HuaqiuOpenHardware/Comake-Pi-D2/enclosure/README.md

# 外壳/结构件说明

请在上传前检查解压内容中是否包含 `.stl`、`.step`、`.stp`、`.iges` 等外壳或结构件文件。

如果原项目没有提供结构件资料，本目录可仅保留此说明文件。
