HuaqiuOpenHardware/Comake-Pi-D2/REVIEW_CHECKLIST.md

# 上传前检查清单

- [ ] 仓库名已确认：`Comake-Pi-D2`
- [ ] GitHub About 已确认：星宸科技 AI 开发板 Comake Pi D2：用于便捷类相机、可穿戴设备、智能家居、无人机等应用市场低功耗轻量级端侧 AI 产品。
- [ ] 项目标题正确：Comake Pi D2
- [ ] 项目作者正确：星宸科技(SigmaStar)
- [ ] 开源协议正确：GPL 3.0
- [ ] README 封面图、原理图和 PCB 图显示正常
- [ ] `hardware/`、`docs/`、`assets/`、`enclosure/` 分类合理
- [ ] 解压目录无不应公开内容
- [ ] README 已经人工检查并确认
- [ ] 确认后再上传 GitHub
