HuaqiuOpenHardware/Comake-Pi-D2/hardware/pcb/Comake-Pi-D2-V1.0_BGA8_9.5_Demo_20251215/extracted/Comake-Pi-D2-V1.0_BGA8_9.5_Demo_20251215/资料阅读指南.pptx

启动方式选择/注意事项


以选SPI Nor SKIP SD启动为例：先选中对应行之后可以知道M3：0选为1111


M3:0的高低电平选择，决定了SOC是从哪种存储介质启动
1. 启动方式没有选择SKIP SD，则任意启动方式都可以从SD卡烧录，注意这里的SD要接在PAD_SD0,不能是任意SD
2. 没有选择SKIP SD启动比SKIP SD启动会多一些时间（200ms左右，实测为准）
3. 任意启动方式都可以从USB升级/空片烧录

## Slide 2

HW Checklist 阅读-IO MAPPING/MISC_Table

●HW Checklist里面的IO Mapping本身为我司DEMO Board IO功能分配所制作的表格，方便快速核查DEMO
接口用法，简单罗列了所用IO的内部上下拉状态、复用功能

●HW Checklist里面的MISC_Table为该IC所有IP的复用表，如下以I2C0复用为例：
1. 先选中功能行，在功能行中搜索I2C，可以自动定位到如下位置，可以看到有I2C0/I2C1/I2C2三个IP


2. I2C0的不同mode代表复用在不同的GPIO上面，这里以mode2
为例，表示I2C0 想复用在PAD_GPIO0/1上面需要软件选为mode2
，想复用在PAD_PM_GPIO0/1上面就选为mode3
3. I2C0只能复用在表中有的mode对应的GPIO上面，不能任意更改
4. 如已经选择mode2复用在PAD_GPIO0/1上面，则其他mode也不
能使用了


## Slide 3

HW Checklist 阅读-PM与NON-PM

1. 在Checklist中的MISC_Table_PM_List 与MISC_Table_PAD_list在没有单独使用CM4的情况下可以合并使用
带PM的GPIO功能受CA32内核控制，不用特别区分功能差异
2. 原理图或者规格书中GPIO名字带PM字样的均属于CM4核的IO，可以被CA32控制，也可以CM4单独控制

## Slide 4

HW Checklist 阅读-GPIO_Ctrl_Reg_Table

●GPIO_Ctrl_Reg_Table 包含GPIO默认内部上下拉，驱动电流大小调整方式等内容

●Reset Value即为SOC上电完成后，软件还没起来时刻IO的默认状态，下图表示该PAD_I2C1_SDA 默认是输入
内部有上拉电阻

●Internal pull up/down resister显示内部上下拉电阻值大小，精度一般在±30%，下图表示Pad_I2C1_SDA的内部
上拉电阻为97KΩ（典型值），PE/PS表示软件设置上下拉的寄存器位置，例如这里的PE PS默认都是1，PS改为0则变
为下拉状态，阻值为96KΩ

## Slide 5

HW Checklist 阅读-GPIO_Ctrl_Reg_Table

●DRV表示该PAD_I2C1_SDA的驱动电流挡位以及对应寄存器位置为bank103e 00 bit7/ 01 的bit8位置

●这里详细介绍一下GPIO的输入输出设定方法：所有输入默认电平都由内部和外部上下拉状态决定，输出为推挽方式
可以理解为与上下拉关系不大，为强输出

●bank103e 00 bit2位置为0表示该GPIO为输出状态，此时看OUT位置的bank103e 00 bit1，设为1则输出高，设为
0则输出低电平；如00 bit2为1则该GPIO为输入状态，读取IN下面的 bank103e 00 bit0状态可以确认外部电平状态，
此时如果引脚悬空，读取的状态为内部上下拉电阻状态决定

## Slide 6

HW Checklist 阅读-MIPI_RX_VIF

●MIPI RX_VIF 为SOC默认的MIPI线序，建议使用默认推荐线序，方便软件调试


## Slide 7

D2底板改为MIPI2+2 rework方式

●参考Pi D2 硬件说明3.1.15章节


●Rework完效果
