HuaqiuOpenHardware/Comake-Pi-D2/hardware/pcb/WQ7036平台硬件IO资源分配表.xlsx

电平 | P-Num. | NAME | Deepsleep模式下状态 | 设计应用注意点特别说明 | 方案实际设计应用 | 说明/备注 | 功能
外部供电3.3/1.8V | A17 | GPIO00（3.3/1.8V）/TCK | PD | JTAG | SPI/PDM/I2S/UART/PWM/TCK | EMMC_GPIO0 | EMMC1.8V控制
 | C17 | GPIO01（3.3/1.8V）/TXD0 | PU | 下载专用 | UART_TXD烧录专用 | SOC_UART_RX-1.8v | TWS串口
 | A16 | GPIO02（3.3/1.8V）/RXD0 | PU | 下载专用 | UART_RXD烧录专用 | SOC_UART_TX-1.8v
 | B15 | GPIO03（3.3/1.8V）/TMS | PU | JTAG | SPI/PDM/I2S/I2C/UART/PWM/TMS | SEL2 | USB SW选择
 | B16 | GPIO04（3.3/1.8V）/TDI | PU | JTAG | SPI/PDM/I2S/I2C/UART/PWM/TDI
 | D17 | GPIO05（3.3/1.8V）/TDO | PD | JTAG | SPI/PDM/I2S/UART/PWM/TDO | PWR_L_EN | 光敏电源控制
外部供电3.3/1.8V | N10 | AON_GPIO0/GPIO93 | PU/可配置 |  | SPI/PDM/I2S/I2C/UART/PWM | GPI | SENSOR_GPI
 | M10 | AON_GPIO1/GPIO94 | PU/可配置 |  | SPI/PDM/I2S/I2C/UART/PWM | I2S_WS | 传声音给309
 | N11 | AON_GPIO2/GPIO95 | PU/可配置 |  | SPI/PDM/I2S/I2C/UART/PWM | I2S_DATA
 | M11 | AON_GPIO3/GPIO96 | PU/可配置 |  | SPI/PDM/I2S/I2C/UART/PWM | I2S_BCK
 | M12 | AON_GPIO13/GPIO101 | PD/可配置 |  | SPI/PDM/I2S/I2C/UART/PWM | V_GPIO4 | DDR 电源控制
 | M13 | AON_GPIO14/GPIO102 | PD/可配置 |  | SPI/PDM/I2S/I2C/UART/PWM | GPO | SENSOR_GPO
 | M14 | AON_GPIO15/GPIO103 | PD/可配置 |  | SPI/PDM/I2S/I2C/UART/PWM | V_GPIO2 | wifi_1.8控制
内部供电1.8V | E4 | ADC0/GPIO105 | PD | 1、作ADC时量程0.1V ~ 1.15V | SPI/PDM/I2S/UART/PWM/ADC | V_GPIO3 | Sensor电源控制
 | E5 | ADC1/GPIO106 | PD |  | SPI/PDM/I2S/UART/PWM/ADC | SPI_CK | 收小图
 | B7 | ADC2/GPIO107 | PD |  | SPI/PDM/I2S/UART/PWM/ADC | SPI_DO(OUT)
 | B8 | ADC3/GPIO108 | PD |  | SPI/PDM/I2S/UART/PWM/ADC | SPI_CS
 | A9 | ADC4/GPIO109 | PD |  | SPI/PDM/I2S/UART/PWM/ADC | SPI_DI(INPUT)
 | A10 | ADC5/GPIO110 | PD |  | SPI/PDM/I2S/UART/PWM/ADC | TWS_GPIO1
 | J4 | NC | / |  | /
 | M5 | TK2/GPI99 | 可配置 | 做数字IO时只能做输入 | Touch/GPI
 | N6 | TK3/GPI100 | 可配置 | 做数字IO时只能做输入 | Touch/GPI | KEY | 按键拍照录像
 | M6 | TK4 | / | 只能做TOUCH | TOUCH
 | N7 | TK5 | / | 只能做TOUCH | TOUCH
 | E13 | GPO32 | PU |  | SPI/PDM/I2S/I2C/UART/PWM | I2C_SCL-Light | 光敏IIC
 | J13 | GPIO33 | PU |  | SPI/PDM/I2S/I2C/UART/PWM | I2C_SDA-Light
 | G13 | GPIO34 | PU |  | SPI/PDM/I2S/I2C/UART/PWM
 | G14 | GPIO35 | PU |  | SPI/PDM/I2S/I2C/UART/PWM
 | A14 | GPIO36 | PU |  | SPI/PDM/I2S/I2C/UART/PWM | INT_Light | 光敏中断
 | J12 | GPIO37 | PU |  | SPI/PDM/I2S/I2C/UART/PWM
 | J10 | GPIO38 | PU |  | SPI/PDM/I2S/I2C/UART/PWM | GPIO_NO
 | B14 | GPIO39 | PU |  | SPI/PDM/I2S/I2C/UART/PWM | LMICVDD_EN | MIC电源控制
 | E14 | GPIO40 | PU |  | SPI/PDM/I2S/I2C/UART/PWM | TWS_SOC_UART_TX | TWS_SOC交互串口
 | E12 | GPIO41 | PU |  | SPI/PDM/I2S/I2C/UART/PWM | TWS_SOC_UART_RX
 | A13 | GPIO44 | PU |  | SPI/PDM/I2S/I2C/UART/PWM | SEL1 | USB SW选择
 | B13 | GPIO45 | PU |  | SPI/PDM/I2S/I2C/UART/PWM | I2S_WCK
 | B12 | GPIO46/BootMode | PD | Boot strapping专用管脚 （需要上拉到VDD18才可下载） | BOOT | testpoint
 | A12 | GPIO47 | PD |  | SPI/PDM/I2S/UART/PWM | V_GPIO5 | 整机（除TWS）电源控制
 | A11 | GPIO48 | PD |  | SPI/PDM/I2S/UART/PWM | BT_WF0 | PTA
 | B11 | GPIO49 | PD |  | SPI/PDM/I2S/UART/PWM | WF_BT
 | B10 | GPIO50 | PD |  | SPI/PDM/I2S/UART/PWM | PWR_GY_EN | Gyso电源控制
 | E10 | GPIO51 | PD |  | SPI/PDM/I2S/UART/PWM | EMMC_GPIO1 | EMMC3.3V控制
 | E9 | GPIO52 | PD |  | SPI/PDM/I2S/UART/PWM | I2S_RX_DI(OUTPUT) | 传声音给309
 | E8 | GPIO53 | PD |  | SPI/PDM/I2S/UART/PWM | I2S_RX_WCK
 | E7 | GPIO54 | PD |  | SPI/PDM/I2S/UART/PWM | I2S_RX_BCK
 | M8 | GPIO55 | PD |  | SPI/PDM/I2S/UART/PWM | BT_WF1 | PTA
 | M9 | GPIO56 | PD |  | SPI/PDM/I2S/UART/PWM | BT_WF2
 | J5 | GPIO57 | PD |  | SPI/PDM/I2S/UART/PWM | V_GPIO1 | 309电源控制
 | G4 | GPIO58 | PD |  | SPI/PDM/I2S/UART/PWM | DMIC_L0_DATA2 | DMIC
 | J7 | GPIO59 | PD |  | SPI/PDM/I2S/UART/PWM | DMIC_L0_DATA1
 | J8 | GPIO60 | PD |  | SPI/PDM/I2S/UART/PWM | DMIC_L0_CLK
 | J9 | GPIO61 | PD |  | SPI/PDM/I2S/UART/PWM | OEB | USB SW使能
 | 设计应用注意项补充说明： 1、AON33/AON18电源在DS（关机状态）是不掉电的，设计应用时需要注意； 2、所有数字IO应用时需要注意DS状态下的上下拉状态是否会导致电路漏电或其他缺陷，这个很重要。注：PU/PD的上下拉Typ 80K 4、AON_GPIOXX和GPI97/GPI99/GPI100为Always active管脚，可作关机后中断输入唤醒源。注意GPI97/GPI99/GPI100作为数字IO时仅能做输入。 5、有两组IO（GPIO01~GPIO05和AON_GPIOXX）可通过外部供电输入决定其电平的（1.8V~3.3V可改）。其他数字IO都是固定1.8V
