HuaqiuOpenHardware/Comake-Pi-D2/hardware/bom/SSZ029D-S01D-D2_BOMLIST20260414.xlsx

Sheet: SSZ029D-S01C-D2_BOMLIST
Item | Name | Part | PCB Footprint | Reference | Quantity | 供应商 | 联系方式
______________________________________________
1 | 贴片电容 | 0.5pF/0201 | C0201 | WC12 | 1
2 | 贴片电容 | 1pF | C01005 | TWC52,TWC54,TWC55 | 3
3 | 贴片电容 | 1.2pF/0201 | C0201 | WC11 | 1
4 | 贴片电容 | 8pF | C01005 | C532,C533 | 2
5 | 贴片电容 | 10pF | C01005 | PC37,PC94,PC102,PC104,PC105,PC108 | 6
6 | 贴片电容 | 33pF | C01005 | TWC23 | 1
7 | 贴片电容 | 10nF | C01005 | PC127 | 1 |  |  | 新增
8 | 贴片电容 | 0.1uF/10V/X7R | C01005 | C116,C118,C123,C157,C159,C174,C178,C211,C227,C239,C413,C444,C965,C995,C1021,C1032,C1036,C1038,C1043,C1045,MC7,TWC12,MC12,PC16,TWC17,PC17,WC21,PC25,PC33,PC36,TWC58,PC66,PC68,TWC71,PC71,PC78,PC88,PC93,PC98,PC101,PC111,PC113,PC117,PC119,PC121,PC123,PC125,WC13,WC24,WC26,C103,MC2 | 52
9 | 贴片电容 | 1uF/10V/X5R | C0201 | PC67,C179,C180,C1025,C177,C237,C297,C1034,C1037,C1041,PC112,PC122,PC126,C973,MC11,WC1,TWC1,TWC2,TWC3,TWC4,WC5,SC5,WC6,TWC6,WC7,SC7,WC8,TWC8,WC9,TWC9,SC9,WC10,TWC10,TWC11,SC12,TWC13,SC14,WC15,WC16,TWC16,WC17,TWC18,PC18,TWC19,TWC20,PC20,TWC21,PC21,PC22,PC30,PC31,PC32,PC76,PC83,PC97,C496,C1024 | 57 |  |  | 新增2
10 | 贴片电容 | 2.2uF/10V/X5R | C0201 | C2,C127,C236,C1022,PC14,C102,C230,C994,C1044,MC1,MC4 | 11
11 | 贴片电容 | 2.2uF | C0402 | PC103,PC38 | 2
12 | 贴片电容 | 4.7uF/10V/X5R | C0201 | PC27,PC70,C1019,C1035,C136,C497,C964,C176,C1042,MC10,PC13,TWC24,TWC25,TWC26,PC7,SC6,SC8,SC10,SC11,SC13,TWC56 | 21
13 | 贴片电容 | 10uF/10V/X5R | C0201 | C124,C160,C161,C3,PC26,PC34,PC69,PC79,PC99,C1033,C228,PC8,PC5,PC6,TWC22,WC14,WC20,WC23,WC25,PC35,PC92,PC100 | 22
14 | 贴片电阻 | 0R | R0201 | PR105,PR107,PR113,PR123,PR129,PR134,PR136,PR142,R166 | 9
15 | 贴片电阻 | 0R_1% | R01005 | PR140 | 1
16 | 贴片电阻 | 0R | R01005 | SR26,SR27,SR28,SR55,SR59,SR60,SR61,R904,R937,SR17,SR18,PR150,R1576,R1577,R1579,R1581 | 16 |  |  | 新增5
17 | 贴片电阻 | 22R | R01005 | WR10,WR11,WR12,WR13,WR14,WR15,TWR18 | 7
18 | 贴片电阻 | 80.6/1% | R0201 | RM19 | 1
19 | 贴片电阻 | 100R | R01005 | WR17,WR18,R878,R879,R935 | 5
20 | 贴片电阻 | 240/1% | R01005 | RM18 | 1
21 | 贴片电阻 | 3K%1 | R01005 | PR148 | 1 |  |  | 新增
22 | 贴片电阻 | 3.3K | R01005 | R91,R96 | 2
23 | 贴片电阻 | 4.7K | R01005 | TR27,SR62,SR63,R650,R651,R938 | 6
24 | 贴片电阻 | 10K | R01005 | TWR1,WR2,TWR2,MR2,TWR3,SR3,TWR4,SR4,TR28,TWR33,TWR34,TWR43,TWR53,TWR55,TWR56,TWR57,PR143,PR144,R892,R893,R936 | 21
25 | 贴片电阻 | 12.4K%1 | R01005 | PR147 | 1 |  |  | 新增
26 | 贴片电阻 | 20K_1% | R01005 | PR108,PR135 | 2
27 | 贴片电阻 | 40K_1% | R0201 | PR109,PR137 | 2
28 | 贴片电阻 | 100K | R01005 | R933,R934,R1574,PR145,PR146 | 5 |  |  | 增加两个
29 | 贴片电阻 | 150K/1% | R01005 | WR9 | 1
30 | 贴片电阻 | 200K/1% | R01005 | WR8 | 1
31 | 贴片电阻 | 445K_1% | R0201 | PR10 | 1
32 | 贴片电阻 | 1M | R01005 | WR1 | 1
33 | 贴片电阻 | 1M_1% | R01005 | PR126,PR130,PR141 | 3
34 | 贴片电阻 | 1.2M_1% | R01005 | PR132 | 1
35 | 贴片电阻 | 2M_1% | R01005 | PR138,PR139 | 2
36 | 贴片电感 | SDHK100608HA4RTMTY01 4.7uH 0.5A | PIM100608 | TWL2,TWL4,TWL6 | 3
37 | 贴片电感 | MWTC160808S2R2 2.2uH 1.2A | PIM160808 | PL6,PL8,PL9,PL10,PL7,PL11 | 6
38 | 贴片电感 | SDHK1608HB100MT 2.2uH 2.3A | PIM201208 | WL4 | 1
39 | 贴片磁珠 | 1nH | L0201 | WL2 | 1
40 | 贴片磁珠 | 2.7nH | L0201 | WL1 | 1
41 | 贴片磁珠 | 18nH It 200mA | L0201 | TWL1,TWL3,TWL5 | 3
42 | 贴片磁珠 | 60R | L0201 | FB1 | 1 |  |  | 新增
43 | 贴片磁珠 | 1K@100M | L0201 | TWR19,TWR20 | 2
44 | PMOS | PMOS_VGSth<1.8V/AW402030 | DFN1006 | TWQ3 | 1 | 艾为
45 | NMOS | AW402010/PNM3FD20V2 | DFN1006 | TWQ1,TWQ2,TWQ4,TWQ11,TWQ12,TWQ13,TWQ14,TWQ15,TWQ19,Q30 | 10 | 艾为
46 | 24pin贴片母座 | BK13C06-24DS/2-0.35V | SMD-28-DS | SJ3,SJ4,SJ0 | 3
47 | USB3.0座子 | USB_TypeC_Part No: USB-24P-9_95-C | USB-24P-9_95-C | J1 | 1
48 | miniwifi天线座子 | IPEX4 | Minii-RF | JT1 | 1
49 | 贴片晶体 | Crystal/[24MHz,8pF,∮10ppm]; /XT114-10 | 24M8PI-1.6X1.2 | Y1,X2 | 2 |  | 裕中科技
50 | 贴片晶体 | Crystal/[32MHz,8pF,∮10ppm]/XT114-10 | 32M8PI-1.6X1.2 | Y2 | 1
51 | 贴片蓝牙天线 | BT ANT | YF1608 | U4 | 1
52 | 光敏IC | OPT3004 | DNP-6 | U5 | 1
53 | EMMC | BWCTL0211X32G/FEM6NN064G-A3N14 | IC-0.5MM153P-FBGA-S | MU1 | 1 | 金士顿/佰维/SCY/江波龙
54 | DCDC | TMI3181D | DFN1.6 | PU3,PU8,PU9,PU10,PU11,PU12,PU13 | 7 | 拓尔
55 | TWS IC | WTS | WQ7036A/AX | TWU1 | 1 | 物琪
56 | ISP | SSC309QL | IC-242P-P05-8X9.5 | U1 | 1 | SIGMA
57 | USB Switch | AW35753 | WLCSP-12 | U2 | 1 | 艾为
58 | 数字功放 | AW88082 | FC9 | U3 | 1 | 艾为
59 | LS IC | AW39114 | FOWLP | U7 | 1 | 艾为
60 | Loadswitch | ETA7027CSE | WLCSP0.87X0.87 | U9,U13,U15,U16,U19,U20,U21,U22,U23 | 9 | ETA
61 | DCDC | TMI6038D-28 | DFN1X1 | U12 | 1 | 拓尔
62 | LDO | ETA5055V105DD1E | DFN1X1 | U14 | 1 | ETA
63 | LDO | TMI6011 | DFN3X3 | PU14 | 1 | 拓尔
64 | WIFI | SSW118GE | QFN60-5X5-04MM-S | WU1 | 1 | SIGMA
 | 差异化BOM：音频走SSC309QL
 | 删除如下位号物料
 | 贴片电阻 | 0R | R01005 | R1576,R1577,R1579,R1581 | 4
 | 增加如下位号物料
 | 贴片电阻 | 0R | R01005 | R1575,R1578,R1580 | 3

Sheet: NC
28 | NC/10K | R01005 | MR1,R876,R877 | 3
36 | NC/100nF | C0402 | PC29,PC38,PC73,PC95,PC109 | 5
39 | NC/100nF | C0201 | PC84,PC85 | 2
55 | NC | R01005 | TWR54,R89 | 2
57 | NC | R0201 | R165 | 1
93 | NC/22R | R01005 | WR16 | 1
65 | NC | C0201 | TWC5,TWC7,TWC57,TWC59,TWC60,TWC61,TWC68,TWC69,TWC70 | 9
62 | NC/30pF | C0201 | SC3,SC4 | 2
23 | NC/2.2uF_6.3V | C0201 | MC3 | 1
13 | NC | C01005 | C521 | 1
70 | SE_OUT | TP-0_8MM | TWP4 | 1
PR150增加
