HuaqiuOpenHardware/Comake-Pi-D2/hardware/bom/SSZ029D-S01D-D2_MAINBOARD_BOMLIST20260414.xlsx

Sheet: SSC309-S01C-D2-MAINBOARD_BOM_20
Item | Name | Part | PCB Footprint | Reference | Quantity | 供应商 | 联系方式
______________________________________________
1 | 贴片电容 | 22pF/6.3V/X5R | C0402 | PC19 | 1
2 | 贴片电容 | 0.1nF/6.3V/X5R | C0402 | C25,C26 | 2 |  |  | 新增
3 | 贴片电容 | 10nF/6.3V/X5R | C0402 | C4,PC127 | 2 |  |  | 新增1
4 | 贴片电容 | 47nF/10V/X5R | C0603 | C22,C23
5 | 贴片电容 | 0.1uF/6.3V/X5R | C0402 | PC2,PC14,PC22,PC27,C9,C11,SC12,C12,C14,C15,SC19.SC20,C17,C6 | 13
6 | 贴片电容 | 0.22nF/10V/X5R | C0402 | C24
7 | 贴片电容 | 1uF/10V/X5R | C0402 | PC12,SC2,SC5,SC8,SC10,PC11,SC13,SC15 | 8
8 | 贴片电容 | 2.2uF/10v/X5R | C0402 | C5 | 1
9 | 贴片电容 | 2.2uF/10v/X5R | C0603 | C19,C20
10 | 贴片电容 | 4.7uF/10V/X5R | C0402 | PC7,SC1,PC3,SC6,SC7,SC9,PC9,PC13,C1,SC14,SC16 | 11
11 | 贴片电容 | 4.7uF/10V/X5R | C0603 | C18,C21 | 2
12 | 贴片电容 | 10uF/10V/X5R | C0603 | PC15,PC8,PC5,PC23,PC4,PC6,PC10,C10,SC11,C16,C13,SC17,SC18 | 13
13 | 贴片电容 | 22uF/10V/X5R | C0805 | PC16,PC17,PC20,PC21,PC24,PC26,PC1 | 7
14 | 贴片电阻 | 0R | R0402 | SR1,R1,SR2,R2,SR5,SR6,SR7,SR8,SR9,SR10,SR11,SR12,SR13,SR14,SR15,SR16,SR17,SR18,SR19,SR20,SR21,SR22,SR23,SR24,SR25,SR26,SR27,SR28,SR29,SR30,SR32,SR35,SR36,R47,R56,R60,R62,R63,R64,R65,R66,R67,R68,R69,R70,R71,R72,R73,R76,R77,R78,R79,R80,R82,R83,R84,R85,R86,R87,R88,R91,R92,R93 | 63
15 | 贴片电阻 | 0R | R0805 | R49 | 1
16 | 贴片电阻 | 0R | L0603 | B1,B2 | 2
17 | 贴片电阻 | 22R | R0402 | R6,R17,R18,R19,R20,R21,R24,R25,R26,R27,R28,R29,R30,R31,R32,R33,R34,R35,R36,R37,R38,R51 | 22
18 | 贴片电阻 | 100R | R0402 | R4,R5,R13,R14,R15,R16 | 6
19 | 贴片电阻 | 1K | R0402 | R11,R9,R46,R52,R54 | 5
20 | 贴片电阻 | 2K | R0402 | R57,R95 | 2
21 | 贴片电阻 | 3K%1 | R0402 | PR148 | 1 |  |  | 新增1
22 | 贴片电阻 | 4.7K | R0402 | TWR1,TWR3,TR2,R12,R40,R41,R44,R45,R55,R58,R59,R74,R75 | 13
23 | 贴片电阻 | 10K | R0402 | R3,R10,R53,R89,R90,TWR33,TWR34 | 7 |  |  | 新增2
24 | 贴片电阻 | 12.4K%1 | R0402 | PR147 | 1 |  |  | 新增1
25 | 贴片电阻 | 47K | R0402 | PR4,PR7 | 2
26 | 贴片电阻 | 100K | R0402 | R7,R8,R50,R61,PR145,PR146 | 6 |  |  | 新增2pcs
27 | 贴片电阻 | 150K/1% | R0402 | PR1 | 1
28 | 贴片电阻 | 680K_1% | R0402 | PR6 | 1
29 | 卧式贴片座子 | CON2-H | CON2_125 | J2 | 1
30 | 插件座子 | Wafer/2.0mm/1*4p/Male | B2.0V-L4P | CON1,CON2,CON3 | 3
31 | 插件座子 | CON2-DIP-2.0mm | DIP1X02PM-80-V | CON4,CON5,CON6 | 3
32 | 插针 | Header/2.54mm/1*3p/180D/Male | JP-1X3 | JP2,JP52,JP53,JP54,JP55 | 5 |  |  | 增加2
33 | 插针 | 2pin 插针 | JP-1X2 | JP1,JP3 | 2
34 | 插针 | 4pin 2.54MM 插针 | JP-1X4 | JP56,JP57,JP58 | 3 |  |  | 新增
35 | 插针 | 双排16pin 插针 | JP-1X16 | J4 | 1
36 | 插针 | 双排18pin 插针 | JP-1X18 | J6 | 1
37 | 贴片座子 | FPC-CON10_Down_Type 1.0mm间距 | IL-FHR-10S | JP26 | 1
38 | 贴片座子 | FPC-CON6_Down_Type | IL-FHR-6S | JP27 | 1
39 | 贴片座子 | FPC-36-0.5MM-FL | FPC-36-0.5MM-FL | SJ1,SJ6 | 2
40 | 贴片座子 | CON10-0D5 | FPC10-0.5-2 | J5 | 1
41 | 贴片座子-公头 | BK13C06-24DP/2-0.35V | SMD-24-Male | SJ3,SJ4,SJ0 | 3
42 | 贴片座子-母头 | BK13C06-24DS/2-0.35V | SMD-24-DS | SJ5 | 1
43 | 按键 | TACT_SWITCH_90 | SW-4P-1102V | SW1,SW2 | 2
44 | USB座子 | USB_TypeC_Part No:USB24P-C317JD | USB24P-C317JD | J1 | 1
45 | LED灯 | LED/Blue_1.8V | LED-0603 | LED1 | 1
46 | 贴片电感 | 2.2uH/VMPI0420ED2R2MT/3A | VMPI0420ED2R2MT | L1 | 1
47 | 贴片Nmos | 2N7002 | SOT-23DGS | PQ1,PQ2,PQ3,PQ4,PQ5,Q1 | 6
48 | 陀螺仪 | Q6_ICM-42607 | LGA14_2.5X3.0 | U2 | 1
49 | 光敏 | OPT3004 | DNP-6 | U5 | 1 |  |  | 新增
50 | AMP IC | AW8737AQNR | WLQFN | U4 | 1 | 艾为
51 | IRCUT | TMII8113/MS3111S | SOT23-6 | U3 | 1 | 拓尔
52 | DCDC | TMI3411 | SOT23-5P | PU2 | 1 | 拓尔
53 | LDO | TMI6036-18 | SOT23-5P | PU1 | 1 | 拓尔
54 | 模拟开关 | ETA7027CSE | WLCSP0.87X0.87 | U1 | 1 | ETA
 | LDO | TMI6011 | DFN3X3 | PU14 | 1 | 拓尔

Sheet: NC
63 | NC/47K | R0402 | TR3 | 1
60 | NC/0R | R0402 | SR31 | 1
56 | NC/30pF | C0402 | SC3,SC4 | 2
54 | NC | R0402 | R39,R48 | 2
38 | NC/2.2uF/10V | C0402 | PC28 | 1
35 | NC/100nF | C0603 | PC18 | 1
7 | NC/0.1uF | C0402 | C8 | 1
4 | NC | C0402 | C2,C3,C6,C7 | 4
12 | RESET_LPC | DRILL126X100_L | H1,H2,H3,H4 | 4
13 | RES | TP-0_8MM | I2C2_SDA_GY,I2C2_SCL_GY | 2
62 | RESET_LPC | TP | TP1 | 1
