HuaqiuOpenHardware/Comake-Pi-D2/hardware/pcb/SSC309QL_BGA8_9.5_LPDDR4x For AI Glass_HW Checklist V1.2 .xlsx

Sheet: History
History
Version | Date | Change list
V1.0 | 2025418 | Initial Version.
V1.1 | 20260107 | 更新GPIO_Ctrl_Reg_Table 中对PAD_RX_CH PE/PS的reg位置描述
V1.2 | 20260113 | 更新MISC_Table_PAD_List的reg位置描述
V1.3 | 20260206 | 新版本兼容支持DMIC+AO
说明
MISC_Table_PAD_list是CA32对整个IC（包括CM4） IO复用关系说明
MISC_Table_PM_List 只是CM4 IO复用关系说明文档，CM4 IO在CA32断电情况下可以继续使用

Sheet: Schematic Checklist
 |  |  |  | 修改日期
 | Hardware Spec | V1.2
 | Main Chip
 | Date | 2026-01-13
 | Review
Item List | Test Item | No. | Description
1 | GPIOx | 1 | PAD_PM_GPIO4及PAD_PM_GPIO5 固定用做IDAC核心电压调整,分别用作VDD和CPU的调整，请勿用作其他用途
 |  | 2 | 带中断功能的GPIO口请查看《GPIO_Ctrl_Reg_Table》，注意需要中断输入时GPIO口的选定
 |  | 3 | GPIO的分配请尽量按照Demo板的分配来设计，软件统一性好，便于维护及更新
 |  | 4 | 在选定GPIO口时，要注意其功能使用，且详细核对我司芯片内部的默认上下拉状态，以防开机误动作
 |  | 5 | 芯片中各GPIO口的输出驱动电流大小在Datasheet中有标明，但若是作为灌电流时，部分GPIO最大为16mA，超过时请用三极管或MOS去控制
 |  | 6 | IC同一个信号会复用到不同的Pin脚上（如PWMx），若在其中一个Pin脚上使用了该信号，在另一个Pin上就用不了该信号功能了
 |  | 7 | PWMx有同步功能，保证4个PWM时序正确去控制电机，但必须为同一个Group去控制一个Motor，如：PWM0~3，PWM4~7
 |  | 2 | SAR_GPIOx和GPIOx信号若是跨板连接时，为提高其ESD能力，请在信号线上串10～33R电阻，推荐为22R，若是在板内，则可以不接该电阻
 | Uart | 1 | PM_UART_RX，PM_UART_TX固定用做debug使用（请在TX上增加4.7K上拉电阻,在TX/RX上串100R电阻以提高抗ESD能力），请勿用做其他用途
 | I2S | 1 | I2S接口中I2S_SDI为I2S Data Input，I2S_SDO为I2S Data Output，切勿弄错
 | I2C | 1 | I2C在使用时需要外部接上拉电阻，否则无法工作，其工作最大频率可以到400KHz
 | USB | 1 | USB默认为Host mode，用做WIFI功能，可通过软件配置改为Device mode，用做UVC功能
 | Audio | 1 | 若是有音频功放芯片时，需要一个GPIO口去控制功放芯片开启时间，避免音频开启时的POP声
 |  | 2 | Audio_IN是即可作为单端也可以作为差分使用，建议按照我司Demo board电路来设计，隔直电容靠近IC端放置
 | DMIC | 1 | 我司DMIC最多只能接两个Data Channel，即最多只能接4个DMIC，可以与AMIC同时接入
 | SPI | 1 | SPI-SDI接MOSI，SPI-SDO接MISO，其他做Master的SPIx口也是如此。DI为Master Out Slave In，DO为MISO，SPI_Slave mode下DI则为INPUT，DO为OUTPUT
 |  | 2 | PSPI只支持半双工模式，MSPI支持全双工
 |  | 3 | 我司SPI_CZ为Low Active，若是Device为High Active，则需要加一个NPN管做反向
 | SD Card | 1 | 需要使用SD卡功能时，SDx_CDZ和SDx_POWER_EN一定要接，缺一不可
 |  | 2 | PM_GPIO11芯片内部配为SD_POWER_EN，不能更改，该脚直接连P_MOS的栅极控制SD卡电源导通情况，Low Active
 | Reset | 1 | Reset 为 High active，确认设定是否正确
 | HW strapping | 1 | HW strapping如下图设置，请严格按照表格来配置，否则会无法启动
2 | Power Check | 1 | 检查电源IC及路径上串的磁珠、DC-DC功率电感规格和Caps是否符合电流的要求，走线尽量粗和短
 |  | 2 | 检查DC-DC反馈电阻阻值是否设置正确
 |  | 3 | 检查电源端对地电容耐压是否符合设计规格
 |  | 4 | 确认Core电压IDAC动态调压电路是否有预留，并确认开机时启动电压是否设定正确（default 0.9V启动）
 |  | 5 | SD Card的供电电路，请在靠近SD card connecter端对地加2Kohm/0402 (必要时会调整阻值)
 |  | 6 | AVDD18_AUD是IC内部Audio部分供电, 请和其他AVDD用磁珠隔离开，Audio部分电路请完全按照我司demo板电路来设计
 |  | 7 | AVDD18_ETH是IC内部PHY部分供电，建议和其他AVDD用磁珠隔开
 |  | 8 | Sensor的模拟电源要注意避免干扰源，防止被干扰，带来电源噪声，影响图像品质
 |  | 9 | SOC所有电源IO都要求必须给电
 |  | 10
3 | Crystal Check | 1 | 确认24MHz Crystal的规格，[24MHz，18pF，∮20ppm]，匹配电容容值是否正确
 |  | 2 | 确认RTC 32.768KHz Crystal的规格，[32.768KHz，12pF，∮20ppm]，匹配电容容值是否正确
 |  | 3 | 如果RTC不使用，XTAL_In和Xtal_OUT不可悬空，避免由于floating引入干扰，请短接后对地接一个100Kohm电阻
4 | Sensor Check | 1 | Sensor IO电平的电压固定只支持1.8V
 |  | 2 | 检查Sensor MCLK，注意是否有串10～33ohm匹配电阻，该电阻靠近芯片放置
 |  | 3 | DVP模式时检查Sensor PCLK，注意是否有串10～33ohm匹配电阻，该电阻靠近Sensor放置
 |  | 4 | 确认Sensor模拟电源AVDD是单独LDO供电，同时滤波电容需要大于22uF，做好防干扰处理
 |  | 5 | 检查Sensor和主控IC接口的正确性，请参考IO Mapping页面
 |  | 6 | I2C信号必须要有上拉电阻，并且要核对上拉电源是否正确
 |  | 7 | Sensor信号注意按照等长、差分、阻抗匹配等要求走线，保证信号完整性及抗干扰能力
 |  | 8

Sheet: PCB Checklist
 | Hardware Spec | V1.2
 | Main Chip
 | Date | 2026-01-13
 | Review
Item List | Test Item | No. | Description
1 | Power Check | 1 | 检查DC-DC功率电感旁边和相邻层是否有敏感的信号线走过
 |  | 2 | Core电压电流超过1A，确认core电压源头走线宽度大于80mil，源头出来换层至少要3个过孔，同时Core电压DC-DC反馈电阻取电需要从Core电压Pin端单独拉出来，这样做保证到IC pin端的电压稳定，De-couple Cap必须置于IC背面
 |  | 3 | 检查主控IC各电源pin滤波电容是否足够且至少有一个0.1uF电容靠近IC pin摆放（越近越好，请参照Demo Board设计）
 |  | 4 | Power IC和功率电感尽量远离主IC, 避免热量过于集中
 |  | 5 | 若电源需要拉很长的线时，则需要在远端增加大电容避免该电压波动过大
 |  | 6 | 禁止修改芯片封装中E-PAD大小，禁止在芯片下面走信号线，由于E-PAD较大，为防止锡过多将IC顶高，建议E-PAD处钢网打许多小孔加锡
 |  | 7 | Pin上的地线不要接到E-PAD上去，需另外连接到其他地上
2 | Clock Check | 1 | 检查24MHz/32.768KHz晶振周边和相邻层是否有敏感信号经过，同时晶振走线全程包地
 |  | 2 | 检查Sensor MCLK，PCLK走线是否包地，相邻层是否有敏感信号经过
 |  | 3
3 | Sensor Check | 1 | Sensor Data走线，如果是Parallel接口，Data和Pixel clock走等长等距，如果是MIPI走线，按差分线规则走线，整体包地、远离敏感信号
 |  | 2 | 检查Sensor模拟电源AVDD pin滤波电容是否靠近IC摆放，包地、相邻层是否有敏感信号经过
 |  | 3
4 | USB Check | 1 | 检查USB中DP&DM的走线是否有包地， 线宽线距有无符合Layout guide
 |  | 2 | 若是引线到座子上时，注意增加ESD防护器件，且就近座子放置
5 | Audio Check | 1 | 检查MIC_IN/Line_IN和Line_OUT走线是否全程包地，同时注意相邻两层是否有敏感信号与其平行走线
 |  | 2 | 音频输入输出口增加ESD防护器件，且就近座子放置
 |  | 3 | 保证MIC_IN的偏置电压干净，减少底噪干扰
 |  | 4 | DMIC走线是否全程包地，同时注意相邻两层是否有敏感信号与其平行走线
 |  | 5 | I2S走线是否全程包地，同时注意相邻两层是否有敏感信号与其平行走线
6 | Ethernet | 1 | 按差分线规则走线， 检查走线是否全程包地，同时注意相邻两层是否有敏感信号与其平行走线
 |  | 2 | Transformer layout 规范
 |  | 3 | Surge&ESD防护器件选型及layout规范
 |  | 4
7 | SD&SDIO Check | 1 | CLK走线做好包地、远离敏感信号等处理
 |  | 2 | 除CDZ信号外的其他信号做好等长、远离敏感信号，若是WIFI机型，建议信号尽量走内层，避免干扰WIFI信号
 |  | 3

Sheet: IO Mapping
Pin Num | Pin Name | Multi-Function1 | Multi-Function2 | Multi-Function3 | Interrupt | Reset Value | Used | Function | 备注 | 修改日期
AVDD18_NODIE( 1.8V)
C13 | PAD_PM_GPIO0 |  |  |  | Yes | PU | I2S0_RX_WCK | I2S_RX
B13 | PAD_PM_GPIO1 |  |  |  | Yes | PU | I2S0_RX_BCK
D11 | PAD_PM_GPIO2 |  |  |  | Yes | PU | I2S0_RX_SDI
A13 | PAD_PM_GPIO3 |  |  |  | Yes | PU
A14 | PAD_PM_GPIO4 |  |  |  | Yes | Hi-Z | IDAC
B15 | PAD_PM_GPIO5 |  |  |  | Yes | Hi-Z | PONV | GPI_681
E14 | PAD_PM_GPIO6 |  |  |  | Yes | PU | TESTOUT1 | GPO1_681
C14 | PAD_PM_UART2_TX |  |  |  | Yes | PU | SR_PDN_0
C15 | PAD_PM_UART2_RX |  |  |  | Yes | PU | TWS_GPIO1
D7 | PAD_PM_SDIO_D0 |  |  |  | Yes | PU | SDIO_DO | For Wifi
C8 | PAD_PM_SDIO_CMD |  |  |  | Yes | PU | SDIO_CMD
C7 | PAD_PM_SDIO_D1 |  |  |  | Yes | PU | SDIO_D1
D8 | PAD_PM_SDIO_CLK |  |  |  | Yes | PD | SDIO_CLK
E10 | PAD_PM_SDIO_D2 |  |  |  | Yes | PU | SDIO_D2
E9 | PAD_PM_SDIO_D3 |  |  |  | Yes | PU | SDIO_D3
D12 | PAD_PM_SDIO_INT |  |  |  | Yes | PU | SDIO_RST
C12 | PAD_PM_I2C_CLK |  |  |  | Yes | PU | GYSO_I2C_SCL | GYSO_I2C
B14 | PAD_PM_I2C_SDA |  |  |  | Yes | PU | GYSO_I2C_SDA
B11 | PAD_PM_FUART_TX |  |  |  | Yes | PU | TWS_UART_TX | UART_TWS
B12 | PAD_PM_FUART_RX |  |  |  | Yes | PU | TWS_UART_RX
D10 | PAD_PM_SAR_GPIO1 |  |  |  | Yes | Hi-Z | X
C10 | PAD_PM_SAR_GPIO0 |  |  |  | Yes | Hi-Z | X
VDD3318_PM(3.3V or 1.8v)
F14 | PAD_PM_UART_TX |  |  |  | Yes | PU | PM_UART_TX | Debug Uart
G14 | PAD_PM_UART_RX |  |  |  | Yes | PU | PM_UART_RX
J13 | PAD_PM_PSPI0_INT |  |  |  | Yes | PU | I2S0_MCLK | I2S_RX
G12 | PAD_PM_PSPI0_DI |  |  |  | Yes | PU | PSPI0_DI | SPI_Slave-TWS
H12 | PAD_PM_PSPI0_DO |  |  |  | Yes | PU | PSPI0_DO
F12 | PAD_PM_PSPI0_CK |  |  |  | Yes | PD | PSPI0_CK
G13 | PAD_PM_PSPI0_CZ |  |  |  | Yes | PU | PSPI0_CZ0
J12 | PAD_PM_GPIO11 |  |  |  | Yes | PU | led | 状态指示灯
F13 | PAD_PM_GPIO10 | IRCUT_BIN | IRCUT_BIN |  | Yes | PU | X
E15 | PAD_PM_GPIO9 | DPIR_DL1 | IRCUT_AIN |  | Yes | PU | X
F15 | PAD_PM_GPIO8 |  |  |  | Yes | PD | BOOT_WTS
E12 | PAD_PM_GPIO7 |  |  |  | Yes | PD | X
D14 | PAD_PM_PWM1 |  |  |  | Yes | PD | X
D13 | PAD_PM_PWM0 |  |  |  | Yes | PD | Fsyn
VDDP3318_P0(3.3V or 1.8v)
U12 | PAD_FUART_RX |  |  |  | Yes | PU
U11 | PAD_FUART_TX |  |  |  | Yes | PU
V11 | PAD_FUART_RTS |  |  |  | Yes | PU | X
U13 | PAD_FUART_CTS |  |  |  | Yes | PU | X
V13 | PAD_MSPI_CZ |  |  |  | Yes | PU | X
U14 | PAD_MSPI_DO |  |  |  | Yes | PU | X
V14 | PAD_MSPI_DI |  |  |  | NA | PU | X
U15 | PAD_MSPI_CK |  |  |  | Yes | PD | X
T15 | PAD_SPI0_DO |  |  |  | Yes | PU | SPI0_DO | BOOT Flash &BOOT Strap
T14 | PAD_SPI0_DI |  |  |  | Yes | PU | SPI0_DI
M13 | PAD_SPI0_HLD |  |  |  | Yes | PU | SPI0_HLD
N14 | PAD_SPIO_WPZ |  |  |  | Yes | PU | X
R14 | PAD_SPI0_CZ |  |  |  | Yes | PU | X
P15 | PAD_SPI0_CK |  |  |  | Yes | PD | SPI0_CK
R13 | PAD_I2C0_SDA | I2C0_SDA |  |  | Yes | PU | X
T13 | PAD_I2C0_SCL | I2C0_SCL |  |  | Yes | PU | X
VDDP3318_P2 (3.3V or 1.8v)
N14 | PAD_GPIO0 |  |  |  | Yes | PU | X
N2 | PAD_GPIO1 |  |  |  | Yes | PU | EMMC_D1 | EMMC BOOT
M2 | PAD_GPIO2 |  |  |  | Yes | PU | EMMC_D0
P2 | PAD_GPIO3 |  |  |  | Yes | PD | EMMC_CLK
R2 | PAD_GPIO4 |  |  |  | Yes | PU | EMMC_CMD
P15 | PAD_GPIO5 |  |  |  | Yes | PU | EMMC_D3
T1 | PAD_GPIO6 |  |  |  | Yes | PU | EMMC_D2
M3 | PAD_GPIO7 |  |  |  | Yes | PU | EMMC_RSTN
R3 | PAD_GPIO8 |  |  |  | Yes | PU | X
P3 | PAD_GPIO9 |  |  |  | Yes | PU | X
T2 | PAD_GPIO10 |  |  |  | Yes | PU | X
N3 | PAD_GPIO11 |  |  |  | Yes | PU | X
U1 | PAD_SD0_CDZ |  |  |  | Yes | PU | X | NO SD
U2 | PAD_SD0_D1 |  |  |  | Yes | PU | X
V2 | PAD_SD0_D0 |  |  |  | Yes | PU | X
V3 | PAD_SD0_CLK |  |  |  | Yes | PD | DMIC_CLK
U3 | PAD_SD0_CMD |  |  |  | Yes | PU | DMIC_DATA
V5 | PAD_SD0_D2 |  |  |  | Yes | PU | X
U4 | PAD_SD0_D3 |  |  |  | Yes | PU | X
AVDD33_USB(3.3V)
G1 | PAD_DP_USB |  |  |  | NA | NA | USB_DP | Host & Device
G2 | PAD_DM_USB |  |  |  | NA | NA | USB_DM
AVDD18_AUD(1.8V)
L1 | PAD_AUD_MICIN0 |  |  |  | NA | NA | X | NO AUD
L2 | PAD_AUD_MICIN1 |  |  |  | NA | NA | X
H3 | PAD_AUD_LINEOUT_R0 |  |  |  | NA | NA | 支持
AVDD33_RTC(3.3V)
A10 | PAD_RTC_IO5 |  |  |  | NA | NA | X
B10 | PAD_RTC_IO4 |  |  |  | NA | NA | X
B9 | PAD_RTC_IO1 |  |  |  | NA | NA | X
B8 | PAD_RTC_IO0 |  |  |  | NA | NA | X
A8 | PAD_PM_RESET |  |  |  | NA | NA | PAD_RESET | IC硬件复位脚
B7 | PAD_XTAL_IN_32K |  |  |  | NA | NA | X | NO 32.768
B6 | PAD_XTAL_OUT_32K |  |  |  | NA | NA | X
AVDD33_ETH(3.3V)
J14 | ETH_RN |  |  |  | NA | NA | X | NO ETH
J15 | ETH_RP |  |  |  | NA | NA | X
H15 | ETH_TN |  |  |  | NA | NA | X
H14 | ETH_TP |  |  |  | NA | NA | X
VDDP18_P1 (1.8V )
C4 | PAD_SR_MCLK0 | MIPI00_MCLK |  |  | Yes | PD | MIPI_MCLK | VI接口
C5 | PAD_SR_RST0 | MIPI00_RST |  |  | Yes | PU | MIPI_RST
D5 | PAD_I2C1_SCL |  |  |  | Yes | PU | I2C1_SCL
D6 | PAD_I2C1_SDA |  |  |  | Yes | PU | I2C1_SDA
D4 | PAD_SR_MCLK1 | MIPI01_MCLK |  |  | Yes | PD
D3 | PAD_SR_RST1 | MIPI01_RST |  |  | Yes | PU
F3 | PAD_I2C2_SCL |  |  |  | Yes | PU | I2C2_SCL
E3 | PAD_I2C2_SDA |  |  |  | Yes | PU | I2C2_SDA
B4 | PAD_OUTP_RX0_CH0 | MIPI00_D1P |  |  | Yes | PD | MIPI_D2P
A5 | PAD_OUTN_RX0_CH0 | MIPI00_D1N |  |  | Yes | PD | MIPI_D2N
A3 | PAD_OUTP_RX0_CH1 | MIPI00_D0P |  |  | Yes | PD | MIPI_D0P
B3 | PAD_OUTN_RX0_CH1 | MIPI00_D0N |  |  | Yes | PD | MIPI_D0N
B2 | PAD_OUTP_RX0_CH2 | MIPI00_CKP |  |  | Yes | PD | MIPI_CKP
A2 | PAD_OUTN_RX0_CH2 | MIPI00_CKN |  |  | Yes | PD | MIPI_CKN
C1 | PAD_OUTP_RX0_CH3 | MIPI01_D1P |  |  | Yes | PD | MIPI_D1P
B1 | PAD_OUTN_RX0_CH3 | MIPI01_D1N |  |  | Yes | PD | MIPI_D1N
D2 | PAD_OUTP_RX0_CH4 | MIPI01_D0P |  |  | Yes | PD | MIPI_D3P
C2 | PAD_OUTN_RX0_CH4 | MIPI01_D0N |  |  | Yes | PD | MIPI_D3N
E1 | PAD_OUTP_RX0_CH5 | MIPI01_CKP |  |  | Yes | PD
E2 | PAD_OUTN_RX0_CH5 | MIPI01_CKN |  |  | Yes | PD
说明：请尽量按照我司IO分配来设计，可以统一软件，便于维护！
红色字体及黄色填充的部分不能更改
1
2
3
4
5
6
7

Sheet: MISC_Table_PAD_List
1 | 2 |  | change location
i6d
0
0
FID-00.001.0
v.000_00.00
i6d
enable
?um x?um,beforeshrunk,withsealring
0.9
BGA
 |  | reg[11FE20]#5 ~ #4 | reg[103CC1]#0 ~ #0 | reg[103CC1]#0 ~ #0 | reg[103CC1]#0 ~ #0 | reg[103CDE]#2 ~ #0 | reg[103CDE]#2 ~ #0 | reg[103CDE]#2 ~ #0 | reg[103CDE]#2 ~ #0 | reg[103CA6]#1 ~ #0 | reg[103CA6]#1 ~ #0 | reg[103C7C]#0 | reg[103CD8]#6 ~ #4 | reg[103CD8]#6 ~ #4 | reg[103CD8]#6 ~ #4 | reg[103CD8]#6 ~ #4 | reg[103CD8]#1 ~ #0 | reg[103CD8]#1 ~ #0 | reg[103CDD]#2 ~ #0 | reg[103CDD]#2 ~ #0 | reg[103CDD]#2 ~ #0 | reg[103CDD]#2 ~ #0 | reg[103CDD]#6 ~ #4 | reg[103CDD]#6 ~ #4 | reg[103CDD]#6 ~ #4 | reg[103CDD]#6 ~ #4 | reg[103CDD]#6 ~ #4 | reg[103CDA]#1 ~ #0 | reg[103CDA]#1 ~ #0 | reg[103CDA]#1 ~ #0 | reg[103CDA]#5 ~ #4 | reg[103CDA]#5 ~ #4 | reg[103CDA]#5 ~ #4 | reg[103CF4]#0 | reg[103CC3]#4 | reg[103CC3]#3 ~ #2 | reg[103CC3]#3 ~ #2 | reg[103CC3]#1 ~ #0 | reg[103CC3]#1 ~ #0 | reg[103CC2]#1 ~ #0 | reg[103CC2]#1 ~ #0 | reg[103CC2]#5 ~ #4 | reg[103CC2]#5 ~ #4 | reg[103CCF]#4 ~ #3 | reg[103CCF]#4 ~ #3 | reg[103CDC]#1 ~ #0 | reg[103CDC]#1 ~ #0 | reg[103CDF]#1 ~ #0 | reg[103CDF]#1 ~ #0 | reg[103CC4]#1 ~ #0 | reg[103CC4]#1 ~ #0 | reg[103CC4]#1 ~ #0 | reg[103C8C]#1 ~ #0 | reg[103C8C]#1 ~ #0 | reg[103C8C]#1 ~ #0 | reg[103C8C]#5 ~ #4
PAD_Name | PDU | reg_i2c2_mode | reg_ej_mode | reg_ej_mode | reg_ej_mode | reg_i2c0_mode | reg_i2c0_mode | reg_i2c0_mode | reg_i2c0_mode | reg_i2c1_mode | reg_i2c1_mode | reg_i2c1_1to2_mode | reg_mspi0_mode | reg_mspi0_mode | reg_mspi0_mode | reg_mspi0_mode | reg_mspi0_cz1_mode | reg_mspi0_cz1_mode | reg_fuart_mode | reg_fuart_mode | reg_fuart_mode | reg_fuart_mode | reg_fuart_2w_mode | reg_fuart_2w_mode | reg_fuart_2w_mode | reg_fuart_2w_mode | reg_fuart_2w_mode | reg_uart0_mode | reg_uart0_mode | reg_uart0_mode | reg_uart1_mode | reg_uart1_mode | reg_uart1_mode | reg_sd0_boot_mode | reg_emmc4b_boot_mode | reg_emmc4b_mode | reg_emmc4b_mode | reg_emmc_rst_mode | reg_emmc_rst_mode | reg_sd0_mode | reg_sd0_mode | reg_sd0_cdz_mode | reg_sd0_cdz_mode | reg_sd0_rstn_mode | reg_sd0_rstn_mode | reg_eth_mode | reg_eth_mode | reg_eth_led_mode | reg_eth_led_mode | reg_i2s_mck_mode | reg_i2s_mck_mode | reg_i2s_mck_mode | reg_i2s_rx_mode | reg_i2s_rx_mode | reg_i2s_rx_mode | reg_i2s_tx_mode
 |  | 1 | 1 | 2 | 3 | 1 | 2 | 3 | 4 | 1 | 2 | 1 | 1 | 2 | 3 | 4 | 1 | 2 | 1 | 2 | 3 | 4 | 1 | 2 | 3 | 4 | 5 | 1 | 2 | 3 | 1 | 2 | 3 | 1 | 1 | 1 | 2 | 1 | 2 | 1 | 2 | 1 | 2 | 1 | 2 | 1 | 2 | 1 | 2 | 1 | 2 | 3 | 1 | 2 | 3 | 1
 |  | 2pin | 4pin | 4pin | 4pin | 2pin | 2pin | 2pin | 2pin | 2pin | 2pin | 4pin | 4pin | 4pin | 4pin | 4pin | 1pin | 1pin | 4pin | 4pin | 4pin | 4pin | 2pin | 2pin | 2pin | 2pin | 2pin | 2pin | 2pin | 2pin | 2pin | 2pin | 2pin | 8pin | 7pin | 6pin | 6pin | 1pin | 1pin | 6pin | 6pin | 1pin | 1pin | 1pin | 1pin | 9pin | 9pin | 2pin | 2pin | 1pin | 1pin | 1pin | 3pin | 3pin | 3pin | 3pin
PAD_SR_RST0 | PU
PAD_SR_MCLK0 | PD
PAD_I2C1_SCL | PU |  |  |  |  |  |  |  |  | I2C1_SCL0 |  | I2C1_SCL0
PAD_I2C1_SDA | PU |  |  |  |  |  |  |  |  | I2C1_SDA0 |  | I2C1_SDA0
PAD_SR_RST1 | PU
PAD_SR_MCLK1 | PD
PAD_I2C2_SCL | PU | I2C2_SCL |  |  |  |  |  |  |  |  |  | I2C1_SCL1
PAD_I2C2_SDA | PU | I2C2_SDA |  |  |  |  |  |  |  |  |  | I2C1_SDA1
PAD_GPIO0 | PU |  |  |  |  |  | I2C0_SCL |  |  |  |  |  |  |  |  |  |  |  |  |  |  |  |  |  | FUART0_TX |  |  |  | UART0_RX |  |  |  |  |  |  |  |  |  |  |  |  |  | SD_CDZ | SD_RSTN |  | ETH_COL
PAD_GPIO1 | PU |  |  |  |  |  | I2C0_SDA |  |  |  |  |  |  |  |  |  |  |  |  |  |  |  |  |  | FUART0_RX |  |  |  | UART0_TX |  |  |  |  |  | SD_D[1] | SD_D[1] |  |  |  |  | SD_D[1] |  |  |  |  | ETH_RXD0
PAD_GPIO2 | PU |  |  |  |  |  |  |  |  |  |  |  |  |  | MSPI0_DO |  |  |  |  |  |  |  |  |  |  |  |  |  |  |  |  |  |  |  | SD_D[0] | SD_D[0] |  |  |  |  | SD_D[0] |  |  |  |  | ETH_RXD1
PAD_GPIO3 | PD |  |  |  |  |  |  |  |  |  |  |  |  |  | MSPI0_CK |  |  |  |  |  |  |  |  |  |  |  |  |  |  |  |  |  |  |  | SD_CLK | SD_CLK |  |  |  |  | SD_CLK |  |  |  |  | ETH_TX_CLK
PAD_GPIO4 | PU |  |  |  |  |  |  |  |  |  |  |  |  |  | MSPI0_DI |  |  |  |  |  |  |  |  |  |  |  |  |  |  |  |  |  |  |  | SD_CMD | SD_CMD |  |  |  |  | SD_CMD |  |  |  |  | ETH_TXD0
PAD_GPIO5 | PU |  |  |  |  |  |  |  |  |  |  |  |  |  | MSPI0_CZ0 |  |  |  |  |  |  |  |  |  |  |  |  |  |  |  |  |  |  |  | SD_D[3] | SD_D[3] |  |  |  |  | SD_D[3] |  |  |  |  | ETH_TXD1
PAD_GPIO6 | PU |  |  |  |  |  |  |  |  |  |  |  |  |  |  |  |  | MSPI0_CZ1 |  |  |  |  |  |  |  |  |  |  |  |  |  |  |  |  | SD_D[2] | SD_D[2] |  |  |  |  | SD_D[2] |  |  |  |  | ETH_TX_EN
PAD_GPIO7 | PU |  |  |  |  |  |  |  |  |  |  |  |  |  |  |  |  |  |  |  |  |  |  |  |  |  |  |  |  |  |  |  |  |  | SD_RSTN |  |  | SD_RSTN |  |  |  |  |  |  |  |  |  |  |  | I2S0_MCLK
PAD_GPIO8 | PU |  |  |  |  |  |  |  |  |  | I2C1_SDA0 |  |  |  |  |  |  |  |  |  |  |  |  |  |  |  |  |  |  |  |  |  |  |  |  |  |  |  |  |  |  |  |  |  |  | ETH_MDIO |  | ETH_LED[0]
PAD_GPIO9 | PU |  |  |  |  |  |  |  |  |  | I2C1_SCL0 |  |  |  |  |  |  |  |  |  |  |  |  |  |  |  |  |  |  |  |  |  |  |  |  |  |  |  |  |  |  |  |  |  |  | ETH_MDC |  | ETH_LED[1]
PAD_GPIO10 | PU
PAD_GPIO11 | PU
PAD_SD0_CDZ | PU |  |  |  |  |  |  |  |  |  |  |  |  |  |  |  |  |  |  |  |  |  |  |  |  |  |  |  |  |  |  |  |  | SD_CDZ |  |  |  |  |  |  |  | SD_CDZ |  |  | SD_RSTN
PAD_SD0_D1 | PU |  |  |  |  |  |  |  |  |  |  |  |  |  |  |  |  |  |  | FUART0_TX |  |  |  | FUART0_TX |  |  |  |  |  |  |  |  |  | SD_D[1] |  |  |  |  |  | SD_D[1]
PAD_SD0_D0 | PU |  |  |  |  |  |  |  |  |  |  |  |  | MSPI0_DO |  |  |  |  |  | FUART0_RX |  |  |  | FUART0_RX |  |  |  |  |  |  |  |  |  | SD_D[0] |  |  |  |  |  | SD_D[0]
PAD_SD0_CLK | PD |  |  |  |  |  |  |  |  |  |  |  |  | MSPI0_CK |  |  |  |  |  |  |  |  |  |  |  |  |  |  |  |  |  |  |  | SD_CLK |  |  |  |  |  | SD_CLK
PAD_SD0_CMD | PU |  |  |  |  |  |  |  |  |  |  |  |  | MSPI0_DI |  |  |  |  |  |  |  |  |  |  |  |  |  |  |  |  |  |  |  | SD_CMD |  |  |  |  |  | SD_CMD
PAD_SD0_D3 | PU |  |  |  |  |  |  |  |  |  |  |  |  | MSPI0_CZ0 |  |  |  |  |  | FUART0_CTS |  |  |  |  |  |  |  |  |  |  |  |  |  | SD_D[3] |  |  |  |  |  | SD_D[3]
PAD_SD0_D2 | PU |  |  |  |  |  |  |  |  |  |  |  |  |  |  |  |  |  |  | FUART0_RTS |  |  |  |  |  |  |  |  |  |  |  |  |  | SD_D[2] |  |  |  |  |  | SD_D[2]
PAD_FUART_RTS | PU |  | EJ_TDI |  |  |  |  |  |  |  |  |  |  |  |  |  |  |  | FUART0_RTS |  |  |  |  |  |  |  |  |  |  |  | UART1_RX
PAD_FUART_CTS | PU |  | EJ_TDO |  |  |  |  |  |  |  |  |  |  |  |  |  |  |  | FUART0_CTS |  |  |  |  |  |  |  |  |  |  |  | UART1_TX |  |  |  |  |  |  |  |  |  |  |  |  |  |  |  | ETH_COL
PAD_FUART_RX | PU |  | EJ_TMS |  |  |  |  |  |  |  |  |  |  |  |  |  |  |  | FUART0_RX |  |  |  | FUART0_RX |  |  |  |  |  |  |  |  |  |  |  |  |  |  |  |  |  |  |  |  |  |  |  | ETH_RXD0
PAD_FUART_TX | PU |  | EJ_TCK |  |  |  |  |  |  |  |  |  |  |  |  |  |  |  | FUART0_TX |  |  |  | FUART0_TX |  |  |  |  |  |  |  |  |  |  |  |  |  |  |  |  |  |  |  |  |  |  |  | ETH_RXD1
PAD_MSPI_CZ | PU |  |  |  |  |  |  |  |  |  |  |  | MSPI0_CZ0 |  |  |  |  |  |  |  |  |  |  |  |  |  |  |  |  |  |  |  |  |  |  |  |  |  |  |  |  |  |  |  |  |  | ETH_TX_EN
PAD_MSPI_DO | PU |  |  |  |  |  |  |  |  |  |  |  | MSPI0_DO |  |  |  |  |  |  |  |  |  |  |  |  |  |  |  |  |  |  |  |  |  |  |  |  |  |  |  |  |  |  |  |  |  | ETH_TXD0
PAD_MSPI_DI | PU |  |  |  |  |  |  |  |  |  |  |  | MSPI0_DI |  |  |  |  |  |  |  |  |  |  |  |  |  |  |  |  |  |  |  |  |  |  |  |  |  |  |  |  |  |  |  |  |  | ETH_TXD1
PAD_MSPI_CK | PD |  |  |  |  |  |  |  |  |  |  |  | MSPI0_CK |  |  |  |  |  |  |  |  |  |  |  |  |  |  |  |  |  |  |  |  |  |  |  |  |  |  |  |  |  |  |  |  |  | ETH_TX_CLK
PAD_SPI0_DO | PU
PAD_SPI0_DI | PU
PAD_SPI0_HLD | PU
PAD_SPI0_WPZ | PU
PAD_SPI0_CZ | PU
PAD_SPI0_CK | PD
PAD_I2C0_SDA | PU |  |  |  |  | I2C0_SDA |  |  |  |  |  |  |  |  |  |  |  |  |  |  |  |  |  |  |  |  |  |  |  |  |  |  |  |  |  |  |  |  |  |  |  |  |  |  |  |  | ETH_MDIO
PAD_I2C0_SCL | PU |  |  |  |  | I2C0_SCL |  |  |  |  |  |  |  |  |  |  |  |  |  |  |  |  |  |  |  |  |  |  |  |  |  |  |  |  |  |  |  |  |  |  |  |  |  |  |  |  | ETH_MDC
PAD_PM_GPIO12 | PU |  |  |  |  |  |  |  |  |  |  |  |  |  |  |  |  |  |  |  |  |  |  |  |  |  |  |  |  |  |  |  |  |  |  |  |  |  |  |  |  |  |  |  |  |  |  |  |  |  |  |  |  |  |  | I2S0_TX_BCK
PAD_PM_GPIO11 | PU |  |  |  |  |  |  |  |  |  |  |  |  |  |  |  |  |  |  |  |  |  |  |  |  |  |  |  |  |  |  |  |  | SD_PWR |  |  |  |  |  |  |  |  |  |  |  |  |  |  |  |  |  |  |  |  |  | I2S0_TX_WCK
PAD_PM_UART_TX | PU |  |  |  |  |  |  |  |  |  |  |  |  |  |  |  |  |  |  |  |  |  |  |  |  |  |  | UART0_TX
PAD_PM_UART_RX | PU |  |  |  |  |  |  |  |  |  |  |  |  |  |  |  |  |  |  |  |  |  |  |  |  |  |  | UART0_RX
PAD_PM_PSPI0_INT | PU |  |  |  |  |  |  |  |  |  |  |  |  |  |  |  |  |  |  |  |  |  |  |  |  |  |  |  |  |  |  |  |  |  |  |  |  |  |  |  |  |  |  |  |  |  |  |  |  |  |  | I2S0_MCLK
PAD_PM_PSPI0_DI | PU |  |  | EJ_TDO |  |  |  |  | I2C0_SDA |  |  |  |  |  |  |  |  |  |  |  |  |  |  |  |  |  |  |  |  |  |  |  |  |  |  |  |  |  |  |  |  |  |  |  |  |  |  |  |  |  |  |  | I2S0_RX_SDI
PAD_PM_PSPI0_DO | PU |  |  | EJ_TDI |  |  |  |  | I2C0_SCL |  |  |  |  |  |  |  |  |  |  |  |  |  |  |  |  |  |  |  |  |  |  |  |  |  |  |  |  |  |  |  |  |  |  |  |  |  |  |  |  |  |  |  |  |  |  | I2S0_TX_SDO
PAD_PM_PSPI0_CK | PD |  |  | EJ_TCK |  |  |  |  |  |  |  |  |  |  |  |  |  |  |  |  |  |  |  |  |  |  |  |  |  |  |  |  |  |  |  |  |  |  |  |  |  |  |  |  |  |  |  |  |  |  |  |  | I2S0_RX_BCK
PAD_PM_PSPI0_CZ | PU |  |  | EJ_TMS |  |  |  |  |  |  |  |  |  |  |  |  |  |  |  |  |  |  |  |  |  |  |  |  |  |  |  |  |  |  |  |  |  |  |  |  |  |  |  |  |  |  |  |  |  |  |  |  | I2S0_RX_WCK
PAD_PM_GPIO10 | PU |  |  |  | EJ_TDO
PAD_PM_GPIO9 | PU |  |  |  | EJ_TDI
PAD_PM_GPIO8 | PD |  |  |  | EJ_TCK
PAD_PM_GPIO7 | PD |  |  |  | EJ_TMS
PAD_PM_PWM3 | PD
PAD_PM_PWM2 | PD
PAD_PM_PWM1 | PD |  |  |  |  |  |  |  |  |  |  |  |  |  |  |  |  |  |  |  |  |  |  |  |  |  | FUART0_TX |  |  |  |  |  |  |  |  |  |  |  |  |  |  |  |  |  |  |  |  |  | ETH_LED[1]
PAD_PM_PWM0 | PD |  |  |  |  |  |  |  |  |  |  |  |  |  |  |  |  |  |  |  |  |  |  |  |  |  | FUART0_RX |  |  |  |  |  |  |  |  |  |  |  |  |  |  |  |  |  |  |  |  |  | ETH_LED[0]
PAD_PM_GPIO6 | PU
PAD_PM_GPIO5 | Hi-Z
PAD_PM_GPIO4 | Hi-Z
PAD_PM_UART2_TX | PU |  |  |  |  |  |  |  |  |  |  |  |  |  |  |  |  |  |  |  |  |  |  |  |  |  |  |  |  | UART0_TX |  |  | UART1_TX
PAD_PM_UART2_RX | PU |  |  |  |  |  |  |  |  |  |  |  |  |  |  |  |  |  |  |  |  |  |  |  |  |  |  |  |  | UART0_RX |  |  | UART1_RX
PAD_PM_I2C_CLK | PU
PAD_PM_I2C_SDA | PU
PAD_PM_SDIO_INT | PU
PAD_PM_GPIO3 | PU
PAD_PM_GPIO2 | PU |  |  |  |  |  |  |  |  |  |  |  |  |  |  |  |  |  |  |  |  |  |  |  |  |  |  |  |  |  |  |  |  |  |  |  |  |  |  |  |  |  |  |  |  |  |  |  |  |  |  |  |  | I2S0_RX_SDI
PAD_PM_GPIO1 | PU |  |  |  |  |  |  | I2C0_SDA |  |  |  |  |  |  |  |  |  |  |  |  |  |  |  |  |  |  |  |  |  |  |  |  |  |  |  |  |  |  |  |  |  |  |  |  |  |  |  |  |  |  |  |  |  | I2S0_RX_BCK
PAD_PM_GPIO0 | PU |  |  |  |  |  |  | I2C0_SCL |  |  |  |  |  |  |  |  |  |  |  |  |  |  |  |  |  |  |  |  |  |  |  |  |  |  |  |  |  |  | SD_RSTN |  |  |  |  |  |  |  |  |  |  |  |  |  |  | I2S0_RX_WCK
PAD_PM_SDIO_D1 | PU |  |  |  |  |  |  |  |  |  |  |  |  |  |  |  |  |  |  |  |  |  |  |  |  |  |  |  |  |  |  |  |  |  |  |  | SD_D[1]
PAD_PM_SDIO_D0 | PU |  |  |  |  |  |  |  |  |  |  |  |  |  |  |  |  |  |  |  |  |  |  |  |  |  |  |  |  |  |  |  |  |  |  |  | SD_D[0]
PAD_PM_SDIO_CLK | PD |  |  |  |  |  |  |  |  |  |  |  |  |  |  |  |  |  |  |  |  |  |  |  |  |  |  |  |  |  |  |  |  |  |  |  | SD_CLK
PAD_PM_SDIO_CMD | PU |  |  |  |  |  |  |  |  |  |  |  |  |  |  |  |  |  |  |  |  |  |  |  |  |  |  |  |  |  |  |  |  |  |  |  | SD_CMD
PAD_PM_SDIO_D3 | PU |  |  |  |  |  |  |  |  |  |  |  |  |  |  |  |  |  |  |  |  |  |  |  |  |  |  |  |  |  |  |  |  |  |  |  | SD_D[3]
PAD_PM_SDIO_D2 | PU |  |  |  |  |  |  |  |  |  |  |  |  |  |  |  | MSPI0_CZ1 |  |  |  |  |  |  |  |  |  |  |  |  |  |  |  |  |  |  |  | SD_D[2]
PAD_PM_FUART_RTS | PU |  |  |  |  |  |  |  |  |  |  |  |  |  |  | MSPI0_DO |  |  |  |  | FUART0_RTS |  |  |  |  |  |  |  |  |  |  |  |  |  |  |  |  |  |  |  |  |  |  |  |  |  |  |  |  |  | I2S0_MCLK
PAD_PM_FUART_CTS | PU |  |  |  |  |  |  |  |  |  |  |  |  |  |  | MSPI0_DI |  |  |  |  | FUART0_CTS |  |  |  |  |  |  |  |  |  |  |  |  |  |  |  |  |  |  |  |  |  |  |  |  |  |  |  |  |  |  |  |  |  | I2S0_RX_SDI
PAD_PM_FUART_RX | PU |  |  |  |  |  |  |  |  |  |  |  |  |  |  | MSPI0_CZ0 |  |  |  |  | FUART0_RX |  |  |  |  | FUART0_RX |  |  |  |  |  |  |  |  |  |  |  |  |  |  |  |  |  |  |  |  |  |  |  |  |  |  |  |  | I2S0_RX_WCK
PAD_PM_FUART_TX | PU |  |  |  |  |  |  |  |  |  |  |  |  |  |  | MSPI0_CK |  |  |  |  | FUART0_TX |  |  |  |  | FUART0_TX |  |  |  |  |  |  |  |  |  |  |  |  |  |  |  |  |  |  |  |  |  |  |  |  |  |  |  |  | I2S0_RX_BCK
PAD_OUTP_RX0_CH[0] | PD
PAD_OUTN_RX0_CH[0] | PD
PAD_OUTP_RX0_CH[1] | PD
PAD_OUTN_RX0_CH[1] | PD
PAD_OUTP_RX0_CH[2] | PD
PAD_OUTN_RX0_CH[2] | PD
PAD_OUTP_RX0_CH[3] | PD |  |  |  |  |  |  |  |  |  |  |  |  |  |  |  |  |  |  |  |  | FUART0_RX
PAD_OUTN_RX0_CH[3] | PD |  |  |  |  |  |  |  |  |  |  |  |  |  |  |  |  |  |  |  |  | FUART0_TX
PAD_OUTP_RX0_CH[4] | PD |  |  |  |  |  |  |  |  |  |  |  |  |  |  |  |  |  |  |  |  | FUART0_CTS |  |  |  |  |  |  |  |  |  | UART1_TX
PAD_OUTN_RX0_CH[4] | PD |  |  |  |  |  |  |  |  |  |  |  |  |  |  |  |  |  |  |  |  | FUART0_RTS |  |  |  |  |  |  |  |  |  | UART1_RX
PAD_OUTP_RX0_CH[5] | PD
PAD_OUTN_RX0_CH[5] | PD

Sheet: MISC_Table_PM_List
 |  | reg[003FB0]#1 ~ #0 | reg[003FB0]#1 ~ #0 | reg[003FB4]#1 ~ #0 | reg[003FB4]#1 ~ #0 | reg[003FB6]#1 ~ #0 | reg[003FB6]#1 ~ #0 | reg[003FB4]#5 ~ #4 | reg[003FB4]#5 ~ #4 | reg[003FB4]#5 ~ #4 | reg[003FB2]#1 ~ #0 | reg[003FB2]#1 ~ #0 | reg[003FB2]#6 ~ #4 | reg[003FB2]#6 ~ #4 | reg[003FB2]#6 ~ #4 | reg[003FB2]#6 ~ #4 | reg[003FB3]#5 ~ #4 | reg[003FB3]#5 ~ #4 | reg[003FB3]#2 ~ #0 | reg[003FB3]#2 ~ #0 | reg[003FB3]#2 ~ #0 | reg[003FC4]#1 ~ #0 | reg[003FC4]#1 ~ #0 | reg[003FA1]#2 ~ #0 | reg[003FA1]#2 ~ #0 | reg[003FA1]#2 ~ #0 | reg[003FA1]#2 ~ #0 | reg[003FA5]#1 ~ #0 | reg[003FA5]#1 ~ #0 | reg[003FA5]#1 ~ #0 | reg[003FA5]#6 ~ #4 | reg[003FA5]#6 ~ #4 | reg[003FA5]#6 ~ #4 | reg[003FA5]#6 ~ #4 | reg[003FA4]#6 ~ #4 | reg[003FA4]#6 ~ #4 | reg[003FA4]#6 ~ #4 | reg[003FA4]#6 ~ #4 | reg[003FA2]#2 ~ #0 | reg[003FA2]#2 ~ #0 | reg[003FA2]#2 ~ #0 | reg[003FA2]#6 ~ #4 | reg[003FA2]#6 ~ #4 | reg[003FA2]#6 ~ #4 | reg[003FA2]#6 ~ #4 | reg[003FA3]#2 ~ #0 | reg[003FA3]#2 ~ #0 | reg[003FA3]#2 ~ #0 | reg[003FA3]#6 ~ #4 | reg[003FA3]#6 ~ #4 | reg[003FA3]#6 ~ #4 | reg[003FB8]#1 ~ #0 | reg[003FB8]#1 ~ #0 | reg[003FB8]#5 ~ #4 | reg[003FB8]#5 ~ #4 | reg[003FB9]#1 ~ #0 | reg[003FB9]#1 ~ #0 | reg[003FB9]#1 ~ #0 | reg[003FB9]#7 ~ #4
PAD_Name | PDU | reg_cm4_ej_mode | reg_cm4_ej_mode | reg_pspi0_mode | reg_pspi0_mode | reg_pspi0_slave_mode | reg_pspi0_slave_mode | reg_pspi0_cs_mode | reg_pspi0_cs_mode | reg_pspi0_cs_mode | reg_pm_fuart_mode | reg_pm_fuart_mode | reg_pm_fuart_2w_mode | reg_pm_fuart_2w_mode | reg_pm_fuart_2w_mode | reg_pm_fuart_2w_mode | reg_pm_fuart1_2w_mode | reg_pm_fuart1_2w_mode | reg_pm_uart0_mode | reg_pm_uart0_mode | reg_pm_uart0_mode | reg_ir_in_mode | reg_ir_in_mode | reg_int_o_mode | reg_int_o_mode | reg_int_o_mode | reg_int_o_mode | reg_pm_sdio_mode | reg_pm_sdio_mode | reg_pm_sdio_mode | reg_pm_sdio_cdz_mode | reg_pm_sdio_cdz_mode | reg_pm_sdio_cdz_mode | reg_pm_sdio_cdz_mode | reg_pm_sdio_rstn_mode | reg_pm_sdio_rstn_mode | reg_pm_sdio_rstn_mode | reg_pm_sdio_rstn_mode | reg_pm_pwm0_mode | reg_pm_pwm0_mode | reg_pm_pwm0_mode | reg_pm_pwm1_mode | reg_pm_pwm1_mode | reg_pm_pwm1_mode | reg_pm_pwm1_mode | reg_pm_pwm2_mode | reg_pm_pwm2_mode | reg_pm_pwm2_mode | reg_pm_pwm3_mode | reg_pm_pwm3_mode | reg_pm_pwm3_mode | reg_pir_dirlk0_mode | reg_pir_dirlk0_mode | reg_pir_dirlk1_mode | reg_pir_dirlk1_mode | reg_pir_dirlk2_mode | reg_pir_dirlk2_mode | reg_pir_dirlk2_mode | reg_pir_dirlk3_mode
 |  | 1 | 2 | 1 | 2 | 1 | 2 | 1 | 2 | 3 | 2 | 3 | 1 | 2 | 3 | 4 | 2 | 3 | 1 | 2 | 3 | 1 | 2 | 1 | 2 | 3 | 4 | 1 | 2 | 3 | 1 | 2 | 3 | 4 | 1 | 2 | 3 | 4 | 1 | 2 | 4 | 1 | 2 | 3 | 4 | 2 | 3 | 4 | 2 | 3 | 4 | 1 | 2 | 1 | 3 | 1 | 2 | 3 | 1
 |  | 4pin | 4pin | 4pin | 4pin | 4pin | 4pin | 1pin | 1pin | 1pin | 4pin | 4pin | 2pin | 2pin | 2pin | 2pin | 2pin | 2pin | 2pin | 2pin | 2pin | 1pin | 1pin | 1pin | 1pin | 1pin | 1pin | 6pin | 6pin | 6pin | 1pin | 1pin | 1pin | 1pin | 1pin | 1pin | 1pin | 1pin | 1pin | 1pin | 1pin | 1pin | 1pin | 1pin | 1pin | 1pin | 1pin | 1pin | 1pin | 1pin | 1pin | 1pin | 1pin | 1pin | 1pin | 1pin | 1pin | 1pin | 3pin
PAD_PM_GPIO11 | PU |  |  |  |  |  |  | PSPI0_CZ1 |  |  |  |  |  |  |  |  |  |  |  |  |  |  |  |  |  |  |  |  |  |  |  |  |  |  |  |  |  |  |  |  |  |  |  |  | PWM[1] |  |  |  |  |  |  | PM_DIRECT_LINK |  |  |  |  |  |  | PM_DIRECT_LINK0
PAD_PM_UART_TX | PU |  |  |  |  |  |  |  |  |  |  |  |  |  |  |  |  |  | UART0_TX
PAD_PM_UART_RX | PU |  |  |  |  |  |  |  |  |  |  |  |  |  |  |  |  |  | UART0_RX
PAD_PM_PSPI0_INT | PU |  |  |  |  |  |  |  |  |  |  |  |  |  |  |  |  |  |  |  |  |  |  | INT_OUT |  |  |  |  |  |  |  | SDIO_CDZ |  |  |  | SDIO_RSTN
PAD_PM_PSPI0_DI | PU | CM4_EJ_TDO |  | PSPI0_DI |  |  |  |  |  |  |  |  |  |  |  |  |  |  |  |  |  |  |  |  |  |  |  |  |  | SDIO_D[1] |  |  |  |  |  |  |  |  |  |  | PWM[0]
PAD_PM_PSPI0_DO | PU | CM4_EJ_TDI |  | PSPI0_DO |  |  |  |  |  |  |  |  |  |  |  |  |  |  |  |  |  |  |  |  |  |  |  |  |  | SDIO_D[0] |  |  |  |  |  |  |  |  |  |  |  |  |  | PWM[1]
PAD_PM_PSPI0_CK | PD | CM4_EJ_TCK |  | PSPI0_CK |  |  |  |  |  |  |  |  |  |  |  |  |  |  |  |  |  |  |  |  |  |  |  |  |  | SDIO_CLK |  |  |  |  |  |  |  |  |  |  |  |  |  |  |  |  |  |  |  |  | PWM[3]
PAD_PM_PSPI0_CZ | PU | CM4_EJ_TMS |  | PSPI0_CZ0 |  |  |  |  |  |  |  |  |  |  |  |  |  |  |  |  |  |  |  |  |  |  |  |  |  | SDIO_CMD |  |  |  |  |  |  |  |  |  |  |  |  |  |  |  | PWM[2]
PAD_PM_GPIO10 | PU |  | CM4_EJ_TDO |  |  | PSPI0_DI |  |  |  |  |  |  |  |  |  |  |  |  |  |  |  |  |  |  |  |  |  |  |  | SDIO_D[3] |  |  |  |  |  |  |  |  |  |  |  |  |  |  |  |  |  |  |  | PWM[3]
PAD_PM_GPIO9 | PU |  | CM4_EJ_TDI |  |  | PSPI0_CZ0 |  |  |  |  |  |  |  |  |  |  |  |  |  |  |  |  |  |  |  |  |  |  |  | SDIO_D[2] |  |  |  |  |  |  |  |  |  |  |  |  |  |  |  |  | PWM[2] |  |  |  |  |  |  | PM_DIRECT_LINK |  |  |  |  | PM_DIRECT_LINK1
PAD_PM_GPIO8 | PD |  | CM4_EJ_TMS |  |  | PSPI0_DO |  |  |  |  |  | FUART_CTS |  |  |  |  |  |  |  |  |  | PM_IRIN |  |  |  |  |  |  |  |  |  |  | SDIO_CDZ |  |  |  | SDIO_RSTN
PAD_PM_GPIO7 | PD |  | CM4_EJ_TCK |  |  | PSPI0_CK |  |  |  |  |  | FUART_RTS |  |  |  |  |  |  |  |  |  |  |  |  |  |  |  |  |  |  |  |  |  |  |  |  |  |  |  |  |  |  |  |  |  |  |  |  |  |  |  |  |  |  |  | PM_DIRECT_LINK |  |  | PM_DIRECT_LINK2
PAD_PM_PWM1 | PD |  |  |  |  |  |  |  | PSPI0_CZ1 |  |  | FUART_TX |  | FUART_TX |  |  |  |  |  | UART0_TX |  |  |  |  |  |  |  |  |  |  |  |  |  |  |  |  |  |  |  |  |  | PWM[1]
PAD_PM_PWM0 | PD |  |  |  |  |  |  |  |  |  |  | FUART_RX |  | FUART_RX |  |  |  |  |  | UART0_RX |  |  |  |  |  |  |  |  |  |  |  |  |  |  |  |  |  |  | PWM[0] |  |  |  |  |  |  |  |  |  |  |  |  |  |  |  |  |  |  | PM_DIRECT_LINK
PAD_PM_GPIO6 | PU |  |  |  |  |  |  |  |  | PSPI0_CZ1 |  |  |  |  |  |  |  |  |  |  |  |  |  |  | INT_OUT |  |  |  |  |  | SDIO_CDZ |  |  |  | SDIO_RSTN
PAD_PM_GPIO5 | Hi-Z
PAD_PM_GPIO4 | Hi-Z
PAD_PM_UART2_TX | PU |  |  |  |  |  |  |  |  |  |  |  | FUART_TX |  |  |  | FUART1_TX |  |  |  | UART0_TX
PAD_PM_UART2_RX | PU |  |  |  |  |  |  |  |  |  |  |  | FUART_RX |  |  |  | FUART1_RX |  |  |  | UART0_RX
PAD_PM_I2C_CLK | PU |  |  |  |  |  |  |  |  |  |  |  |  |  |  |  |  |  |  |  |  |  |  |  |  |  |  |  |  |  |  |  |  |  |  |  |  |  |  |  |  |  |  |  |  |  |  | PWM[2]
PAD_PM_I2C_SDA | PU |  |  |  |  |  |  |  |  |  |  |  |  |  |  |  |  |  |  |  |  |  |  |  |  |  |  |  |  |  |  |  |  |  |  |  |  |  |  |  |  |  |  |  |  |  |  |  | PWM[3]
PAD_PM_SDIO_INT | PU |  |  |  |  |  |  |  |  |  |  |  |  |  |  |  |  |  |  |  |  |  |  |  |  | INT_OUT |  |  |  |  |  |  |  | SDIO_CDZ |  |  |  | SDIO_RSTN
PAD_PM_GPIO3 | PU |  |  |  |  |  | PSPI0_DI |  |  |  | FUART_RTS |  |  |  |  |  |  | FUART1_TX |  |  |  |  | PM_IRIN |  |  |  | INT_OUT |  | SDIO_D[1] |  |  |  |  |  |  |  |  |  |  |  |  |  |  |  |  |  |  |  |  |  |  |  |  |  | PM_DIRECT_LINK
PAD_PM_GPIO2 | PU |  |  |  |  |  | PSPI0_CZ0 |  |  |  | FUART_CTS |  |  |  |  |  |  | FUART1_RX |  |  |  |  |  |  |  |  |  |  | SDIO_D[0] |  |  |  |  |  |  |  |  |  |  |  |  |  |  |  |  |  |  |  |  |  |  |  | PM_DIRECT_LINK
PAD_PM_GPIO1 | PU |  |  |  |  |  | PSPI0_DO |  |  |  | FUART_TX |  |  |  | FUART_TX |  |  |  |  |  |  |  |  |  |  |  |  |  | SDIO_CLK |  |  |  |  |  |  |  |  |  |  |  |  |  | PWM[1]
PAD_PM_GPIO0 | PU |  |  |  |  |  | PSPI0_CK |  |  |  | FUART_RX |  |  |  | FUART_RX |  |  |  |  |  |  |  |  |  |  |  |  |  | SDIO_CMD |  |  |  |  |  |  |  |  |  |  | PWM[0]
PAD_PM_SDIO_D1 | PU |  |  |  |  |  |  |  |  |  |  |  |  |  |  |  |  |  |  |  |  |  |  |  |  |  |  | SDIO_D[1]
PAD_PM_SDIO_D0 | PU |  |  |  | PSPI0_DO |  |  |  |  |  |  |  |  |  |  |  |  |  |  |  |  |  |  |  |  |  |  | SDIO_D[0]
PAD_PM_SDIO_CLK | PD |  |  |  | PSPI0_CK |  |  |  |  |  |  |  |  |  |  |  |  |  |  |  |  |  |  |  |  |  |  | SDIO_CLK
PAD_PM_SDIO_CMD | PU |  |  |  | PSPI0_DI |  |  |  |  |  |  |  |  |  |  |  |  |  |  |  |  |  |  |  |  |  |  | SDIO_CMD
PAD_PM_SDIO_D3 | PU |  |  |  | PSPI0_CZ0 |  |  |  |  |  |  |  |  |  |  |  |  |  |  |  |  |  |  |  |  |  |  | SDIO_D[3]
PAD_PM_SDIO_D2 | PU |  |  |  |  |  |  |  |  |  |  |  |  |  |  |  |  |  |  |  |  |  |  |  |  |  |  | SDIO_D[2]
PAD_PM_FUART_RX | PU |  |  |  |  |  |  |  |  |  |  |  |  |  |  | FUART_RX |  |  |  |  |  |  |  |  |  |  |  |  | SDIO_D[3]
PAD_PM_FUART_TX | PU |  |  |  |  |  |  |  |  |  |  |  |  |  |  | FUART_TX |  |  |  |  |  |  |  |  |  |  |  |  | SDIO_D[2] |  |  |  |  |  |  |  |  |  |  |  |  |  |  |  |  |  |  |  |  |  |  |  |  |  |  |  | PM_DIRECT_LINK

Sheet: GPIO_Ctrl_Reg_Table
GPIO index | PAD_NAME | Ball Name | Configuration (default value) | Base Addr | Offset | Configuration (register settings) |  | OEN 0: output / 1: input | IN | OUT | pad type | reset value | default value after reset (reg_allpad_in==1) reg[101EA0]#15 = 1 | default value after reg_allpad_in==0 reg[101EA0]#15 = 0 | 5V tolerance | Standby mode | Internal pull up resister | Internal pull down resister | FT SPEC for LeakLo (Current@PAD=0) | FT SPEC for LeakHi (Current@PAD=3.3V) | Interrupt Available | Driving | DRV | DRV (default value) | PS | PS (default value) | PE | IE | SPEED | INT Type
0 | PAD_I2C1_SDA | PAD_I2C1_SDA | default is GPIO | 103E | 0 | reg_gpio_en;reg[103E00]#3= 1b |  | reg[103E00]#2 | reg[103E00]#0 | reg[103E00]#1 | paddsh_pdas16p2dg_1p8 | input, pull-up | input, pull-up | input, pull-up | No | No | PE=1, PS=1 PU=97kΩ (77~117kΩ) | PE=1, PS=0 PD=96kΩ (76~116kkΩ) | PAD= 0V PE=0, PS=0 (HIZ): I < +/- 1uA PE=1, PS=1: PU=97kΩ (77~117kΩ), I= 18.56uA (15.38~23.38uA) | PAD= 1.8V PE=0, PS=0 (HIZ): I < +/- 1uA PE=1, PS=0: PD=96kΩ (76~116kkΩ), I= 18.75uA(15.52~23.68uA) | Yes | (00) = 4 mA (01) = 8 mA (10) = 12 mA (11) = 16 mA | 0:4d00103E00,bit7 1:4d00103E01,bit8 | 2'b0 | reg[103E00]#11 | 1 | reg[103E00]#6 | reg[103E00]#9 | 1. not support fail-safe (不支援防倒灌) 2. not support PAD to C control | Level/Edge
1 | PAD_SR_RST0 | PAD_SR_RST0 | default is GPIO | 103E | 1 | reg_gpio_en;reg[103E02]#3= 1b |  | reg[103E02]#2 | reg[103E02]#0 | reg[103E02]#1 | paddsh_pdas16p2dg_1p8 | input, pull-up | input, pull-up | input, pull-up | No | No | PE=1, PS=1 PU=97kΩ (77~117kΩ) | PE=1, PS=0 PD=96kΩ (76~116kkΩ) | PAD= 0V PE=0, PS=0 (HIZ): I < +/- 1uA PE=1, PS=1: PU=97kΩ (77~117kΩ), I= 18.56uA (15.38~23.38uA) | PAD= 1.8V PE=0, PS=0 (HIZ): I < +/- 1uA PE=1, PS=0: PD=96kΩ (76~116kkΩ), I= 18.75uA(15.52~23.68uA) | Yes | (00) = 4 mA (01) = 8 mA (10) = 12 mA (11) = 16 mA | 0:4d00103E02,bit7 1:4d00103E03,bit8 | 2'b0 | reg[103E02]#11 | 1 | reg[103E02]#6 | reg[103E02]#9 | 1. not support fail-safe (不支援防倒灌) 2. not support PAD to C control | Level/Edge
2 | PAD_SR_MCLK0 | PAD_SR_MCLK0 | default is GPIO | 103E | 2 | reg_gpio_en;reg[103E04]#3= 1b |  | reg[103E04]#2 | reg[103E04]#0 | reg[103E04]#1 | paddsh_pdas16p2dg_1p8 | input, pull-down | input, pull-down | input, pull-down | No | No | PE=1, PS=1 PU=97kΩ (77~117kΩ) | PE=1, PS=0 PD=96kΩ (76~116kkΩ) | PAD= 0V PE=0, PS=0 (HIZ): I < +/- 1uA PE=1, PS=1: PU=97kΩ (77~117kΩ), I= 18.56uA (15.38~23.38uA) | PAD= 1.8V PE=0, PS=0 (HIZ): I < +/- 1uA PE=1, PS=0: PD=96kΩ (76~116kkΩ), I= 18.75uA(15.52~23.68uA) | Yes | (00) = 4 mA (01) = 8 mA (10) = 12 mA (11) = 16 mA | 0:4d00103E04,bit7 1:4d00103E05,bit8 | 2'b0 | reg[103E04]#11 | 0 | reg[103E04]#6 | reg[103E04]#9 | 1. not support fail-safe (不支援防倒灌) 2. not support PAD to C control | Level/Edge
3 | PAD_I2C1_SCL | PAD_I2C1_SCL | default is GPIO | 103E | 3 | reg_gpio_en;reg[103E06]#3= 1b |  | reg[103E06]#2 | reg[103E06]#0 | reg[103E06]#1 | paddsh_pdas16p2dg_1p8 | input, pull-up | input, pull-up | input, pull-up | No | No | PE=1, PS=1 PU=97kΩ (77~117kΩ) | PE=1, PS=0 PD=96kΩ (76~116kkΩ) | PAD= 0V PE=0, PS=0 (HIZ): I < +/- 1uA PE=1, PS=1: PU=97kΩ (77~117kΩ), I= 18.56uA (15.38~23.38uA) | PAD= 1.8V PE=0, PS=0 (HIZ): I < +/- 1uA PE=1, PS=0: PD=96kΩ (76~116kkΩ), I= 18.75uA(15.52~23.68uA) | Yes | (00) = 4 mA (01) = 8 mA (10) = 12 mA (11) = 16 mA | 0:4d00103E06,bit7 1:4d00103E07,bit8 | 2'b0 | reg[103E06]#11 | 1 | reg[103E06]#6 | reg[103E06]#9 | 1. not support fail-safe (不支援防倒灌) 2. not support PAD to C control | Level/Edge
4 | PAD_SR_RST1 | PAD_SR_RST1 | default is GPIO | 103E | 4 | reg_gpio_en;reg[103E08]#3= 1b |  | reg[103E08]#2 | reg[103E08]#0 | reg[103E08]#1 | paddsh_pdas16p2dg_1p8 | input, pull-up | input, pull-up | input, pull-up | No | No | PE=1, PS=1 PU=97kΩ (77~117kΩ) | PE=1, PS=0 PD=96kΩ (76~116kkΩ) | PAD= 0V PE=0, PS=0 (HIZ): I < +/- 1uA PE=1, PS=1: PU=97kΩ (77~117kΩ), I= 18.56uA (15.38~23.38uA) | PAD= 1.8V PE=0, PS=0 (HIZ): I < +/- 1uA PE=1, PS=0: PD=96kΩ (76~116kkΩ), I= 18.75uA(15.52~23.68uA) | Yes | (00) = 4 mA (01) = 8 mA (10) = 12 mA (11) = 16 mA | 0:4d00103E08,bit7 1:4d00103E09,bit8 | 2'b0 | reg[103E08]#11 | 1 | reg[103E08]#6 | reg[103E08]#9 | 1. not support fail-safe (不支援防倒灌) 2. not support PAD to C control | Level/Edge
5 | PAD_SR_MCLK1 | PAD_SR_MCLK1 | default is GPIO | 103E | 5 | reg_gpio_en;reg[103E0A]#3= 1b |  | reg[103E0A]#2 | reg[103E0A]#0 | reg[103E0A]#1 | paddsh_pdas16p2dg_1p8 | input, pull-down | input, pull-down | input, pull-down | No | No | PE=1, PS=1 PU=97kΩ (77~117kΩ) | PE=1, PS=0 PD=96kΩ (76~116kkΩ) | PAD= 0V PE=0, PS=0 (HIZ): I < +/- 1uA PE=1, PS=1: PU=97kΩ (77~117kΩ), I= 18.56uA (15.38~23.38uA) | PAD= 1.8V PE=0, PS=0 (HIZ): I < +/- 1uA PE=1, PS=0: PD=96kΩ (76~116kkΩ), I= 18.75uA(15.52~23.68uA) | Yes | (00) = 4 mA (01) = 8 mA (10) = 12 mA (11) = 16 mA | 0:4d00103E0A,bit7 1:4d00103E0B,bit8 | 2'b0 | reg[103E0A]#11 | 0 | reg[103E0A]#6 | reg[103E0A]#9 | 1. not support fail-safe (不支援防倒灌) 2. not support PAD to C control | Level/Edge
6 | PAD_I2C2_SCL | PAD_I2C2_SCL | default is GPIO | 103E | 6 | reg_gpio_en;reg[103E0C]#3= 1b |  | reg[103E0C]#2 | reg[103E0C]#0 | reg[103E0C]#1 | paddsh_pdas16p2dg_1p8 | input, pull-up | input, pull-up | input, pull-up | No | No | PE=1, PS=1 PU=97kΩ (77~117kΩ) | PE=1, PS=0 PD=96kΩ (76~116kkΩ) | PAD= 0V PE=0, PS=0 (HIZ): I < +/- 1uA PE=1, PS=1: PU=97kΩ (77~117kΩ), I= 18.56uA (15.38~23.38uA) | PAD= 1.8V PE=0, PS=0 (HIZ): I < +/- 1uA PE=1, PS=0: PD=96kΩ (76~116kkΩ), I= 18.75uA(15.52~23.68uA) | Yes | (00) = 4 mA (01) = 8 mA (10) = 12 mA (11) = 16 mA | 0:4d00103E0C,bit7 1:4d00103E0D,bit8 | 2'b0 | reg[103E0C]#11 | 1 | reg[103E0C]#6 | reg[103E0C]#9 | 1. not support fail-safe (不支援防倒灌) 2. not support PAD to C control | Level/Edge
7 | PAD_I2C2_SDA | PAD_I2C2_SDA | default is GPIO | 103E | 7 | reg_gpio_en;reg[103E0E]#3= 1b |  | reg[103E0E]#2 | reg[103E0E]#0 | reg[103E0E]#1 | paddsh_pdas16p2dg_1p8 | input, pull-up | input, pull-up | input, pull-up | No | No | PE=1, PS=1 PU=97kΩ (77~117kΩ) | PE=1, PS=0 PD=96kΩ (76~116kkΩ) | PAD= 0V PE=0, PS=0 (HIZ): I < +/- 1uA PE=1, PS=1: PU=97kΩ (77~117kΩ), I= 18.56uA (15.38~23.38uA) | PAD= 1.8V PE=0, PS=0 (HIZ): I < +/- 1uA PE=1, PS=0: PD=96kΩ (76~116kkΩ), I= 18.75uA(15.52~23.68uA) | Yes | (00) = 4 mA (01) = 8 mA (10) = 12 mA (11) = 16 mA | 0:4d00103E0E,bit7 1:4d00103E0F,bit8 | 2'b0 | reg[103E0E]#11 | 1 | reg[103E0E]#6 | reg[103E0E]#9 | 1. not support fail-safe (不支援防倒灌) 2. not support PAD to C control | Level/Edge
8 | PAD_GPIO0 | PAD_GPIO0 | default is GPIO | 103E | 8 | reg_gpio_en;reg[103E10]#3= 1b |  | reg[103E10]#2 | reg[103E10]#0 | reg[103E10]#1 | paddsh_pdas16p2dg_ie | input, pull-up | input, pull-up | input, pull-up | No | No | 1.8V mode PE=1, PS=1: PU=42kΩ (34~50kΩ) 3.3V mode PE=1, PS=1: PU=43kΩ (35~51kΩ) | 1.8V mode PE=1, PS=0: PD=42kΩ (34~50kΩ) 3.3V mode PE=1, PS=0: PD=43kΩ (35~51kΩ) | 1.8V mode: PAD= 0V PE=0, PS=0 (HIZ): I < +/- 1uA PE=1, PS=1 (PU)=42kΩ (34~50kΩ), I= 42.85uA (36.00~52.94uA) 3.3V mode: PAD= 0V PE=0, PS=0 (HIZ): I < +/- 1uA PE=1, PS=1 (PU)=43kΩ (35~51kΩ), I= 76.74uA (64.70~94.59uA) | 1.8V mode: PAD= 1.8V PE=0, PS=0 (HIZ): I < +/- 1uA PE=1, PS=0 (PD)=42kΩ (34~50kΩ), I= 42.85A (36.00~52.94uA) 3.3V mode: PAD= 3.3V PE=0, PS=0 (HIZ): I < +/- 1uA PE=1, PS=0 (PD)=43kΩ (35~51kΩ), I= 76.70uA (64.70~94.59uA) | Yes | (00) = 4 mA (01) = 8 mA (10) = 12 mA (11) = 16 mA | 0:4d00103E10,bit7 1:4d00103E11,bit8 | 2'b0 | reg[103E10]#11 | 1 | reg[103E10]#6 | reg[103E10]#9 | 1. not support fail-safe (不支援防倒灌) 2. support PAD to C control | Level/Edge
9 | PAD_GPIO1 | PAD_GPIO1 | default is GPIO | 103E | 9 | reg_gpio_en;reg[103E12]#3= 1b |  | reg[103E12]#2 | reg[103E12]#0 | reg[103E12]#1 | paddsh_pdas16p2dg_ie | input, pull-up | input, pull-up | input, pull-up | No | No | 1.8V mode PE=1, PS=1: PU=42kΩ (34~50kΩ) 3.3V mode PE=1, PS=1: PU=43kΩ (35~51kΩ) | 1.8V mode PE=1, PS=0: PD=42kΩ (34~50kΩ) 3.3V mode PE=1, PS=0: PD=43kΩ (35~51kΩ) | 1.8V mode: PAD= 0V PE=0, PS=0 (HIZ): I < +/- 1uA PE=1, PS=1 (PU)=42kΩ (34~50kΩ), I= 42.85uA (36.00~52.94uA) 3.3V mode: PAD= 0V PE=0, PS=0 (HIZ): I < +/- 1uA PE=1, PS=1 (PU)=43kΩ (35~51kΩ), I= 76.74uA (64.70~94.59uA) | 1.8V mode: PAD= 1.8V PE=0, PS=0 (HIZ): I < +/- 1uA PE=1, PS=0 (PD)=42kΩ (34~50kΩ), I= 42.85A (36.00~52.94uA) 3.3V mode: PAD= 3.3V PE=0, PS=0 (HIZ): I < +/- 1uA PE=1, PS=0 (PD)=43kΩ (35~51kΩ), I= 76.70uA (64.70~94.59uA) | Yes | (00) = 4 mA (01) = 8 mA (10) = 12 mA (11) = 16 mA | 0:4d00103E12,bit7 1:4d00103E13,bit8 | 2'b0 | reg[103E12]#11 | 1 | reg[103E12]#6 | reg[103E12]#9 | 1. not support fail-safe (不支援防倒灌) 2. support PAD to C control | Level/Edge
10 | PAD_GPIO2 | PAD_GPIO2 | default is GPIO | 103E | 10 | reg_gpio_en;reg[103E14]#3= 1b |  | reg[103E14]#2 | reg[103E14]#0 | reg[103E14]#1 | paddsh_pdas16p2dg_ie | input, pull-up | input, pull-up | input, pull-up | No | No | 1.8V mode PE=1, PS=1: PU=42kΩ (34~50kΩ) 3.3V mode PE=1, PS=1: PU=43kΩ (35~51kΩ) | 1.8V mode PE=1, PS=0: PD=42kΩ (34~50kΩ) 3.3V mode PE=1, PS=0: PD=43kΩ (35~51kΩ) | 1.8V mode: PAD= 0V PE=0, PS=0 (HIZ): I < +/- 1uA PE=1, PS=1 (PU)=42kΩ (34~50kΩ), I= 42.85uA (36.00~52.94uA) 3.3V mode: PAD= 0V PE=0, PS=0 (HIZ): I < +/- 1uA PE=1, PS=1 (PU)=43kΩ (35~51kΩ), I= 76.74uA (64.70~94.59uA) | 1.8V mode: PAD= 1.8V PE=0, PS=0 (HIZ): I < +/- 1uA PE=1, PS=0 (PD)=42kΩ (34~50kΩ), I= 42.85A (36.00~52.94uA) 3.3V mode: PAD= 3.3V PE=0, PS=0 (HIZ): I < +/- 1uA PE=1, PS=0 (PD)=43kΩ (35~51kΩ), I= 76.70uA (64.70~94.59uA) | Yes | (00) = 4 mA (01) = 8 mA (10) = 12 mA (11) = 16 mA | 0:4d00103E14,bit7 1:4d00103E15,bit8 | 2'b0 | reg[103E14]#11 | 1 | reg[103E14]#6 | reg[103E14]#9 | 1. not support fail-safe (不支援防倒灌) 2. support PAD to C control | Level/Edge
11 | PAD_GPIO3 | PAD_GPIO3 | default is GPIO | 103E | 11 | reg_gpio_en;reg[103E16]#3= 1b |  | reg[103E16]#2 | reg[103E16]#0 | reg[103E16]#1 | paddsh_pdas16p2dg_ie | input, pull-down | input, pull-down | input, pull-down | No | No | 1.8V mode PE=1, PS=1: PU=42kΩ (34~50kΩ) 3.3V mode PE=1, PS=1: PU=43kΩ (35~51kΩ) | 1.8V mode PE=1, PS=0: PD=42kΩ (34~50kΩ) 3.3V mode PE=1, PS=0: PD=43kΩ (35~51kΩ) | 1.8V mode: PAD= 0V PE=0, PS=0 (HIZ): I < +/- 1uA PE=1, PS=1 (PU)=42kΩ (34~50kΩ), I= 42.85uA (36.00~52.94uA) 3.3V mode: PAD= 0V PE=0, PS=0 (HIZ): I < +/- 1uA PE=1, PS=1 (PU)=43kΩ (35~51kΩ), I= 76.74uA (64.70~94.59uA) | 1.8V mode: PAD= 1.8V PE=0, PS=0 (HIZ): I < +/- 1uA PE=1, PS=0 (PD)=42kΩ (34~50kΩ), I= 42.85A (36.00~52.94uA) 3.3V mode: PAD= 3.3V PE=0, PS=0 (HIZ): I < +/- 1uA PE=1, PS=0 (PD)=43kΩ (35~51kΩ), I= 76.70uA (64.70~94.59uA) | Yes | (00) = 4 mA (01) = 8 mA (10) = 12 mA (11) = 16 mA | 0:4d00103E16,bit7 1:4d00103E17,bit8 | 2'b0 | reg[103E16]#11 | 0 | reg[103E16]#6 | reg[103E16]#9 | 1. not support fail-safe (不支援防倒灌) 2. support PAD to C control | Level/Edge
12 | PAD_GPIO4 | PAD_GPIO4 | default is GPIO | 103E | 12 | reg_gpio_en;reg[103E18]#3= 1b |  | reg[103E18]#2 | reg[103E18]#0 | reg[103E18]#1 | paddsh_pdas16p2dg_ie | input, pull-up | input, pull-up | input, pull-up | No | No | 1.8V mode PE=1, PS=1: PU=42kΩ (34~50kΩ) 3.3V mode PE=1, PS=1: PU=43kΩ (35~51kΩ) | 1.8V mode PE=1, PS=0: PD=42kΩ (34~50kΩ) 3.3V mode PE=1, PS=0: PD=43kΩ (35~51kΩ) | 1.8V mode: PAD= 0V PE=0, PS=0 (HIZ): I < +/- 1uA PE=1, PS=1 (PU)=42kΩ (34~50kΩ), I= 42.85uA (36.00~52.94uA) 3.3V mode: PAD= 0V PE=0, PS=0 (HIZ): I < +/- 1uA PE=1, PS=1 (PU)=43kΩ (35~51kΩ), I= 76.74uA (64.70~94.59uA) | 1.8V mode: PAD= 1.8V PE=0, PS=0 (HIZ): I < +/- 1uA PE=1, PS=0 (PD)=42kΩ (34~50kΩ), I= 42.85A (36.00~52.94uA) 3.3V mode: PAD= 3.3V PE=0, PS=0 (HIZ): I < +/- 1uA PE=1, PS=0 (PD)=43kΩ (35~51kΩ), I= 76.70uA (64.70~94.59uA) | Yes | (00) = 4 mA (01) = 8 mA (10) = 12 mA (11) = 16 mA | 0:4d00103E18,bit7 1:4d00103E19,bit8 | 2'b0 | reg[103E18]#11 | 1 | reg[103E18]#6 | reg[103E18]#9 | 1. not support fail-safe (不支援防倒灌) 2. support PAD to C control | Level/Edge
13 | PAD_GPIO5 | PAD_GPIO5 | default is GPIO | 103E | 13 | reg_gpio_en;reg[103E1A]#3= 1b |  | reg[103E1A]#2 | reg[103E1A]#0 | reg[103E1A]#1 | paddsh_pdas16p2dg_ie | input, pull-up | input, pull-up | input, pull-up | No | No | 1.8V mode PE=1, PS=1: PU=42kΩ (34~50kΩ) 3.3V mode PE=1, PS=1: PU=43kΩ (35~51kΩ) | 1.8V mode PE=1, PS=0: PD=42kΩ (34~50kΩ) 3.3V mode PE=1, PS=0: PD=43kΩ (35~51kΩ) | 1.8V mode: PAD= 0V PE=0, PS=0 (HIZ): I < +/- 1uA PE=1, PS=1 (PU)=42kΩ (34~50kΩ), I= 42.85uA (36.00~52.94uA) 3.3V mode: PAD= 0V PE=0, PS=0 (HIZ): I < +/- 1uA PE=1, PS=1 (PU)=43kΩ (35~51kΩ), I= 76.74uA (64.70~94.59uA) | 1.8V mode: PAD= 1.8V PE=0, PS=0 (HIZ): I < +/- 1uA PE=1, PS=0 (PD)=42kΩ (34~50kΩ), I= 42.85A (36.00~52.94uA) 3.3V mode: PAD= 3.3V PE=0, PS=0 (HIZ): I < +/- 1uA PE=1, PS=0 (PD)=43kΩ (35~51kΩ), I= 76.70uA (64.70~94.59uA) | Yes | (00) = 4 mA (01) = 8 mA (10) = 12 mA (11) = 16 mA | 0:4d00103E1A,bit7 1:4d00103E1B,bit8 | 2'b0 | reg[103E1A]#11 | 1 | reg[103E1A]#6 | reg[103E1A]#9 | 1. not support fail-safe (不支援防倒灌) 2. support PAD to C control | Level/Edge
14 | PAD_GPIO6 | PAD_GPIO6 | default is GPIO | 103E | 14 | reg_gpio_en;reg[103E1C]#3= 1b |  | reg[103E1C]#2 | reg[103E1C]#0 | reg[103E1C]#1 | paddsh_pdas16p2dg_ie | input, pull-up | input, pull-up | input, pull-up | No | No | 1.8V mode PE=1, PS=1: PU=42kΩ (34~50kΩ) 3.3V mode PE=1, PS=1: PU=43kΩ (35~51kΩ) | 1.8V mode PE=1, PS=0: PD=42kΩ (34~50kΩ) 3.3V mode PE=1, PS=0: PD=43kΩ (35~51kΩ) | 1.8V mode: PAD= 0V PE=0, PS=0 (HIZ): I < +/- 1uA PE=1, PS=1 (PU)=42kΩ (34~50kΩ), I= 42.85uA (36.00~52.94uA) 3.3V mode: PAD= 0V PE=0, PS=0 (HIZ): I < +/- 1uA PE=1, PS=1 (PU)=43kΩ (35~51kΩ), I= 76.74uA (64.70~94.59uA) | 1.8V mode: PAD= 1.8V PE=0, PS=0 (HIZ): I < +/- 1uA PE=1, PS=0 (PD)=42kΩ (34~50kΩ), I= 42.85A (36.00~52.94uA) 3.3V mode: PAD= 3.3V PE=0, PS=0 (HIZ): I < +/- 1uA PE=1, PS=0 (PD)=43kΩ (35~51kΩ), I= 76.70uA (64.70~94.59uA) | Yes | (00) = 4 mA (01) = 8 mA (10) = 12 mA (11) = 16 mA | 0:4d00103E1C,bit7 1:4d00103E1D,bit8 | 2'b0 | reg[103E1C]#11 | 1 | reg[103E1C]#6 | reg[103E1C]#9 | 1. not support fail-safe (不支援防倒灌) 2. support PAD to C control | Level/Edge
15 | PAD_GPIO7 | PAD_GPIO7 | default is GPIO | 103E | 15 | reg_gpio_en;reg[103E1E]#3= 1b |  | reg[103E1E]#2 | reg[103E1E]#0 | reg[103E1E]#1 | paddsh_pdas16p2dg_ie | input, pull-up | input, pull-up | input, pull-up | No | No | 1.8V mode PE=1, PS=1: PU=42kΩ (34~50kΩ) 3.3V mode PE=1, PS=1: PU=43kΩ (35~51kΩ) | 1.8V mode PE=1, PS=0: PD=42kΩ (34~50kΩ) 3.3V mode PE=1, PS=0: PD=43kΩ (35~51kΩ) | 1.8V mode: PAD= 0V PE=0, PS=0 (HIZ): I < +/- 1uA PE=1, PS=1 (PU)=42kΩ (34~50kΩ), I= 42.85uA (36.00~52.94uA) 3.3V mode: PAD= 0V PE=0, PS=0 (HIZ): I < +/- 1uA PE=1, PS=1 (PU)=43kΩ (35~51kΩ), I= 76.74uA (64.70~94.59uA) | 1.8V mode: PAD= 1.8V PE=0, PS=0 (HIZ): I < +/- 1uA PE=1, PS=0 (PD)=42kΩ (34~50kΩ), I= 42.85A (36.00~52.94uA) 3.3V mode: PAD= 3.3V PE=0, PS=0 (HIZ): I < +/- 1uA PE=1, PS=0 (PD)=43kΩ (35~51kΩ), I= 76.70uA (64.70~94.59uA) | Yes | (00) = 4 mA (01) = 8 mA (10) = 12 mA (11) = 16 mA | 0:4d00103E1E,bit7 1:4d00103E1F,bit8 | 2'b0 | reg[103E1E]#11 | 1 | reg[103E1E]#6 | reg[103E1E]#9 | 1. not support fail-safe (不支援防倒灌) 2. support PAD to C control | Level/Edge
16 | PAD_GPIO8 | PAD_GPIO8 | default is GPIO | 103E | 16 | reg_gpio_en;reg[103E20]#3= 1b |  | reg[103E20]#2 | reg[103E20]#0 | reg[103E20]#1 | paddsh_pdas16p2dg_ie_slew | input, pull-up | input, pull-up | input, pull-up | No | No | 1.8V mode PE=1, PS=1: PU=42kΩ (34~50kΩ) 3.3V mode PE=1, PS=1: PU=43kΩ (35~51kΩ) | 1.8V mode PE=1, PS=0: PD=42kΩ (34~50kΩ) 3.3V mode PE=1, PS=0: PD=43kΩ (35~51kΩ) | 1.8V mode: PAD= 0V PE=0, PS=0 (HIZ): I < +/- 1uA PE=1, PS=1 (PU)=42kΩ (34~50kΩ), I= 42.85uA (36.00~52.94uA) 3.3V mode: PAD= 0V PE=0, PS=0 (HIZ): I < +/- 1uA PE=1, PS=1 (PU)=43kΩ (35~51kΩ), I= 76.74uA (64.70~94.59uA) | 1.8V mode: PAD= 1.8V PE=0, PS=0 (HIZ): I < +/- 1uA PE=1, PS=0 (PD)=42kΩ (34~50kΩ), I= 42.85A (36.00~52.94uA) 3.3V mode: PAD= 3.3V PE=0, PS=0 (HIZ): I < +/- 1uA PE=1, PS=0 (PD)=43kΩ (35~51kΩ), I= 76.70uA (64.70~94.59uA) | Yes | (00) = 4 mA (01) = 8 mA (10) = 12 mA (11) = 16 mA | 0:4d00103E20,bit7 1:4d00103E21,bit8 | 2'b0 | reg[103E20]#11 | 1 | reg[103E20]#6 | reg[103E20]#9 | 1. not support fail-safe (不支援防倒灌) 2. support PAD to C control | Level/Edge
17 | PAD_GPIO9 | PAD_GPIO9 | default is GPIO | 103E | 17 | reg_gpio_en;reg[103E22]#3= 1b |  | reg[103E22]#2 | reg[103E22]#0 | reg[103E22]#1 | paddsv_pdas16p2dg_ie_slew | input, pull-up | input, pull-up | input, pull-up | No | No | 1.8V mode PE=1, PS=1: PU=42kΩ (34~50kΩ) 3.3V mode PE=1, PS=1: PU=43kΩ (35~51kΩ) | 1.8V mode PE=1, PS=0: PD=42kΩ (34~50kΩ) 3.3V mode PE=1, PS=0: PD=43kΩ (35~51kΩ) | 1.8V mode: PAD= 0V PE=0, PS=0 (HIZ): I < +/- 1uA PE=1, PS=1 (PU)=42kΩ (34~50kΩ), I= 42.85uA (36.00~52.94uA) 3.3V mode: PAD= 0V PE=0, PS=0 (HIZ): I < +/- 1uA PE=1, PS=1 (PU)=43kΩ (35~51kΩ), I= 76.74uA (64.70~94.59uA) | 1.8V mode: PAD= 1.8V PE=0, PS=0 (HIZ): I < +/- 1uA PE=1, PS=0 (PD)=42kΩ (34~50kΩ), I= 42.85A (36.00~52.94uA) 3.3V mode: PAD= 3.3V PE=0, PS=0 (HIZ): I < +/- 1uA PE=1, PS=0 (PD)=43kΩ (35~51kΩ), I= 76.70uA (64.70~94.59uA) | Yes | (00) = 4 mA (01) = 8 mA (10) = 12 mA (11) = 16 mA | 0:4d00103E22,bit7 1:4d00103E23,bit8 | 2'b0 | reg[103E22]#11 | 1 | reg[103E22]#6 | reg[103E22]#9 | Input: 150MHz@3.3V 150MHz@1.8V Output: 150MHz@3.3V@15pF 150MHz@1.8V@15pF | Level/Edge
18 | PAD_GPIO10 | PAD_GPIO10 | default is GPIO | 103E | 18 | reg_gpio_en;reg[103E24]#3= 1b |  | reg[103E24]#2 | reg[103E24]#0 | reg[103E24]#1 | paddsv_pdas16p2dg_ie | input, pull-up | input, pull-up | input, pull-up | No | No | 1.8V mode PE=1, PS=1: PU=42kΩ (34~50kΩ) 3.3V mode PE=1, PS=1: PU=43kΩ (35~51kΩ) | 1.8V mode PE=1, PS=0: PD=42kΩ (34~50kΩ) 3.3V mode PE=1, PS=0: PD=43kΩ (35~51kΩ) | 1.8V mode: PAD= 0V PE=0, PS=0 (HIZ): I < +/- 1uA PE=1, PS=1 (PU)=42kΩ (34~50kΩ), I= 42.85uA (36.00~52.94uA) 3.3V mode: PAD= 0V PE=0, PS=0 (HIZ): I < +/- 1uA PE=1, PS=1 (PU)=43kΩ (35~51kΩ), I= 76.74uA (64.70~94.59uA) | 1.8V mode: PAD= 1.8V PE=0, PS=0 (HIZ): I < +/- 1uA PE=1, PS=0 (PD)=42kΩ (34~50kΩ), I= 42.85A (36.00~52.94uA) 3.3V mode: PAD= 3.3V PE=0, PS=0 (HIZ): I < +/- 1uA PE=1, PS=0 (PD)=43kΩ (35~51kΩ), I= 76.70uA (64.70~94.59uA) | Yes | (00) = 4 mA (01) = 8 mA (10) = 12 mA (11) = 16 mA | 0:4d00103E24,bit7 1:4d00103E25,bit8 | 2'b0 | reg[103E24]#11 | 1 | reg[103E24]#6 | reg[103E24]#9 | Input: 150MHz@3.3V 150MHz@1.8V Output: 150MHz@3.3V@15pF 104MHz@3.3V@30pF 150MHz@1.8V@15pF | Level/Edge
19 | PAD_GPIO11 | PAD_GPIO11 | default is GPIO | 103E | 19 | reg_gpio_en;reg[103E26]#3= 1b |  | reg[103E26]#2 | reg[103E26]#0 | reg[103E26]#1 | paddsv_pdas16p2dg_ie | input, pull-up | input, pull-up | input, pull-up | No | No | 1.8V mode PE=1, PS=1: PU=42kΩ (34~50kΩ) 3.3V mode PE=1, PS=1: PU=43kΩ (35~51kΩ) | 1.8V mode PE=1, PS=0: PD=42kΩ (34~50kΩ) 3.3V mode PE=1, PS=0: PD=43kΩ (35~51kΩ) | 1.8V mode: PAD= 0V PE=0, PS=0 (HIZ): I < +/- 1uA PE=1, PS=1 (PU)=42kΩ (34~50kΩ), I= 42.85uA (36.00~52.94uA) 3.3V mode: PAD= 0V PE=0, PS=0 (HIZ): I < +/- 1uA PE=1, PS=1 (PU)=43kΩ (35~51kΩ), I= 76.74uA (64.70~94.59uA) | 1.8V mode: PAD= 1.8V PE=0, PS=0 (HIZ): I < +/- 1uA PE=1, PS=0 (PD)=42kΩ (34~50kΩ), I= 42.85A (36.00~52.94uA) 3.3V mode: PAD= 3.3V PE=0, PS=0 (HIZ): I < +/- 1uA PE=1, PS=0 (PD)=43kΩ (35~51kΩ), I= 76.70uA (64.70~94.59uA) | Yes | (00) = 4 mA (01) = 8 mA (10) = 12 mA (11) = 16 mA | 0:4d00103E26,bit7 1:4d00103E27,bit8 | 2'b0 | reg[103E26]#11 | 1 | reg[103E26]#6 | reg[103E26]#9 | Input: 150MHz@3.3V 150MHz@1.8V Output: 150MHz@3.3V@15pF 104MHz@3.3V@30pF 150MHz@1.8V@15pF | Level/Edge
20 | PAD_SD0_CDZ | PAD_SD0_CDZ | default is GPIO | 103E | 20 | reg_gpio_en;reg[103E28]#3= 1b |  | reg[103E28]#2 | reg[103E28]#0 | reg[103E28]#1 | paddsv_pdas16p2dg_ie | input, pull-up | input, pull-up | input, pull-up | No | No | 1.8V mode PE=1, PS=1: PU=42kΩ (34~50kΩ) 3.3V mode PE=1, PS=1: PU=43kΩ (35~51kΩ) | 1.8V mode PE=1, PS=0: PD=42kΩ (34~50kΩ) 3.3V mode PE=1, PS=0: PD=43kΩ (35~51kΩ) | 1.8V mode: PAD= 0V PE=0, PS=0 (HIZ): I < +/- 1uA PE=1, PS=1 (PU)=42kΩ (34~50kΩ), I= 42.85uA (36.00~52.94uA) 3.3V mode: PAD= 0V PE=0, PS=0 (HIZ): I < +/- 1uA PE=1, PS=1 (PU)=43kΩ (35~51kΩ), I= 76.74uA (64.70~94.59uA) | 1.8V mode: PAD= 1.8V PE=0, PS=0 (HIZ): I < +/- 1uA PE=1, PS=0 (PD)=42kΩ (34~50kΩ), I= 42.85A (36.00~52.94uA) 3.3V mode: PAD= 3.3V PE=0, PS=0 (HIZ): I < +/- 1uA PE=1, PS=0 (PD)=43kΩ (35~51kΩ), I= 76.70uA (64.70~94.59uA) | Yes | (00) = 4 mA (01) = 8 mA (10) = 12 mA (11) = 16 mA | 0:4d00103E28,bit7 1:4d00103E29,bit8 | 2'b0 | reg[103E28]#11 | 1 | reg[103E28]#6 | reg[103E28]#9 | Input: 150MHz@3.3V 150MHz@1.8V Output: 150MHz@3.3V@15pF 104MHz@3.3V@30pF 150MHz@1.8V@15pF | Level/Edge
21 | PAD_SD0_D1 | PAD_SD0_D1 | default is GPIO | 103E | 21 | reg_gpio_en;reg[103E2A]#3= 1b |  | reg[103E2A]#2 | reg[103E2A]#0 | reg[103E2A]#1 | paddsv_pdas16p2dg_ie | input, pull-up | input, pull-up | input, pull-up | No | No | 1.8V mode PE=1, PS=1: PU=42kΩ (34~50kΩ) 3.3V mode PE=1, PS=1: PU=43kΩ (35~51kΩ) | 1.8V mode PE=1, PS=0: PD=42kΩ (34~50kΩ) 3.3V mode PE=1, PS=0: PD=43kΩ (35~51kΩ) | 1.8V mode: PAD= 0V PE=0, PS=0 (HIZ): I < +/- 1uA PE=1, PS=1 (PU)=42kΩ (34~50kΩ), I= 42.85uA (36.00~52.94uA) 3.3V mode: PAD= 0V PE=0, PS=0 (HIZ): I < +/- 1uA PE=1, PS=1 (PU)=43kΩ (35~51kΩ), I= 76.74uA (64.70~94.59uA) | 1.8V mode: PAD= 1.8V PE=0, PS=0 (HIZ): I < +/- 1uA PE=1, PS=0 (PD)=42kΩ (34~50kΩ), I= 42.85A (36.00~52.94uA) 3.3V mode: PAD= 3.3V PE=0, PS=0 (HIZ): I < +/- 1uA PE=1, PS=0 (PD)=43kΩ (35~51kΩ), I= 76.70uA (64.70~94.59uA) | Yes | (00) = 4 mA (01) = 8 mA (10) = 12 mA (11) = 16 mA | 0:4d00103E2A,bit7 1:4d00103E2B,bit8 | 2'b0 | reg[103E2A]#11 | 1 | reg[103E2A]#6 | reg[103E2A]#9 | Input: 150MHz@3.3V 150MHz@1.8V Output: 150MHz@3.3V@15pF 104MHz@3.3V@30pF 150MHz@1.8V@15pF | Level/Edge
22 | PAD_SD0_D0 | PAD_SD0_D0 | default is GPIO | 103E | 22 | reg_gpio_en;reg[103E2C]#3= 1b |  | reg[103E2C]#2 | reg[103E2C]#0 | reg[103E2C]#1 | paddsv_pdas16p2dg_ie | input, pull-up | input, pull-up | input, pull-up | No | No | 1.8V mode PE=1, PS=1: PU=42kΩ (34~50kΩ) 3.3V mode PE=1, PS=1: PU=43kΩ (35~51kΩ) | 1.8V mode PE=1, PS=0: PD=42kΩ (34~50kΩ) 3.3V mode PE=1, PS=0: PD=43kΩ (35~51kΩ) | 1.8V mode: PAD= 0V PE=0, PS=0 (HIZ): I < +/- 1uA PE=1, PS=1 (PU)=42kΩ (34~50kΩ), I= 42.85uA (36.00~52.94uA) 3.3V mode: PAD= 0V PE=0, PS=0 (HIZ): I < +/- 1uA PE=1, PS=1 (PU)=43kΩ (35~51kΩ), I= 76.74uA (64.70~94.59uA) | 1.8V mode: PAD= 1.8V PE=0, PS=0 (HIZ): I < +/- 1uA PE=1, PS=0 (PD)=42kΩ (34~50kΩ), I= 42.85A (36.00~52.94uA) 3.3V mode: PAD= 3.3V PE=0, PS=0 (HIZ): I < +/- 1uA PE=1, PS=0 (PD)=43kΩ (35~51kΩ), I= 76.70uA (64.70~94.59uA) | Yes | (00) = 4 mA (01) = 8 mA (10) = 12 mA (11) = 16 mA | 0:4d00103E2C,bit7 1:4d00103E2D,bit8 | 2'b0 | reg[103E2C]#11 | 1 | reg[103E2C]#6 | reg[103E2C]#9 | Input: 150MHz@3.3V 150MHz@1.8V Output: 150MHz@3.3V@15pF 104MHz@3.3V@30pF 150MHz@1.8V@15pF | Level/Edge
23 | PAD_SD0_CLK | PAD_SD0_CLK | default is GPIO | 103E | 23 | reg_gpio_en;reg[103E2E]#3= 1b |  | reg[103E2E]#2 | reg[103E2E]#0 | reg[103E2E]#1 | paddsv_pdas16p2dg_ie_c2 | input, pull-down | input, pull-down | input, pull-down | No | No | 1.8V mode PE=1, PS=1: PU=42kΩ (34~50kΩ) 3.3V mode PE=1, PS=1: PU=43kΩ (35~51kΩ) | 1.8V mode PE=1, PS=0: PD=42kΩ (34~50kΩ) 3.3V mode PE=1, PS=0: PD=43kΩ (35~51kΩ) | 1.8V mode: PAD= 0V PE=0, PS=0 (HIZ): I < +/- 1uA PE=1, PS=1 (PU)=42kΩ (34~50kΩ), I= 42.85uA (36.00~52.94uA) 3.3V mode: PAD= 0V PE=0, PS=0 (HIZ): I < +/- 1uA PE=1, PS=1 (PU)=43kΩ (35~51kΩ), I= 76.74uA (64.70~94.59uA) | 1.8V mode: PAD= 1.8V PE=0, PS=0 (HIZ): I < +/- 1uA PE=1, PS=0 (PD)=42kΩ (34~50kΩ), I= 42.85A (36.00~52.94uA) 3.3V mode: PAD= 3.3V PE=0, PS=0 (HIZ): I < +/- 1uA PE=1, PS=0 (PD)=43kΩ (35~51kΩ), I= 76.70uA (64.70~94.59uA) | Yes | (00) = 4 mA (01) = 8 mA (10) = 12 mA (11) = 16 mA | 0:4d00103E2E,bit7 1:4d00103E2F,bit8 | 2'b0 | reg[103E2E]#11 | 0 | reg[103E2E]#6 | reg[103E2E]#9 | Input: 150MHz@3.3V 150MHz@1.8V Output: 150MHz@3.3V@15pF 150MHz@1.8V@15pF | Level/Edge
24 | PAD_SD0_CMD | PAD_SD0_CMD | default is GPIO | 103E | 24 | reg_gpio_en;reg[103E30]#3= 1b |  | reg[103E30]#2 | reg[103E30]#0 | reg[103E30]#1 | paddsv_pdas16p2dg_ie | input, pull-up | input, pull-up | input, pull-up | No | No | 1.8V mode PE=1, PS=1: PU=42kΩ (34~50kΩ) 3.3V mode PE=1, PS=1: PU=43kΩ (35~51kΩ) | 1.8V mode PE=1, PS=0: PD=42kΩ (34~50kΩ) 3.3V mode PE=1, PS=0: PD=43kΩ (35~51kΩ) | 1.8V mode: PAD= 0V PE=0, PS=0 (HIZ): I < +/- 1uA PE=1, PS=1 (PU)=42kΩ (34~50kΩ), I= 42.85uA (36.00~52.94uA) 3.3V mode: PAD= 0V PE=0, PS=0 (HIZ): I < +/- 1uA PE=1, PS=1 (PU)=43kΩ (35~51kΩ), I= 76.74uA (64.70~94.59uA) | 1.8V mode: PAD= 1.8V PE=0, PS=0 (HIZ): I < +/- 1uA PE=1, PS=0 (PD)=42kΩ (34~50kΩ), I= 42.85A (36.00~52.94uA) 3.3V mode: PAD= 3.3V PE=0, PS=0 (HIZ): I < +/- 1uA PE=1, PS=0 (PD)=43kΩ (35~51kΩ), I= 76.70uA (64.70~94.59uA) | Yes | (00) = 4 mA (01) = 8 mA (10) = 12 mA (11) = 16 mA | 0:4d00103E30,bit7 1:4d00103E31,bit8 | 2'b0 | reg[103E30]#11 | 1 | reg[103E30]#6 | reg[103E30]#9 | Input: 150MHz@3.3V 150MHz@1.8V Output: 150MHz@3.3V@15pF 104MHz@3.3V@30pF 150MHz@1.8V@15pF | Level/Edge
25 | PAD_SD0_D3 | PAD_SD0_D3 | default is GPIO | 103E | 25 | reg_gpio_en;reg[103E32]#3= 1b |  | reg[103E32]#2 | reg[103E32]#0 | reg[103E32]#1 | paddsv_pdas16p2dg_ie | input, pull-up | input, pull-up | input, pull-up | No | No | 1.8V mode PE=1, PS=1: PU=42kΩ (34~50kΩ) 3.3V mode PE=1, PS=1: PU=43kΩ (35~51kΩ) | 1.8V mode PE=1, PS=0: PD=42kΩ (34~50kΩ) 3.3V mode PE=1, PS=0: PD=43kΩ (35~51kΩ) | 1.8V mode: PAD= 0V PE=0, PS=0 (HIZ): I < +/- 1uA PE=1, PS=1 (PU)=42kΩ (34~50kΩ), I= 42.85uA (36.00~52.94uA) 3.3V mode: PAD= 0V PE=0, PS=0 (HIZ): I < +/- 1uA PE=1, PS=1 (PU)=43kΩ (35~51kΩ), I= 76.74uA (64.70~94.59uA) | 1.8V mode: PAD= 1.8V PE=0, PS=0 (HIZ): I < +/- 1uA PE=1, PS=0 (PD)=42kΩ (34~50kΩ), I= 42.85A (36.00~52.94uA) 3.3V mode: PAD= 3.3V PE=0, PS=0 (HIZ): I < +/- 1uA PE=1, PS=0 (PD)=43kΩ (35~51kΩ), I= 76.70uA (64.70~94.59uA) | Yes | (00) = 4 mA (01) = 8 mA (10) = 12 mA (11) = 16 mA | 0:4d00103E32,bit7 1:4d00103E33,bit8 | 2'b0 | reg[103E32]#11 | 1 | reg[103E32]#6 | reg[103E32]#9 | Input: 150MHz@3.3V 150MHz@1.8V Output: 150MHz@3.3V@15pF 104MHz@3.3V@30pF 150MHz@1.8V@15pF | Level/Edge
26 | PAD_SD0_D2 | PAD_SD0_D2 | default is GPIO | 103E | 26 | reg_gpio_en;reg[103E34]#3= 1b |  | reg[103E34]#2 | reg[103E34]#0 | reg[103E34]#1 | paddsv_pdas16p2dg_ie | input, pull-up | input, pull-up | input, pull-up | No | No | 1.8V mode PE=1, PS=1: PU=42kΩ (34~50kΩ) 3.3V mode PE=1, PS=1: PU=43kΩ (35~51kΩ) | 1.8V mode PE=1, PS=0: PD=42kΩ (34~50kΩ) 3.3V mode PE=1, PS=0: PD=43kΩ (35~51kΩ) | 1.8V mode: PAD= 0V PE=0, PS=0 (HIZ): I < +/- 1uA PE=1, PS=1 (PU)=42kΩ (34~50kΩ), I= 42.85uA (36.00~52.94uA) 3.3V mode: PAD= 0V PE=0, PS=0 (HIZ): I < +/- 1uA PE=1, PS=1 (PU)=43kΩ (35~51kΩ), I= 76.74uA (64.70~94.59uA) | 1.8V mode: PAD= 1.8V PE=0, PS=0 (HIZ): I < +/- 1uA PE=1, PS=0 (PD)=42kΩ (34~50kΩ), I= 42.85A (36.00~52.94uA) 3.3V mode: PAD= 3.3V PE=0, PS=0 (HIZ): I < +/- 1uA PE=1, PS=0 (PD)=43kΩ (35~51kΩ), I= 76.70uA (64.70~94.59uA) | Yes | (00) = 4 mA (01) = 8 mA (10) = 12 mA (11) = 16 mA | 0:4d00103E34,bit7 1:4d00103E35,bit8 | 2'b0 | reg[103E34]#11 | 1 | reg[103E34]#6 | reg[103E34]#9 | Input: 150MHz@3.3V 150MHz@1.8V Output: 150MHz@3.3V@15pF 104MHz@3.3V@30pF 150MHz@1.8V@15pF | Level/Edge
27 | PAD_FUART_RTS | PAD_FUART_RTS | default is GPIO | 103E | 27 | reg_gpio_en;reg[103E36]#3= 1b |  | reg[103E36]#2 | reg[103E36]#0 | reg[103E36]#1 | paddsv_pdas16p2dg_ie | input, pull-up | input, pull-up | input, pull-up | No | No | 1.8V mode PE=1, PS=1: PU=42kΩ (34~50kΩ) 3.3V mode PE=1, PS=1: PU=43kΩ (35~51kΩ) | 1.8V mode PE=1, PS=0: PD=42kΩ (34~50kΩ) 3.3V mode PE=1, PS=0: PD=43kΩ (35~51kΩ) | 1.8V mode: PAD= 0V PE=0, PS=0 (HIZ): I < +/- 1uA PE=1, PS=1 (PU)=42kΩ (34~50kΩ), I= 42.85uA (36.00~52.94uA) 3.3V mode: PAD= 0V PE=0, PS=0 (HIZ): I < +/- 1uA PE=1, PS=1 (PU)=43kΩ (35~51kΩ), I= 76.74uA (64.70~94.59uA) | 1.8V mode: PAD= 1.8V PE=0, PS=0 (HIZ): I < +/- 1uA PE=1, PS=0 (PD)=42kΩ (34~50kΩ), I= 42.85A (36.00~52.94uA) 3.3V mode: PAD= 3.3V PE=0, PS=0 (HIZ): I < +/- 1uA PE=1, PS=0 (PD)=43kΩ (35~51kΩ), I= 76.70uA (64.70~94.59uA) | Yes | (00) = 4 mA (01) = 8 mA (10) = 12 mA (11) = 16 mA | 0:4d00103E36,bit7 1:4d00103E37,bit8 | 2'b0 | reg[103E36]#11 | 1 | reg[103E36]#6 | reg[103E36]#9 | Input: 150MHz@3.3V 150MHz@1.8V Output: 150MHz@3.3V@15pF 104MHz@3.3V@30pF 150MHz@1.8V@15pF | Level/Edge
28 | PAD_FUART_CTS | PAD_FUART_CTS | default is GPIO | 103E | 28 | reg_gpio_en;reg[103E38]#3= 1b |  | reg[103E38]#2 | reg[103E38]#0 | reg[103E38]#1 | paddsv_pdas16p2dg_ie | input, pull-up | input, pull-up | input, pull-up | No | No | 1.8V mode PE=1, PS=1: PU=42kΩ (34~50kΩ) 3.3V mode PE=1, PS=1: PU=43kΩ (35~51kΩ) | 1.8V mode PE=1, PS=0: PD=42kΩ (34~50kΩ) 3.3V mode PE=1, PS=0: PD=43kΩ (35~51kΩ) | 1.8V mode: PAD= 0V PE=0, PS=0 (HIZ): I < +/- 1uA PE=1, PS=1 (PU)=42kΩ (34~50kΩ), I= 42.85uA (36.00~52.94uA) 3.3V mode: PAD= 0V PE=0, PS=0 (HIZ): I < +/- 1uA PE=1, PS=1 (PU)=43kΩ (35~51kΩ), I= 76.74uA (64.70~94.59uA) | 1.8V mode: PAD= 1.8V PE=0, PS=0 (HIZ): I < +/- 1uA PE=1, PS=0 (PD)=42kΩ (34~50kΩ), I= 42.85A (36.00~52.94uA) 3.3V mode: PAD= 3.3V PE=0, PS=0 (HIZ): I < +/- 1uA PE=1, PS=0 (PD)=43kΩ (35~51kΩ), I= 76.70uA (64.70~94.59uA) | Yes | (00) = 4 mA (01) = 8 mA (10) = 12 mA (11) = 16 mA | 0:4d00103E38,bit7 1:4d00103E39,bit8 | 2'b0 | reg[103E38]#11 | 1 | reg[103E38]#6 | reg[103E38]#9 | Input: 150MHz@3.3V 150MHz@1.8V Output: 150MHz@3.3V@15pF 104MHz@3.3V@30pF 150MHz@1.8V@15pF | Level/Edge
29 | PAD_FUART_RX | PAD_FUART_RX | default is GPIO | 103E | 29 | reg_gpio_en;reg[103E3A]#3= 1b |  | reg[103E3A]#2 | reg[103E3A]#0 | reg[103E3A]#1 | paddsv_pdas16p2dg_ie | input, pull-up | input, pull-up | input, pull-up | No | No | 1.8V mode PE=1, PS=1: PU=42kΩ (34~50kΩ) 3.3V mode PE=1, PS=1: PU=43kΩ (35~51kΩ) | 1.8V mode PE=1, PS=0: PD=42kΩ (34~50kΩ) 3.3V mode PE=1, PS=0: PD=43kΩ (35~51kΩ) | 1.8V mode: PAD= 0V PE=0, PS=0 (HIZ): I < +/- 1uA PE=1, PS=1 (PU)=42kΩ (34~50kΩ), I= 42.85uA (36.00~52.94uA) 3.3V mode: PAD= 0V PE=0, PS=0 (HIZ): I < +/- 1uA PE=1, PS=1 (PU)=43kΩ (35~51kΩ), I= 76.74uA (64.70~94.59uA) | 1.8V mode: PAD= 1.8V PE=0, PS=0 (HIZ): I < +/- 1uA PE=1, PS=0 (PD)=42kΩ (34~50kΩ), I= 42.85A (36.00~52.94uA) 3.3V mode: PAD= 3.3V PE=0, PS=0 (HIZ): I < +/- 1uA PE=1, PS=0 (PD)=43kΩ (35~51kΩ), I= 76.70uA (64.70~94.59uA) | Yes | (00) = 4 mA (01) = 8 mA (10) = 12 mA (11) = 16 mA | 0:4d00103E3A,bit7 1:4d00103E3B,bit8 | 2'b0 | reg[103E3A]#11 | 1 | reg[103E3A]#6 | reg[103E3A]#9 | Input: 150MHz@3.3V 150MHz@1.8V Output: 150MHz@3.3V@15pF 104MHz@3.3V@30pF 150MHz@1.8V@15pF | Level/Edge
30 | PAD_FUART_TX | PAD_FUART_TX | default is GPIO | 103E | 30 | reg_gpio_en;reg[103E3C]#3= 1b |  | reg[103E3C]#2 | reg[103E3C]#0 | reg[103E3C]#1 | paddsv_pdas16p2dg_ie | input, pull-up | input, pull-up | input, pull-up | No | No | 1.8V mode PE=1, PS=1: PU=42kΩ (34~50kΩ) 3.3V mode PE=1, PS=1: PU=43kΩ (35~51kΩ) | 1.8V mode PE=1, PS=0: PD=42kΩ (34~50kΩ) 3.3V mode PE=1, PS=0: PD=43kΩ (35~51kΩ) | 1.8V mode: PAD= 0V PE=0, PS=0 (HIZ): I < +/- 1uA PE=1, PS=1 (PU)=42kΩ (34~50kΩ), I= 42.85uA (36.00~52.94uA) 3.3V mode: PAD= 0V PE=0, PS=0 (HIZ): I < +/- 1uA PE=1, PS=1 (PU)=43kΩ (35~51kΩ), I= 76.74uA (64.70~94.59uA) | 1.8V mode: PAD= 1.8V PE=0, PS=0 (HIZ): I < +/- 1uA PE=1, PS=0 (PD)=42kΩ (34~50kΩ), I= 42.85A (36.00~52.94uA) 3.3V mode: PAD= 3.3V PE=0, PS=0 (HIZ): I < +/- 1uA PE=1, PS=0 (PD)=43kΩ (35~51kΩ), I= 76.70uA (64.70~94.59uA) | Yes | (00) = 4 mA (01) = 8 mA (10) = 12 mA (11) = 16 mA | 0:4d00103E3C,bit7 1:4d00103E3D,bit8 | 2'b0 | reg[103E3C]#11 | 1 | reg[103E3C]#6 | reg[103E3C]#9 | Input: 150MHz@3.3V 150MHz@1.8V Output: 150MHz@3.3V@15pF 104MHz@3.3V@30pF 150MHz@1.8V@15pF | Level/Edge
31 | PAD_MSPI_CZ | PAD_MSPI_CZ | default is GPIO | 103E | 31 | reg_gpio_en;reg[103E3E]#3= 1b |  | reg[103E3E]#2 | reg[103E3E]#0 | reg[103E3E]#1 | paddsv_pdas16p2dg_ie | input, pull-up | input, pull-up | input, pull-up | No | No | 1.8V mode PE=1, PS=1: PU=42kΩ (34~50kΩ) 3.3V mode PE=1, PS=1: PU=43kΩ (35~51kΩ) | 1.8V mode PE=1, PS=0: PD=42kΩ (34~50kΩ) 3.3V mode PE=1, PS=0: PD=43kΩ (35~51kΩ) | 1.8V mode: PAD= 0V PE=0, PS=0 (HIZ): I < +/- 1uA PE=1, PS=1 (PU)=42kΩ (34~50kΩ), I= 42.85uA (36.00~52.94uA) 3.3V mode: PAD= 0V PE=0, PS=0 (HIZ): I < +/- 1uA PE=1, PS=1 (PU)=43kΩ (35~51kΩ), I= 76.74uA (64.70~94.59uA) | 1.8V mode: PAD= 1.8V PE=0, PS=0 (HIZ): I < +/- 1uA PE=1, PS=0 (PD)=42kΩ (34~50kΩ), I= 42.85A (36.00~52.94uA) 3.3V mode: PAD= 3.3V PE=0, PS=0 (HIZ): I < +/- 1uA PE=1, PS=0 (PD)=43kΩ (35~51kΩ), I= 76.70uA (64.70~94.59uA) | Yes | (00) = 4 mA (01) = 8 mA (10) = 12 mA (11) = 16 mA | 0:4d00103E3E,bit7 1:4d00103E3F,bit8 | 2'b0 | reg[103E3E]#11 | 1 | reg[103E3E]#6 | reg[103E3E]#9 | Input: 150MHz@3.3V 150MHz@1.8V Output: 150MHz@3.3V@15pF 104MHz@3.3V@30pF 150MHz@1.8V@15pF | Level/Edge
32 | PAD_MSPI_DO | PAD_MSPI_DO | default is GPIO | 103E | 32 | reg_gpio_en;reg[103E40]#3= 1b |  | reg[103E40]#2 | reg[103E40]#0 | reg[103E40]#1 | paddsv_pdas16p2dg_ie | input, pull-up | input, pull-up | input, pull-up | No | No | 1.8V mode PE=1, PS=1: PU=42kΩ (34~50kΩ) 3.3V mode PE=1, PS=1: PU=43kΩ (35~51kΩ) | 1.8V mode PE=1, PS=0: PD=42kΩ (34~50kΩ) 3.3V mode PE=1, PS=0: PD=43kΩ (35~51kΩ) | 1.8V mode: PAD= 0V PE=0, PS=0 (HIZ): I < +/- 1uA PE=1, PS=1 (PU)=42kΩ (34~50kΩ), I= 42.85uA (36.00~52.94uA) 3.3V mode: PAD= 0V PE=0, PS=0 (HIZ): I < +/- 1uA PE=1, PS=1 (PU)=43kΩ (35~51kΩ), I= 76.74uA (64.70~94.59uA) | 1.8V mode: PAD= 1.8V PE=0, PS=0 (HIZ): I < +/- 1uA PE=1, PS=0 (PD)=42kΩ (34~50kΩ), I= 42.85A (36.00~52.94uA) 3.3V mode: PAD= 3.3V PE=0, PS=0 (HIZ): I < +/- 1uA PE=1, PS=0 (PD)=43kΩ (35~51kΩ), I= 76.70uA (64.70~94.59uA) | Yes | (00) = 4 mA (01) = 8 mA (10) = 12 mA (11) = 16 mA | 0:4d00103E40,bit7 1:4d00103E41,bit8 | 2'b0 | reg[103E40]#11 | 1 | reg[103E40]#6 | reg[103E40]#9 | Input: 150MHz@3.3V 150MHz@1.8V Output: 150MHz@3.3V@15pF 104MHz@3.3V@30pF 150MHz@1.8V@15pF | Level/Edge
33 | PAD_MSPI_DI | PAD_MSPI_DI | default is GPIO | 103E | 33 | reg_gpio_en;reg[103E42]#3= 1b |  | reg[103E42]#2 | reg[103E42]#0 | reg[103E42]#1 | paddsv_pdas16p2dg_ie | input, pull-up | input, pull-up | input, pull-up | No | No | 1.8V mode PE=1, PS=1: PU=42kΩ (34~50kΩ) 3.3V mode PE=1, PS=1: PU=43kΩ (35~51kΩ) | 1.8V mode PE=1, PS=0: PD=42kΩ (34~50kΩ) 3.3V mode PE=1, PS=0: PD=43kΩ (35~51kΩ) | 1.8V mode: PAD= 0V PE=0, PS=0 (HIZ): I < +/- 1uA PE=1, PS=1 (PU)=42kΩ (34~50kΩ), I= 42.85uA (36.00~52.94uA) 3.3V mode: PAD= 0V PE=0, PS=0 (HIZ): I < +/- 1uA PE=1, PS=1 (PU)=43kΩ (35~51kΩ), I= 76.74uA (64.70~94.59uA) | 1.8V mode: PAD= 1.8V PE=0, PS=0 (HIZ): I < +/- 1uA PE=1, PS=0 (PD)=42kΩ (34~50kΩ), I= 42.85A (36.00~52.94uA) 3.3V mode: PAD= 3.3V PE=0, PS=0 (HIZ): I < +/- 1uA PE=1, PS=0 (PD)=43kΩ (35~51kΩ), I= 76.70uA (64.70~94.59uA) | Yes | (00) = 4 mA (01) = 8 mA (10) = 12 mA (11) = 16 mA | 0:4d00103E42,bit7 1:4d00103E43,bit8 | 2'b0 | reg[103E42]#11 | 1 | reg[103E42]#6 | reg[103E42]#9 | Input: 150MHz@3.3V 150MHz@1.8V Output: 150MHz@3.3V@15pF 104MHz@3.3V@30pF 150MHz@1.8V@15pF | Level/Edge
34 | PAD_MSPI_CK | PAD_MSPI_CK | default is GPIO | 103E | 34 | reg_gpio_en;reg[103E44]#3= 1b |  | reg[103E44]#2 | reg[103E44]#0 | reg[103E44]#1 | paddsv_pdas16p2dg_ie | input, pull-down | input, pull-down | input, pull-down | No | No | 1.8V mode PE=1, PS=1: PU=42kΩ (34~50kΩ) 3.3V mode PE=1, PS=1: PU=43kΩ (35~51kΩ) | 1.8V mode PE=1, PS=0: PD=42kΩ (34~50kΩ) 3.3V mode PE=1, PS=0: PD=43kΩ (35~51kΩ) | 1.8V mode: PAD= 0V PE=0, PS=0 (HIZ): I < +/- 1uA PE=1, PS=1 (PU)=42kΩ (34~50kΩ), I= 42.85uA (36.00~52.94uA) 3.3V mode: PAD= 0V PE=0, PS=0 (HIZ): I < +/- 1uA PE=1, PS=1 (PU)=43kΩ (35~51kΩ), I= 76.74uA (64.70~94.59uA) | 1.8V mode: PAD= 1.8V PE=0, PS=0 (HIZ): I < +/- 1uA PE=1, PS=0 (PD)=42kΩ (34~50kΩ), I= 42.85A (36.00~52.94uA) 3.3V mode: PAD= 3.3V PE=0, PS=0 (HIZ): I < +/- 1uA PE=1, PS=0 (PD)=43kΩ (35~51kΩ), I= 76.70uA (64.70~94.59uA) | Yes | (00) = 4 mA (01) = 8 mA (10) = 12 mA (11) = 16 mA | 0:4d00103E44,bit7 1:4d00103E45,bit8 | 2'b0 | reg[103E44]#11 | 0 | reg[103E44]#6 | reg[103E44]#9 | Input: 150MHz@3.3V 150MHz@1.8V Output: 150MHz@3.3V@15pF 104MHz@3.3V@30pF 150MHz@1.8V@15pF | Level/Edge
35 | PAD_SPI0_DO | PAD_SPI0_DO | default is NOT GPIO | 103E | 35 | reg_gpio_en;reg[103E46]#3= 1b | reg_spi_en disable; reg[103cfb] #[0] == 1； spi_ext_en : reg[103c72]#[5-0]=3Fh, | reg[103E46]#2 | reg[103E46]#0 | reg[103E46]#1 | paddsv_pdas16p2dg_ie | input, pull-up | input, pull-up | input, pull-up | No | No | 1.8V mode PE=1, PS=1: PU=42kΩ (34~50kΩ) 3.3V mode PE=1, PS=1: PU=43kΩ (35~51kΩ) | 1.8V mode PE=1, PS=0: PD=42kΩ (34~50kΩ) 3.3V mode PE=1, PS=0: PD=43kΩ (35~51kΩ) | 1.8V mode: PAD= 0V PE=0, PS=0 (HIZ): I < +/- 1uA PE=1, PS=1 (PU)=42kΩ (34~50kΩ), I= 42.85uA (36.00~52.94uA) 3.3V mode: PAD= 0V PE=0, PS=0 (HIZ): I < +/- 1uA PE=1, PS=1 (PU)=43kΩ (35~51kΩ), I= 76.74uA (64.70~94.59uA) | 1.8V mode: PAD= 1.8V PE=0, PS=0 (HIZ): I < +/- 1uA PE=1, PS=0 (PD)=42kΩ (34~50kΩ), I= 42.85A (36.00~52.94uA) 3.3V mode: PAD= 3.3V PE=0, PS=0 (HIZ): I < +/- 1uA PE=1, PS=0 (PD)=43kΩ (35~51kΩ), I= 76.70uA (64.70~94.59uA) | Yes | (00) = 4 mA (01) = 8 mA (10) = 12 mA (11) = 16 mA | 0:4d00103E46,bit7 1:4d00103E47,bit8 | 2'b10 | reg[103E46]#11 | 1 | reg[103E46]#6 | reg[103E46]#9 | Input: 150MHz@3.3V 150MHz@1.8V Output: 150MHz@3.3V@15pF 104MHz@3.3V@30pF 150MHz@1.8V@15pF | Level/Edge
36 | PAD_SPI0_DI | PAD_SPI0_DI | default is NOT GPIO | 103E | 36 | reg_gpio_en;reg[103E48]#3= 1b | reg_spi_en disable; reg[103cfb] #[0] == 1； spi_ext_en : reg[103c72]#[5-0]=3Fh, | reg[103E48]#2 | reg[103E48]#0 | reg[103E48]#1 | paddsv_pdas16p2dg_ie | input, pull-up | input, pull-up | input, pull-up | No | No | 1.8V mode PE=1, PS=1: PU=42kΩ (34~50kΩ) 3.3V mode PE=1, PS=1: PU=43kΩ (35~51kΩ) | 1.8V mode PE=1, PS=0: PD=42kΩ (34~50kΩ) 3.3V mode PE=1, PS=0: PD=43kΩ (35~51kΩ) | 1.8V mode: PAD= 0V PE=0, PS=0 (HIZ): I < +/- 1uA PE=1, PS=1 (PU)=42kΩ (34~50kΩ), I= 42.85uA (36.00~52.94uA) 3.3V mode: PAD= 0V PE=0, PS=0 (HIZ): I < +/- 1uA PE=1, PS=1 (PU)=43kΩ (35~51kΩ), I= 76.74uA (64.70~94.59uA) | 1.8V mode: PAD= 1.8V PE=0, PS=0 (HIZ): I < +/- 1uA PE=1, PS=0 (PD)=42kΩ (34~50kΩ), I= 42.85A (36.00~52.94uA) 3.3V mode: PAD= 3.3V PE=0, PS=0 (HIZ): I < +/- 1uA PE=1, PS=0 (PD)=43kΩ (35~51kΩ), I= 76.70uA (64.70~94.59uA) | Yes | (00) = 4 mA (01) = 8 mA (10) = 12 mA (11) = 16 mA | 0:4d00103E48,bit7 1:4d00103E49,bit8 | 2'b10 | reg[103E48]#11 | 1 | reg[103E48]#6 | reg[103E48]#9 | Input: 150MHz@3.3V 150MHz@1.8V Output: 150MHz@3.3V@15pF 104MHz@3.3V@30pF 150MHz@1.8V@15pF | Level/Edge
37 | PAD_SPI0_HLD | PAD_SPI0_HLD | default is NOT GPIO | 103E | 37 | reg_gpio_en;reg[103E4A]#3= 1b | reg_spi_en disable; reg[103cfb] #[0] == 1； spi_ext_en : reg[103c72]#[5-0]=3Fh, | reg[103E4A]#2 | reg[103E4A]#0 | reg[103E4A]#1 | paddsv_pdas16p2dg_ie | input, pull-up | input, pull-up | input, pull-up | No | No | 1.8V mode PE=1, PS=1: PU=42kΩ (34~50kΩ) 3.3V mode PE=1, PS=1: PU=43kΩ (35~51kΩ) | 1.8V mode PE=1, PS=0: PD=42kΩ (34~50kΩ) 3.3V mode PE=1, PS=0: PD=43kΩ (35~51kΩ) | 1.8V mode: PAD= 0V PE=0, PS=0 (HIZ): I < +/- 1uA PE=1, PS=1 (PU)=42kΩ (34~50kΩ), I= 42.85uA (36.00~52.94uA) 3.3V mode: PAD= 0V PE=0, PS=0 (HIZ): I < +/- 1uA PE=1, PS=1 (PU)=43kΩ (35~51kΩ), I= 76.74uA (64.70~94.59uA) | 1.8V mode: PAD= 1.8V PE=0, PS=0 (HIZ): I < +/- 1uA PE=1, PS=0 (PD)=42kΩ (34~50kΩ), I= 42.85A (36.00~52.94uA) 3.3V mode: PAD= 3.3V PE=0, PS=0 (HIZ): I < +/- 1uA PE=1, PS=0 (PD)=43kΩ (35~51kΩ), I= 76.70uA (64.70~94.59uA) | Yes | (00) = 4 mA (01) = 8 mA (10) = 12 mA (11) = 16 mA | 0:4d00103E4A,bit7 1:4d00103E4B,bit8 | 2'b10 | reg[103E4A]#11 | 1 | reg[103E4A]#6 | reg[103E4A]#9 | Input: 150MHz@3.3V 150MHz@1.8V Output: 150MHz@3.3V@15pF 104MHz@3.3V@30pF 150MHz@1.8V@15pF | Level/Edge
38 | PAD_SPI0_WPZ | PAD_SPI0_WPZ | default is NOT GPIO | 103E | 38 | reg_gpio_en;reg[103E4C]#3= 1b | reg_spi_en disable; reg[103cfb] #[0] == 1； spi_ext_en : reg[103c72]#[5-0]=3Fh, | reg[103E4C]#2 | reg[103E4C]#0 | reg[103E4C]#1 | paddsv_pdas16p2dg_ie | input, pull-up | input, pull-up | input, pull-up | No | No | 1.8V mode PE=1, PS=1: PU=42kΩ (34~50kΩ) 3.3V mode PE=1, PS=1: PU=43kΩ (35~51kΩ) | 1.8V mode PE=1, PS=0: PD=42kΩ (34~50kΩ) 3.3V mode PE=1, PS=0: PD=43kΩ (35~51kΩ) | 1.8V mode: PAD= 0V PE=0, PS=0 (HIZ): I < +/- 1uA PE=1, PS=1 (PU)=42kΩ (34~50kΩ), I= 42.85uA (36.00~52.94uA) 3.3V mode: PAD= 0V PE=0, PS=0 (HIZ): I < +/- 1uA PE=1, PS=1 (PU)=43kΩ (35~51kΩ), I= 76.74uA (64.70~94.59uA) | 1.8V mode: PAD= 1.8V PE=0, PS=0 (HIZ): I < +/- 1uA PE=1, PS=0 (PD)=42kΩ (34~50kΩ), I= 42.85A (36.00~52.94uA) 3.3V mode: PAD= 3.3V PE=0, PS=0 (HIZ): I < +/- 1uA PE=1, PS=0 (PD)=43kΩ (35~51kΩ), I= 76.70uA (64.70~94.59uA) | Yes | (00) = 4 mA (01) = 8 mA (10) = 12 mA (11) = 16 mA | 0:4d00103E4C,bit7 1:4d00103E4D,bit8 | 2'b10 | reg[103E4C]#11 | 1 | reg[103E4C]#6 | reg[103E4C]#9 | Input: 150MHz@3.3V 150MHz@1.8V Output: 150MHz@3.3V@15pF 104MHz@3.3V@30pF 150MHz@1.8V@15pF | Level/Edge
39 | PAD_SPI0_CZ | PAD_SPI0_CZ | default is NOT GPIO | 103E | 39 | reg_gpio_en;reg[103E4E]#3= 1b | reg_spi_en disable; reg[103cfb] #[0] == 1； spi_ext_en : reg[103c72]#[5-0]=3Fh, | reg[103E4E]#2 | reg[103E4E]#0 | reg[103E4E]#1 | paddsv_pdas16p2dg_ie | output | output | output | No | No | 1.8V mode PE=1, PS=1: PU=42kΩ (34~50kΩ) 3.3V mode PE=1, PS=1: PU=43kΩ (35~51kΩ) | 1.8V mode PE=1, PS=0: PD=42kΩ (34~50kΩ) 3.3V mode PE=1, PS=0: PD=43kΩ (35~51kΩ) | 1.8V mode: PAD= 0V PE=0, PS=0 (HIZ): I < +/- 1uA PE=1, PS=1 (PU)=42kΩ (34~50kΩ), I= 42.85uA (36.00~52.94uA) 3.3V mode: PAD= 0V PE=0, PS=0 (HIZ): I < +/- 1uA PE=1, PS=1 (PU)=43kΩ (35~51kΩ), I= 76.74uA (64.70~94.59uA) | 1.8V mode: PAD= 1.8V PE=0, PS=0 (HIZ): I < +/- 1uA PE=1, PS=0 (PD)=42kΩ (34~50kΩ), I= 42.85A (36.00~52.94uA) 3.3V mode: PAD= 3.3V PE=0, PS=0 (HIZ): I < +/- 1uA PE=1, PS=0 (PD)=43kΩ (35~51kΩ), I= 76.70uA (64.70~94.59uA) | Yes | (00) = 4 mA (01) = 8 mA (10) = 12 mA (11) = 16 mA | 0:4d00103E4E,bit7 1:4d00103E4F,bit8 | 2'b10 | reg[103E4E]#11 | 1 | reg[103E4E]#6 | reg[103E4E]#9 | Input: 150MHz@3.3V 150MHz@1.8V Output: 150MHz@3.3V@15pF 104MHz@3.3V@30pF 150MHz@1.8V@15pF | Level/Edge
40 | PAD_SPI0_CK | PAD_SPI0_CK | default is NOT GPIO | 103E | 40 | reg_gpio_en;reg[103E50]#3= 1b | reg_spi_en disable; reg[103cfb] #[0] == 1； spi_ext_en : reg[103c72]#[5-0]=3Fh, | reg[103E50]#2 | reg[103E50]#0 | reg[103E50]#1 | paddsh_pdas16p3dg_ie_c2_spi | output | output | output | No | No | 1.8V mode PE=1, PS=1: PU=42kΩ (34~50kΩ) 3.3V mode PE=1, PS=1: PU=43kΩ (35~51kΩ) | 1.8V mode PE=1, PS=0: PD=42kΩ (34~50kΩ) 3.3V mode PE=1, PS=0: PD=43kΩ (35~51kΩ) | 1.8V mode: PAD= 0V PE=0, PS=0 (HIZ): I < +/- 1uA PE=1, PS=1 (PU)=42kΩ (34~50kΩ), I= 42.85uA (36.00~52.94uA) 3.3V mode: PAD= 0V PE=0, PS=0 (HIZ): I < +/- 1uA PE=1, PS=1 (PU)=43kΩ (35~51kΩ), I= 76.74uA (64.70~94.59uA) | 1.8V mode: PAD= 1.8V PE=0, PS=0 (HIZ): I < +/- 1uA PE=1, PS=0 (PD)=42kΩ (34~50kΩ), I= 42.85A (36.00~52.94uA) 3.3V mode: PAD= 3.3V PE=0, PS=0 (HIZ): I < +/- 1uA PE=1, PS=0 (PD)=43kΩ (35~51kΩ), I= 76.70uA (64.70~94.59uA) | Yes | (000) = 2 mA (001) = 4 mA (010) = 6 mA (011) = 8 mA (100) = 10 mA (101) = 12 mA (110) = 14 mA (111) = 16 mA | 0:4d00103E50,bit7 1:4d00103E51,bit8 2:4d00103E51,bit10 | 3'b101 | reg[103E50]#11 | 0 | reg[103E50]#6 | reg[103E50]#9 | 1. not support fail-safe (不支援防倒灌) 2. support PAD to C control | Level/Edge
41 | PAD_I2C0_SDA | PAD_I2C0_SDA | default is GPIO | 103E | 41 | reg_gpio_en;reg[103E52]#3= 1b |  | reg[103E52]#2 | reg[103E52]#0 | reg[103E52]#1 | paddsh_pdas08p2dg_ie_slew | input, pull-up | input, pull-up | input, pull-up | No | No | 1.8V mode PE=1, PS=1: PU=42kΩ (34~50kΩ) 3.3V mode PE=1, PS=1: PU=43kΩ (35~51kΩ) | 1.8V mode PE=1, PS=0: PD=42kΩ (34~50kΩ) 3.3V mode PE=1, PS=0: PD=43kΩ (35~51kΩ) | 1.8V mode: PAD= 0V PE=0, PS=0 (HIZ): I < +/- 1uA PE=1, PS=1 (PU)=42kΩ (34~50kΩ), I= 42.85uA (36.00~52.94uA) 3.3V mode: PAD= 0V PE=0, PS=0 (HIZ): I < +/- 1uA PE=1, PS=1 (PU)=43kΩ (35~51kΩ), I= 76.74uA (64.70~94.59uA) | 1.8V mode: PAD= 1.8V PE=0, PS=0 (HIZ): I < +/- 1uA PE=1, PS=0 (PD)=42kΩ (34~50kΩ), I= 42.85A (36.00~52.94uA) 3.3V mode: PAD= 3.3V PE=0, PS=0 (HIZ): I < +/- 1uA PE=1, PS=0 (PD)=43kΩ (35~51kΩ), I= 76.70uA (64.70~94.59uA) | Yes | (00) = 4 mA (01) = 8 mA (10) = 12 mA (11) = 16 mA | 0:4d00103E52,bit7 1:4d00103E53,bit8 | 2'b0 | reg[103E52]#11 | 1 | reg[103E52]#6 | reg[103E52]#9 | 1. not support fail-safe (不支援防倒灌) 2. support PAD to C control | Level/Edge
42 | PAD_I2C0_SCL | PAD_I2C0_SCL | default is GPIO | 103E | 42 | reg_gpio_en;reg[103E54]#3= 1b |  | reg[103E54]#2 | reg[103E54]#0 | reg[103E54]#1 | paddsh_pdas08p2dg_ie_slew | input, pull-up | input, pull-up | input, pull-up | No | No | 1.8V mode PE=1, PS=1: PU=42kΩ (34~50kΩ) 3.3V mode PE=1, PS=1: PU=43kΩ (35~51kΩ) | 1.8V mode PE=1, PS=0: PD=42kΩ (34~50kΩ) 3.3V mode PE=1, PS=0: PD=43kΩ (35~51kΩ) | 1.8V mode: PAD= 0V PE=0, PS=0 (HIZ): I < +/- 1uA PE=1, PS=1 (PU)=42kΩ (34~50kΩ), I= 42.85uA (36.00~52.94uA) 3.3V mode: PAD= 0V PE=0, PS=0 (HIZ): I < +/- 1uA PE=1, PS=1 (PU)=43kΩ (35~51kΩ), I= 76.74uA (64.70~94.59uA) | 1.8V mode: PAD= 1.8V PE=0, PS=0 (HIZ): I < +/- 1uA PE=1, PS=0 (PD)=42kΩ (34~50kΩ), I= 42.85A (36.00~52.94uA) 3.3V mode: PAD= 3.3V PE=0, PS=0 (HIZ): I < +/- 1uA PE=1, PS=0 (PD)=43kΩ (35~51kΩ), I= 76.70uA (64.70~94.59uA) | Yes | (00) = 4 mA (01) = 8 mA (10) = 12 mA (11) = 16 mA | 0:4d00103E54,bit7 1:4d00103E55,bit8 | 2'b0 | reg[103E54]#11 | 1 | reg[103E54]#6 | reg[103E54]#9 | 1. not support fail-safe (不支援防倒灌) 2. support PAD to C control | Level/Edge
44 | PAD_PM_GPIO11 | PAD_PM_GPIO11 | default is GPIO | 103E | 44 | reg_gpio_en;reg[103E58]#3= 1b |  | reg[103E58]#2 | reg[103E58]#0 | reg[103E58]#1 | paddsh_pdas16p2dg_ie_lpc_ss | input, pull-up | input, pull-up | input, pull-up | No | No | 1.8V mode PE=1, PS=1: PU=42kΩ (34~50kΩ) 3.3V mode PE=1, PS=1: PU=43kΩ (35~51kΩ) | 1.8V mode PE=1, PS=0: PD=42kΩ (34~50kΩ) 3.3V mode PE=1, PS=0: PD=43kΩ (35~51kΩ) | 1.8V mode: PAD= 0V PE=0, PS=0 (HIZ): I < +/- 1uA PE=1, PS=1 (PU)=42kΩ (34~50kΩ), I= 42.85uA (36.00~52.94uA) 3.3V mode: PAD= 0V PE=0, PS=0 (HIZ): I < +/- 1uA PE=1, PS=1 (PU)=43kΩ (35~51kΩ), I= 76.74uA (64.70~94.59uA) | 1.8V mode: PAD= 1.8V PE=0, PS=0 (HIZ): I < +/- 1uA PE=1, PS=0 (PD)=42kΩ (34~50kΩ), I= 42.85A (36.00~52.94uA) 3.3V mode: PAD= 3.3V PE=0, PS=0 (HIZ): I < +/- 1uA PE=1, PS=0 (PD)=43kΩ (35~51kΩ), I= 76.70uA (64.70~94.59uA) | Yes | (00) = 4 mA (01) = 8 mA (10) = 12 mA (11) = 16 mA | 0:3d00003F02,bit7 1:3d00003F03,bit8 | 2'b0 | reg[003F02]#5 | 1 | reg[003F02]#4 | reg[003F02]#6 | 1. not support fail-safe (不支援防倒灌) 2. support PAD to C control | Level/Edge
45 | PAD_PM_UART_TX | PAD_PM_UART_TX | default is NOT GPIO DBUS | 103E | 45 | reg_gpio_en;reg[103E5A]#3= 1b | reg_uart_en disable;reg[003FCA]#4=1b, | reg[103E5A]#2 | reg[103E5A]#0 | reg[103E5A]#1 | paddsh_pdas16p2dg_ie_lpc_ss | input, pull-up | input, pull-up | input, pull-up | No | No | 1.8V mode PE=1, PS=1: PU=42kΩ (34~50kΩ) 3.3V mode PE=1, PS=1: PU=43kΩ (35~51kΩ) | 1.8V mode PE=1, PS=0: PD=42kΩ (34~50kΩ) 3.3V mode PE=1, PS=0: PD=43kΩ (35~51kΩ) | 1.8V mode: PAD= 0V PE=0, PS=0 (HIZ): I < +/- 1uA PE=1, PS=1 (PU)=42kΩ (34~50kΩ), I= 42.85uA (36.00~52.94uA) 3.3V mode: PAD= 0V PE=0, PS=0 (HIZ): I < +/- 1uA PE=1, PS=1 (PU)=43kΩ (35~51kΩ), I= 76.74uA (64.70~94.59uA) | 1.8V mode: PAD= 1.8V PE=0, PS=0 (HIZ): I < +/- 1uA PE=1, PS=0 (PD)=42kΩ (34~50kΩ), I= 42.85A (36.00~52.94uA) 3.3V mode: PAD= 3.3V PE=0, PS=0 (HIZ): I < +/- 1uA PE=1, PS=0 (PD)=43kΩ (35~51kΩ), I= 76.70uA (64.70~94.59uA) | Yes | (00) = 4 mA (01) = 8 mA (10) = 12 mA (11) = 16 mA | 0:3d00003F04,bit7 1:3d00003F05,bit8 | 2'b0 | reg[003F04]#5 | 1 | reg[003F04]#4 | reg[003F04]#6 | 1. not support fail-safe (不支援防倒灌) 2. support PAD to C control | Level/Edge
46 | PAD_PM_UART_RX | PAD_PM_UART_RX | default is NOT GPIO DBUS | 103E | 46 | reg_gpio_en;reg[103E5C]#3= 1b | reg_uart_en disable;reg[003FCA]#4=1b, | reg[103E5C]#2 | reg[103E5C]#0 | reg[103E5C]#1 | paddsh_pdas16p2dg_ie_lpc_ss | input, pull-up | input, pull-up | input, pull-up | No | No | 1.8V mode PE=1, PS=1: PU=42kΩ (34~50kΩ) 3.3V mode PE=1, PS=1: PU=43kΩ (35~51kΩ) | 1.8V mode PE=1, PS=0: PD=42kΩ (34~50kΩ) 3.3V mode PE=1, PS=0: PD=43kΩ (35~51kΩ) | 1.8V mode: PAD= 0V PE=0, PS=0 (HIZ): I < +/- 1uA PE=1, PS=1 (PU)=42kΩ (34~50kΩ), I= 42.85uA (36.00~52.94uA) 3.3V mode: PAD= 0V PE=0, PS=0 (HIZ): I < +/- 1uA PE=1, PS=1 (PU)=43kΩ (35~51kΩ), I= 76.74uA (64.70~94.59uA) | 1.8V mode: PAD= 1.8V PE=0, PS=0 (HIZ): I < +/- 1uA PE=1, PS=0 (PD)=42kΩ (34~50kΩ), I= 42.85A (36.00~52.94uA) 3.3V mode: PAD= 3.3V PE=0, PS=0 (HIZ): I < +/- 1uA PE=1, PS=0 (PD)=43kΩ (35~51kΩ), I= 76.70uA (64.70~94.59uA) | Yes | (00) = 4 mA (01) = 8 mA (10) = 12 mA (11) = 16 mA | 0:3d00003F06,bit7 1:3d00003F07,bit8 | 2'b0 | reg[003F06]#5 | 1 | reg[003F06]#4 | reg[003F06]#6 | 1. not support fail-safe (不支援防倒灌) 2. support PAD to C control | Level/Edge
47 | PAD_PM_PSPI0_INT | PAD_PM_PSPI0_INT | default is GPIO | 103E | 47 | reg_gpio_en;reg[103E5E]#3= 1b |  | reg[103E5E]#2 | reg[103E5E]#0 | reg[103E5E]#1 | paddsh_pdas16p2dg_ie_lpc_ss | input, pull-up | input, pull-up | input, pull-up | No | No | 1.8V mode PE=1, PS=1: PU=42kΩ (34~50kΩ) 3.3V mode PE=1, PS=1: PU=43kΩ (35~51kΩ) | 1.8V mode PE=1, PS=0: PD=42kΩ (34~50kΩ) 3.3V mode PE=1, PS=0: PD=43kΩ (35~51kΩ) | 1.8V mode: PAD= 0V PE=0, PS=0 (HIZ): I < +/- 1uA PE=1, PS=1 (PU)=42kΩ (34~50kΩ), I= 42.85uA (36.00~52.94uA) 3.3V mode: PAD= 0V PE=0, PS=0 (HIZ): I < +/- 1uA PE=1, PS=1 (PU)=43kΩ (35~51kΩ), I= 76.74uA (64.70~94.59uA) | 1.8V mode: PAD= 1.8V PE=0, PS=0 (HIZ): I < +/- 1uA PE=1, PS=0 (PD)=42kΩ (34~50kΩ), I= 42.85A (36.00~52.94uA) 3.3V mode: PAD= 3.3V PE=0, PS=0 (HIZ): I < +/- 1uA PE=1, PS=0 (PD)=43kΩ (35~51kΩ), I= 76.70uA (64.70~94.59uA) | Yes | (00) = 4 mA (01) = 8 mA (10) = 12 mA (11) = 16 mA | 0:3d00003F08,bit7 1:3d00003F09,bit8 | 2'b0 | reg[003F08]#5 | 1 | reg[003F08]#4 | reg[003F08]#6 | 1. not support fail-safe (不支援防倒灌) 2. support PAD to C control | Level/Edge
48 | PAD_PM_PSPI0_DI | PAD_PM_PSPI0_DI | default is GPIO DBUS | 103E | 48 | reg_gpio_en;reg[103E60]#3= 1b |  | reg[103E60]#2 | reg[103E60]#0 | reg[103E60]#1 | paddsh_pdas16p2dg_ie_lpc_ss | input, pull-up | input, pull-up | input, pull-up | No | No | 1.8V mode PE=1, PS=1: PU=42kΩ (34~50kΩ) 3.3V mode PE=1, PS=1: PU=43kΩ (35~51kΩ) | 1.8V mode PE=1, PS=0: PD=42kΩ (34~50kΩ) 3.3V mode PE=1, PS=0: PD=43kΩ (35~51kΩ) | 1.8V mode: PAD= 0V PE=0, PS=0 (HIZ): I < +/- 1uA PE=1, PS=1 (PU)=42kΩ (34~50kΩ), I= 42.85uA (36.00~52.94uA) 3.3V mode: PAD= 0V PE=0, PS=0 (HIZ): I < +/- 1uA PE=1, PS=1 (PU)=43kΩ (35~51kΩ), I= 76.74uA (64.70~94.59uA) | 1.8V mode: PAD= 1.8V PE=0, PS=0 (HIZ): I < +/- 1uA PE=1, PS=0 (PD)=42kΩ (34~50kΩ), I= 42.85A (36.00~52.94uA) 3.3V mode: PAD= 3.3V PE=0, PS=0 (HIZ): I < +/- 1uA PE=1, PS=0 (PD)=43kΩ (35~51kΩ), I= 76.70uA (64.70~94.59uA) | Yes | (00) = 4 mA (01) = 8 mA (10) = 12 mA (11) = 16 mA | 0:3d00003F0A,bit7 1:3d00003F0B,bit8 | 2'b0 | reg[003F0A]#5 | 1 | reg[003F0A]#4 | reg[003F0A]#6 | 1. not support fail-safe (不支援防倒灌) 2. support PAD to C control | Level/Edge
49 | PAD_PM_PSPI0_DO | PAD_PM_PSPI0_DO | default is GPIO DBUS | 103E | 49 | reg_gpio_en;reg[103E62]#3= 1b |  | reg[103E62]#2 | reg[103E62]#0 | reg[103E62]#1 | paddsh_pdas16p2dg_ie_lpc_ss | input, pull-up | input, pull-up | input, pull-up | No | No | 1.8V mode PE=1, PS=1: PU=42kΩ (34~50kΩ) 3.3V mode PE=1, PS=1: PU=43kΩ (35~51kΩ) | 1.8V mode PE=1, PS=0: PD=42kΩ (34~50kΩ) 3.3V mode PE=1, PS=0: PD=43kΩ (35~51kΩ) | 1.8V mode: PAD= 0V PE=0, PS=0 (HIZ): I < +/- 1uA PE=1, PS=1 (PU)=42kΩ (34~50kΩ), I= 42.85uA (36.00~52.94uA) 3.3V mode: PAD= 0V PE=0, PS=0 (HIZ): I < +/- 1uA PE=1, PS=1 (PU)=43kΩ (35~51kΩ), I= 76.74uA (64.70~94.59uA) | 1.8V mode: PAD= 1.8V PE=0, PS=0 (HIZ): I < +/- 1uA PE=1, PS=0 (PD)=42kΩ (34~50kΩ), I= 42.85A (36.00~52.94uA) 3.3V mode: PAD= 3.3V PE=0, PS=0 (HIZ): I < +/- 1uA PE=1, PS=0 (PD)=43kΩ (35~51kΩ), I= 76.70uA (64.70~94.59uA) | Yes | (00) = 4 mA (01) = 8 mA (10) = 12 mA (11) = 16 mA | 0:3d00003F0C,bit7 1:3d00003F0D,bit8 | 2'b0 | reg[003F0C]#5 | 1 | reg[003F0C]#4 | reg[003F0C]#6 | 1. not support fail-safe (不支援防倒灌) 2. support PAD to C control | Level/Edge
50 | PAD_PM_PSPI0_CK | PAD_PM_PSPI0_CK | default is GPIO DBUS | 103E | 50 | reg_gpio_en;reg[103E64]#3= 1b |  | reg[103E64]#2 | reg[103E64]#0 | reg[103E64]#1 | paddsh_pdas16p2dg_ie_lpc_ss | input, pull-down | input, pull-down | input, pull-down | No | No | 1.8V mode PE=1, PS=1: PU=42kΩ (34~50kΩ) 3.3V mode PE=1, PS=1: PU=43kΩ (35~51kΩ) | 1.8V mode PE=1, PS=0: PD=42kΩ (34~50kΩ) 3.3V mode PE=1, PS=0: PD=43kΩ (35~51kΩ) | 1.8V mode: PAD= 0V PE=0, PS=0 (HIZ): I < +/- 1uA PE=1, PS=1 (PU)=42kΩ (34~50kΩ), I= 42.85uA (36.00~52.94uA) 3.3V mode: PAD= 0V PE=0, PS=0 (HIZ): I < +/- 1uA PE=1, PS=1 (PU)=43kΩ (35~51kΩ), I= 76.74uA (64.70~94.59uA) | 1.8V mode: PAD= 1.8V PE=0, PS=0 (HIZ): I < +/- 1uA PE=1, PS=0 (PD)=42kΩ (34~50kΩ), I= 42.85A (36.00~52.94uA) 3.3V mode: PAD= 3.3V PE=0, PS=0 (HIZ): I < +/- 1uA PE=1, PS=0 (PD)=43kΩ (35~51kΩ), I= 76.70uA (64.70~94.59uA) | Yes | (00) = 4 mA (01) = 8 mA (10) = 12 mA (11) = 16 mA | 0:3d00003F0E,bit7 1:3d00003F0F,bit8 | 2'b0 | reg[003F0E]#5 | 0 | reg[003F0E]#4 | reg[003F0E]#6 | 1. not support fail-safe (不支援防倒灌) 2. support PAD to C control | Level/Edge
51 | PAD_PM_PSPI0_CZ | PAD_PM_PSPI0_CZ | default is GPIO DBUS | 103E | 51 | reg_gpio_en;reg[103E66]#3= 1b |  | reg[103E66]#2 | reg[103E66]#0 | reg[103E66]#1 | paddsh_pdas16p2dg_ie_lpc_ss | input, pull-up | input, pull-up | input, pull-up | No | No | 1.8V mode PE=1, PS=1: PU=42kΩ (34~50kΩ) 3.3V mode PE=1, PS=1: PU=43kΩ (35~51kΩ) | 1.8V mode PE=1, PS=0: PD=42kΩ (34~50kΩ) 3.3V mode PE=1, PS=0: PD=43kΩ (35~51kΩ) | 1.8V mode: PAD= 0V PE=0, PS=0 (HIZ): I < +/- 1uA PE=1, PS=1 (PU)=42kΩ (34~50kΩ), I= 42.85uA (36.00~52.94uA) 3.3V mode: PAD= 0V PE=0, PS=0 (HIZ): I < +/- 1uA PE=1, PS=1 (PU)=43kΩ (35~51kΩ), I= 76.74uA (64.70~94.59uA) | 1.8V mode: PAD= 1.8V PE=0, PS=0 (HIZ): I < +/- 1uA PE=1, PS=0 (PD)=42kΩ (34~50kΩ), I= 42.85A (36.00~52.94uA) 3.3V mode: PAD= 3.3V PE=0, PS=0 (HIZ): I < +/- 1uA PE=1, PS=0 (PD)=43kΩ (35~51kΩ), I= 76.70uA (64.70~94.59uA) | Yes | (00) = 4 mA (01) = 8 mA (10) = 12 mA (11) = 16 mA | 0:3d00003F10,bit7 1:3d00003F11,bit8 | 2'b0 | reg[003F10]#5 | 1 | reg[003F10]#4 | reg[003F10]#6 | 1. not support fail-safe (不支援防倒灌) 2. support PAD to C control | Level/Edge
52 | PAD_PM_GPIO10 | PAD_PM_GPIO10 | default is GPIO DBUS | 103E | 52 | reg_gpio_en;reg[103E68]#3= 1b |  | reg[103E68]#2 | reg[103E68]#0 | reg[103E68]#1 | paddsh_pdas16p2dg_ie_lpc_ss | input, pull-up | input, pull-up | input, pull-up | No | No | 1.8V mode PE=1, PS=1: PU=42kΩ (34~50kΩ) 3.3V mode PE=1, PS=1: PU=43kΩ (35~51kΩ) | 1.8V mode PE=1, PS=0: PD=42kΩ (34~50kΩ) 3.3V mode PE=1, PS=0: PD=43kΩ (35~51kΩ) | 1.8V mode: PAD= 0V PE=0, PS=0 (HIZ): I < +/- 1uA PE=1, PS=1 (PU)=42kΩ (34~50kΩ), I= 42.85uA (36.00~52.94uA) 3.3V mode: PAD= 0V PE=0, PS=0 (HIZ): I < +/- 1uA PE=1, PS=1 (PU)=43kΩ (35~51kΩ), I= 76.74uA (64.70~94.59uA) | 1.8V mode: PAD= 1.8V PE=0, PS=0 (HIZ): I < +/- 1uA PE=1, PS=0 (PD)=42kΩ (34~50kΩ), I= 42.85A (36.00~52.94uA) 3.3V mode: PAD= 3.3V PE=0, PS=0 (HIZ): I < +/- 1uA PE=1, PS=0 (PD)=43kΩ (35~51kΩ), I= 76.70uA (64.70~94.59uA) | Yes | (00) = 4 mA (01) = 8 mA (10) = 12 mA (11) = 16 mA | 0:3d00003F12,bit7 1:3d00003F13,bit8 | 2'b0 | reg[003F12]#5 | 1 | reg[003F12]#4 | reg[003F12]#6 | 1. not support fail-safe (不支援防倒灌) 2. support PAD to C control | Level/Edge
53 | PAD_PM_GPIO9 | PAD_PM_GPIO9 | default is GPIO DBUS | 103E | 53 | reg_gpio_en;reg[103E6A]#3= 1b |  | reg[103E6A]#2 | reg[103E6A]#0 | reg[103E6A]#1 | paddsh_pdas16p2dg_ie_lpc_ss | input, pull-up | input, pull-up | input, pull-up | No | No | 1.8V mode PE=1, PS=1: PU=42kΩ (34~50kΩ) 3.3V mode PE=1, PS=1: PU=43kΩ (35~51kΩ) | 1.8V mode PE=1, PS=0: PD=42kΩ (34~50kΩ) 3.3V mode PE=1, PS=0: PD=43kΩ (35~51kΩ) | 1.8V mode: PAD= 0V PE=0, PS=0 (HIZ): I < +/- 1uA PE=1, PS=1 (PU)=42kΩ (34~50kΩ), I= 42.85uA (36.00~52.94uA) 3.3V mode: PAD= 0V PE=0, PS=0 (HIZ): I < +/- 1uA PE=1, PS=1 (PU)=43kΩ (35~51kΩ), I= 76.74uA (64.70~94.59uA) | 1.8V mode: PAD= 1.8V PE=0, PS=0 (HIZ): I < +/- 1uA PE=1, PS=0 (PD)=42kΩ (34~50kΩ), I= 42.85A (36.00~52.94uA) 3.3V mode: PAD= 3.3V PE=0, PS=0 (HIZ): I < +/- 1uA PE=1, PS=0 (PD)=43kΩ (35~51kΩ), I= 76.70uA (64.70~94.59uA) | Yes | (00) = 4 mA (01) = 8 mA (10) = 12 mA (11) = 16 mA | 0:3d00003F14,bit7 1:3d00003F15,bit8 | 2'b0 | reg[003F14]#5 | 1 | reg[003F14]#4 | reg[003F14]#6 | 1. not support fail-safe (不支援防倒灌) 2. support PAD to C control | Level/Edge
54 | PAD_PM_GPIO8 | PAD_PM_GPIO8 | default is GPIO | 103E | 54 | reg_gpio_en;reg[103E6C]#3= 1b |  | reg[103E6C]#2 | reg[103E6C]#0 | reg[103E6C]#1 | paddsh_pdas16p2dg_ie_lpc_ss | input, pull-down | input, pull-down | input, pull-down | No | No | 1.8V mode PE=1, PS=1: PU=42kΩ (34~50kΩ) 3.3V mode PE=1, PS=1: PU=43kΩ (35~51kΩ) | 1.8V mode PE=1, PS=0: PD=42kΩ (34~50kΩ) 3.3V mode PE=1, PS=0: PD=43kΩ (35~51kΩ) | 1.8V mode: PAD= 0V PE=0, PS=0 (HIZ): I < +/- 1uA PE=1, PS=1 (PU)=42kΩ (34~50kΩ), I= 42.85uA (36.00~52.94uA) 3.3V mode: PAD= 0V PE=0, PS=0 (HIZ): I < +/- 1uA PE=1, PS=1 (PU)=43kΩ (35~51kΩ), I= 76.74uA (64.70~94.59uA) | 1.8V mode: PAD= 1.8V PE=0, PS=0 (HIZ): I < +/- 1uA PE=1, PS=0 (PD)=42kΩ (34~50kΩ), I= 42.85A (36.00~52.94uA) 3.3V mode: PAD= 3.3V PE=0, PS=0 (HIZ): I < +/- 1uA PE=1, PS=0 (PD)=43kΩ (35~51kΩ), I= 76.70uA (64.70~94.59uA) | Yes | (00) = 4 mA (01) = 8 mA (10) = 12 mA (11) = 16 mA | 0:3d00003F16,bit7 1:3d00003F17,bit8 | 2'b0 | reg[003F16]#5 | 0 | reg[003F16]#4 | reg[003F16]#6 | 1. not support fail-safe (不支援防倒灌) 2. support PAD to C control | Level/Edge
55 | PAD_PM_GPIO7 | PAD_PM_GPIO7 | default is GPIO | 103E | 55 | reg_gpio_en;reg[103E6E]#3= 1b |  | reg[103E6E]#2 | reg[103E6E]#0 | reg[103E6E]#1 | paddsh_pdas16p2dg_ie_lpc_ss | input, pull-down | input, pull-down | input, pull-down | No | No | 1.8V mode PE=1, PS=1: PU=42kΩ (34~50kΩ) 3.3V mode PE=1, PS=1: PU=43kΩ (35~51kΩ) | 1.8V mode PE=1, PS=0: PD=42kΩ (34~50kΩ) 3.3V mode PE=1, PS=0: PD=43kΩ (35~51kΩ) | 1.8V mode: PAD= 0V PE=0, PS=0 (HIZ): I < +/- 1uA PE=1, PS=1 (PU)=42kΩ (34~50kΩ), I= 42.85uA (36.00~52.94uA) 3.3V mode: PAD= 0V PE=0, PS=0 (HIZ): I < +/- 1uA PE=1, PS=1 (PU)=43kΩ (35~51kΩ), I= 76.74uA (64.70~94.59uA) | 1.8V mode: PAD= 1.8V PE=0, PS=0 (HIZ): I < +/- 1uA PE=1, PS=0 (PD)=42kΩ (34~50kΩ), I= 42.85A (36.00~52.94uA) 3.3V mode: PAD= 3.3V PE=0, PS=0 (HIZ): I < +/- 1uA PE=1, PS=0 (PD)=43kΩ (35~51kΩ), I= 76.70uA (64.70~94.59uA) | Yes | (00) = 4 mA (01) = 8 mA (10) = 12 mA (11) = 16 mA | 0:3d00003F18,bit7 1:3d00003F19,bit8 | 2'b0 | reg[003F18]#5 | 0 | reg[003F18]#4 | reg[003F18]#6 | 1. not support fail-safe (不支援防倒灌) 2. support PAD to C control | Level/Edge
58 | PAD_PM_PWM1 | PAD_PM_PWM1 | default is GPIO DBUS | 103E | 58 | reg_gpio_en;reg[103E74]#3= 1b |  | reg[103E74]#2 | reg[103E74]#0 | reg[103E74]#1 | paddsh_pdas16p2dg_ie_lpc_ss | input, pull-down | input, pull-down | input, pull-down | No | No | 1.8V mode PE=1, PS=1: PU=42kΩ (34~50kΩ) 3.3V mode PE=1, PS=1: PU=43kΩ (35~51kΩ) | 1.8V mode PE=1, PS=0: PD=42kΩ (34~50kΩ) 3.3V mode PE=1, PS=0: PD=43kΩ (35~51kΩ) | 1.8V mode: PAD= 0V PE=0, PS=0 (HIZ): I < +/- 1uA PE=1, PS=1 (PU)=42kΩ (34~50kΩ), I= 42.85uA (36.00~52.94uA) 3.3V mode: PAD= 0V PE=0, PS=0 (HIZ): I < +/- 1uA PE=1, PS=1 (PU)=43kΩ (35~51kΩ), I= 76.74uA (64.70~94.59uA) | 1.8V mode: PAD= 1.8V PE=0, PS=0 (HIZ): I < +/- 1uA PE=1, PS=0 (PD)=42kΩ (34~50kΩ), I= 42.85A (36.00~52.94uA) 3.3V mode: PAD= 3.3V PE=0, PS=0 (HIZ): I < +/- 1uA PE=1, PS=0 (PD)=43kΩ (35~51kΩ), I= 76.70uA (64.70~94.59uA) | Yes | (00) = 4 mA (01) = 8 mA (10) = 12 mA (11) = 16 mA | 0:3d00003F1E,bit7 1:3d00003F1F,bit8 | 2'b0 | reg[003F1E]#5 | 0 | reg[003F1E]#4 | reg[003F1E]#6 | 1. not support fail-safe (不支援防倒灌) 2. support PAD to C control | Level/Edge
59 | PAD_PM_PWM0 | PAD_PM_PWM0 | default is GPIO DBUS | 103E | 59 | reg_gpio_en;reg[103E76]#3= 1b |  | reg[103E76]#2 | reg[103E76]#0 | reg[103E76]#1 | paddsh_pdas16p2dg_ie_lpc_ss | input, pull-down | input, pull-down | input, pull-down | No | No | 1.8V mode PE=1, PS=1: PU=42kΩ (34~50kΩ) 3.3V mode PE=1, PS=1: PU=43kΩ (35~51kΩ) | 1.8V mode PE=1, PS=0: PD=42kΩ (34~50kΩ) 3.3V mode PE=1, PS=0: PD=43kΩ (35~51kΩ) | 1.8V mode: PAD= 0V PE=0, PS=0 (HIZ): I < +/- 1uA PE=1, PS=1 (PU)=42kΩ (34~50kΩ), I= 42.85uA (36.00~52.94uA) 3.3V mode: PAD= 0V PE=0, PS=0 (HIZ): I < +/- 1uA PE=1, PS=1 (PU)=43kΩ (35~51kΩ), I= 76.74uA (64.70~94.59uA) | 1.8V mode: PAD= 1.8V PE=0, PS=0 (HIZ): I < +/- 1uA PE=1, PS=0 (PD)=42kΩ (34~50kΩ), I= 42.85A (36.00~52.94uA) 3.3V mode: PAD= 3.3V PE=0, PS=0 (HIZ): I < +/- 1uA PE=1, PS=0 (PD)=43kΩ (35~51kΩ), I= 76.70uA (64.70~94.59uA) | Yes | (00) = 4 mA (01) = 8 mA (10) = 12 mA (11) = 16 mA | 0:3d00003F20,bit7 1:3d00003F21,bit8 | 2'b0 | reg[003F20]#5 | 0 | reg[003F20]#4 | reg[003F20]#6 | 1. not support fail-safe (不支援防倒灌) 2. support PAD to C control | Level/Edge
60 | PAD_PM_GPIO6 | PAD_PM_GPIO6 | default is GPIO | 103E | 60 | reg_gpio_en;reg[103E78]#3= 1b |  | reg[103E78]#2 | reg[103E78]#0 | reg[103E78]#1 | paddsh_pdas04dg_lpc_ss_1p8 | input, pull-up | input, pull-up | input, pull-up | No | No | PE=1, PS=1 PU=97kΩ (77~117kΩ) | PE=1, PS=0 PD=96kΩ (76~116kkΩ) | PAD= 0V PE=0, PS=0 (HIZ): I < +/- 1uA PE=1, PS=1: PU=97kΩ (77~117kΩ), I= 18.56uA (15.38~23.38uA) | PAD= 1.8V PE=0, PS=0 (HIZ): I < +/- 1uA PE=1, PS=0: PD=96kΩ (76~116kkΩ), I= 18.75uA(15.52~23.68uA) | Yes | 4mA |  |  | reg[003F22]#5 | 1 | reg[003F22]#4 |  | 1. not support fail-safe (不支援防倒灌) 2. not support PAD to C control | Level/Edge
61 | PAD_PM_GPIO5 | PAD_PM_GPIO5 | default is GPIO | 103E | 61 | reg_gpio_en;reg[103E7A]#3= 1b |  | reg[103E7A]#2 | reg[103E7A]#0 | reg[103E7A]#1 | paddsh_pdbs04dg_sar_lpc_ss_1p8 | input, Hiz | input, Hiz | input, Hiz | No | No | N/A | N/A | PAD= 0V <1uA | PAD= 1.8V <1uA | Yes | 4mA |  |  |  |  |  |  | 1. not support fail-safe (不支援防倒灌) 2. not support PAD to C control | Level/Edge
62 | PAD_PM_GPIO4 | PAD_PM_GPIO4 | default is GPIO | 103E | 62 | reg_gpio_en;reg[103E7C]#3= 1b |  | reg[103E7C]#2 | reg[103E7C]#0 | reg[103E7C]#1 | paddsh_pdbs04dg_sar_lpc_ss_1p8 | input, Hiz | input, Hiz | input, Hiz | No | No | N/A | N/A | PAD= 0V <1uA | PAD= 1.8V <1uA | Yes | 4mA |  |  |  |  |  |  | 1. not support fail-safe (不支援防倒灌) 2. not support PAD to C control | Level/Edge
63 | PAD_PM_UART2_TX | PAD_PM_UART2_TX | default is GPIO DBUS | 103E | 63 | reg_gpio_en;reg[103E7E]#3= 1b |  | reg[103E7E]#2 | reg[103E7E]#0 | reg[103E7E]#1 | paddsh_pdas16p2dg_lpc_ss_1p8 | input, pull-up | input, pull-up | input, pull-up | No | No | PE=1, PS=1 PU=97kΩ (77~117kΩ) | PE=1, PS=0 PD=96kΩ (76~116kkΩ) | PAD= 0V PE=0, PS=0 (HIZ): I < +/- 1uA PE=1, PS=1: PU=97kΩ (77~117kΩ), I= 18.56uA (15.38~23.38uA) | PAD= 1.8V PE=0, PS=0 (HIZ): I < +/- 1uA PE=1, PS=0: PD=96kΩ (76~116kkΩ), I= 18.75uA(15.52~23.68uA) | Yes | (00) = 4 mA (01) = 8 mA (10) = 12 mA (11) = 16 mA | 0:3d00003F28,bit7 1:3d00003F29,bit8 | 2'b0 | reg[003F28]#5 | 1 | reg[003F28]#4 |  | 1. not support fail-safe (不支援防倒灌) 2. not support PAD to C control | Level/Edge
64 | PAD_PM_UART2_RX | PAD_PM_UART2_RX | default is GPIO DBUS | 103E | 64 | reg_gpio_en;reg[103E80]#3= 1b |  | reg[103E80]#2 | reg[103E80]#0 | reg[103E80]#1 | paddsh_pdas16p2dg_lpc_ss_1p8 | input, pull-up | input, pull-up | input, pull-up | No | No | PE=1, PS=1 PU=97kΩ (77~117kΩ) | PE=1, PS=0 PD=96kΩ (76~116kkΩ) | PAD= 0V PE=0, PS=0 (HIZ): I < +/- 1uA PE=1, PS=1: PU=97kΩ (77~117kΩ), I= 18.56uA (15.38~23.38uA) | PAD= 1.8V PE=0, PS=0 (HIZ): I < +/- 1uA PE=1, PS=0: PD=96kΩ (76~116kkΩ), I= 18.75uA(15.52~23.68uA) | Yes | (00) = 4 mA (01) = 8 mA (10) = 12 mA (11) = 16 mA | 0:3d00003F2A,bit7 1:3d00003F2B,bit8 | 2'b0 | reg[003F2A]#5 | 1 | reg[003F2A]#4 |  | 1. not support fail-safe (不支援防倒灌) 2. not support PAD to C control | Level/Edge
65 | PAD_PM_I2C_CLK | PAD_PM_I2C_CLK | default is GPIO | 103E | 65 | reg_gpio_en;reg[103E82]#3= 1b |  | reg[103E82]#2 | reg[103E82]#0 | reg[103E82]#1 | paddsh_pdas16p2dg_lpc_ss_1p8 | input, pull-up | input, pull-up | input, pull-up | No | No | PE=1, PS=1 PU=97kΩ (77~117kΩ) | PE=1, PS=0 PD=96kΩ (76~116kkΩ) | PAD= 0V PE=0, PS=0 (HIZ): I < +/- 1uA PE=1, PS=1: PU=97kΩ (77~117kΩ), I= 18.56uA (15.38~23.38uA) | PAD= 1.8V PE=0, PS=0 (HIZ): I < +/- 1uA PE=1, PS=0: PD=96kΩ (76~116kkΩ), I= 18.75uA(15.52~23.68uA) | Yes | (00) = 4 mA (01) = 8 mA (10) = 12 mA (11) = 16 mA | 0:3d00003F2C,bit7 1:3d00003F2D,bit8 | 2'b0 | reg[003F2C]#5 | 1 | reg[003F2C]#4 |  | 1. not support fail-safe (不支援防倒灌) 2. not support PAD to C control | Level/Edge
66 | PAD_PM_I2C_SDA | PAD_PM_I2C_SDA | default is GPIO | 103E | 66 | reg_gpio_en;reg[103E84]#3= 1b |  | reg[103E84]#2 | reg[103E84]#0 | reg[103E84]#1 | paddsh_pdas16p2dg_lpc_ss_1p8 | input, pull-up | input, pull-up | input, pull-up | No | No | PE=1, PS=1 PU=97kΩ (77~117kΩ) | PE=1, PS=0 PD=96kΩ (76~116kkΩ) | PAD= 0V PE=0, PS=0 (HIZ): I < +/- 1uA PE=1, PS=1: PU=97kΩ (77~117kΩ), I= 18.56uA (15.38~23.38uA) | PAD= 1.8V PE=0, PS=0 (HIZ): I < +/- 1uA PE=1, PS=0: PD=96kΩ (76~116kkΩ), I= 18.75uA(15.52~23.68uA) | Yes | (00) = 4 mA (01) = 8 mA (10) = 12 mA (11) = 16 mA | 0:3d00003F2E,bit7 1:3d00003F2F,bit8 | 2'b0 | reg[003F2E]#5 | 1 | reg[003F2E]#4 |  | 1. not support fail-safe (不支援防倒灌) 2. not support PAD to C control | Level/Edge
67 | PAD_PM_SDIO_INT | PAD_PM_SDIO_INT | default is GPIO | 103E | 67 | reg_gpio_en;reg[103E86]#3= 1b |  | reg[103E86]#2 | reg[103E86]#0 | reg[103E86]#1 | paddsh_pdas16p2dg_lpc_ss_1p8 | input, pull-up | input, pull-up | input, pull-up | No | No | PE=1, PS=1 PU=97kΩ (77~117kΩ) | PE=1, PS=0 PD=96kΩ (76~116kkΩ) | PAD= 0V PE=0, PS=0 (HIZ): I < +/- 1uA PE=1, PS=1: PU=97kΩ (77~117kΩ), I= 18.56uA (15.38~23.38uA) | PAD= 1.8V PE=0, PS=0 (HIZ): I < +/- 1uA PE=1, PS=0: PD=96kΩ (76~116kkΩ), I= 18.75uA(15.52~23.68uA) | Yes | (00) = 4 mA (01) = 8 mA (10) = 12 mA (11) = 16 mA | 0:3d00003F30,bit7 1:3d00003F31,bit8 | 2'b0 | reg[003F30]#5 | 1 | reg[003F30]#4 |  | 1. not support fail-safe (不支援防倒灌) 2. not support PAD to C control | Level/Edge
68 | PAD_PM_GPIO3 | PAD_PM_GPIO3 | default is GPIO | 103E | 68 | reg_gpio_en;reg[103E88]#3= 1b |  | reg[103E88]#2 | reg[103E88]#0 | reg[103E88]#1 | paddv_pdas16p2dg_hsram_lpc_ss_1p8 | input, pull-up | input, pull-up | input, pull-up | No | No | PE=1, PS=1 PU=97kΩ (77~117kΩ) | PE=1, PS=0 PD=96kΩ (76~116kkΩ) | PAD= 0V PE=0, PS=0 (HIZ): I < +/- 1uA PE=1, PS=1: PU=97kΩ (77~117kΩ), I= 18.56uA (15.38~23.38uA) | PAD= 1.8V PE=0, PS=0 (HIZ): I < +/- 1uA PE=1, PS=0: PD=96kΩ (76~116kkΩ), I= 18.75uA(15.52~23.68uA) | Yes | (00) = 4 mA (01) = 8 mA (10) = 12 mA (11) = 16 mA | 0:3d00003F32,bit7 1:3d00003F33,bit8 | 2'b0 | reg[003F32]#5 | 1 | reg[003F32]#4 |  | Input: 60MHz@1.8V Output: 60MHz@1.8V@15pF 96MHz@1.8V@5pF | Level/Edge
69 | PAD_PM_GPIO2 | PAD_PM_GPIO2 | default is GPIO | 103E | 69 | reg_gpio_en;reg[103E8A]#3= 1b |  | reg[103E8A]#2 | reg[103E8A]#0 | reg[103E8A]#1 | paddv_pdas16p2dg_hsram_lpc_ss_1p8 | input, pull-up | input, pull-up | input, pull-up | No | No | PE=1, PS=1 PU=97kΩ (77~117kΩ) | PE=1, PS=0 PD=96kΩ (76~116kkΩ) | PAD= 0V PE=0, PS=0 (HIZ): I < +/- 1uA PE=1, PS=1: PU=97kΩ (77~117kΩ), I= 18.56uA (15.38~23.38uA) | PAD= 1.8V PE=0, PS=0 (HIZ): I < +/- 1uA PE=1, PS=0: PD=96kΩ (76~116kkΩ), I= 18.75uA(15.52~23.68uA) | Yes | (00) = 4 mA (01) = 8 mA (10) = 12 mA (11) = 16 mA | 0:3d00003F34,bit7 1:3d00003F35,bit8 | 2'b0 | reg[003F34]#5 | 1 | reg[003F34]#4 |  | Input: 60MHz@1.8V Output: 60MHz@1.8V@15pF 96MHz@1.8V@5pF | Level/Edge
70 | PAD_PM_GPIO1 | PAD_PM_GPIO1 | default is GPIO | 103E | 70 | reg_gpio_en;reg[103E8C]#3= 1b |  | reg[103E8C]#2 | reg[103E8C]#0 | reg[103E8C]#1 | paddv_pdas16p2dg_hsram_lpc_ss_1p8 | input, pull-up | input, pull-up | input, pull-up | No | No | PE=1, PS=1 PU=97kΩ (77~117kΩ) | PE=1, PS=0 PD=96kΩ (76~116kkΩ) | PAD= 0V PE=0, PS=0 (HIZ): I < +/- 1uA PE=1, PS=1: PU=97kΩ (77~117kΩ), I= 18.56uA (15.38~23.38uA) | PAD= 1.8V PE=0, PS=0 (HIZ): I < +/- 1uA PE=1, PS=0: PD=96kΩ (76~116kkΩ), I= 18.75uA(15.52~23.68uA) | Yes | (00) = 4 mA (01) = 8 mA (10) = 12 mA (11) = 16 mA | 0:3d00003F36,bit7 1:3d00003F37,bit8 | 2'b0 | reg[003F36]#5 | 1 | reg[003F36]#4 |  | Input: 60MHz@1.8V Output: 60MHz@1.8V@15pF 96MHz@1.8V@5pF | Level/Edge
71 | PAD_PM_GPIO0 | PAD_PM_GPIO0 | default is GPIO | 103E | 71 | reg_gpio_en;reg[103E8E]#3= 1b |  | reg[103E8E]#2 | reg[103E8E]#0 | reg[103E8E]#1 | paddv_pdas16p2dg_hsram_lpc_ss_1p8 | input, pull-up | input, pull-up | input, pull-up | No | No | PE=1, PS=1 PU=97kΩ (77~117kΩ) | PE=1, PS=0 PD=96kΩ (76~116kkΩ) | PAD= 0V PE=0, PS=0 (HIZ): I < +/- 1uA PE=1, PS=1: PU=97kΩ (77~117kΩ), I= 18.56uA (15.38~23.38uA) | PAD= 1.8V PE=0, PS=0 (HIZ): I < +/- 1uA PE=1, PS=0: PD=96kΩ (76~116kkΩ), I= 18.75uA(15.52~23.68uA) | Yes | (00) = 4 mA (01) = 8 mA (10) = 12 mA (11) = 16 mA | 0:3d00003F38,bit7 1:3d00003F39,bit8 | 2'b0 | reg[003F38]#5 | 1 | reg[003F38]#4 |  | Input: 60MHz@1.8V Output: 60MHz@1.8V@15pF 96MHz@1.8V@5pF | Level/Edge
72 | PAD_PM_SDIO_D1 | PAD_PM_SDIO_D1 | default is GPIO | 103E | 72 | reg_gpio_en;reg[103E90]#3= 1b |  | reg[103E90]#2 | reg[103E90]#0 | reg[103E90]#1 | paddv_pdas16p2dg_hsram_lpc_ss_1p8 | input, pull-up | input, pull-up | input, pull-up | No | No | PE=1, PS=1 PU=97kΩ (77~117kΩ) | PE=1, PS=0 PD=96kΩ (76~116kkΩ) | PAD= 0V PE=0, PS=0 (HIZ): I < +/- 1uA PE=1, PS=1: PU=97kΩ (77~117kΩ), I= 18.56uA (15.38~23.38uA) | PAD= 1.8V PE=0, PS=0 (HIZ): I < +/- 1uA PE=1, PS=0: PD=96kΩ (76~116kkΩ), I= 18.75uA(15.52~23.68uA) | Yes | (00) = 4 mA (01) = 8 mA (10) = 12 mA (11) = 16 mA | 0:3d00003F3A,bit7 1:3d00003F3B,bit8 | 2'b0 | reg[003F3A]#5 | 1 | reg[003F3A]#4 |  | Input: 60MHz@1.8V Output: 60MHz@1.8V@15pF 96MHz@1.8V@5pF | Level/Edge
73 | PAD_PM_SDIO_D0 | PAD_PM_SDIO_D0 | default is GPIO | 103E | 73 | reg_gpio_en;reg[103E92]#3= 1b |  | reg[103E92]#2 | reg[103E92]#0 | reg[103E92]#1 | paddv_pdas16p2dg_hsram_lpc_ss_1p8 | input, pull-up | input, pull-up | input, pull-up | No | No | PE=1, PS=1 PU=97kΩ (77~117kΩ) | PE=1, PS=0 PD=96kΩ (76~116kkΩ) | PAD= 0V PE=0, PS=0 (HIZ): I < +/- 1uA PE=1, PS=1: PU=97kΩ (77~117kΩ), I= 18.56uA (15.38~23.38uA) | PAD= 1.8V PE=0, PS=0 (HIZ): I < +/- 1uA PE=1, PS=0: PD=96kΩ (76~116kkΩ), I= 18.75uA(15.52~23.68uA) | Yes | (00) = 4 mA (01) = 8 mA (10) = 12 mA (11) = 16 mA | 0:3d00003F3C,bit7 1:3d00003F3D,bit8 | 2'b0 | reg[003F3C]#5 | 1 | reg[003F3C]#4 |  | Input: 60MHz@1.8V Output: 60MHz@1.8V@15pF 96MHz@1.8V@5pF | Level/Edge
74 | PAD_PM_SDIO_CLK | PAD_PM_SDIO_CLK | default is GPIO | 103E | 74 | reg_gpio_en;reg[103E94]#3= 1b |  | reg[103E94]#2 | reg[103E94]#0 | reg[103E94]#1 | paddv_pdas16p2dg_hsram_lpc_ss_1p8 | input, pull-down | input, pull-down | input, pull-down | No | No | PE=1, PS=1 PU=97kΩ (77~117kΩ) | PE=1, PS=0 PD=96kΩ (76~116kkΩ) | PAD= 0V PE=0, PS=0 (HIZ): I < +/- 1uA PE=1, PS=1: PU=97kΩ (77~117kΩ), I= 18.56uA (15.38~23.38uA) | PAD= 1.8V PE=0, PS=0 (HIZ): I < +/- 1uA PE=1, PS=0: PD=96kΩ (76~116kkΩ), I= 18.75uA(15.52~23.68uA) | Yes | (00) = 4 mA (01) = 8 mA (10) = 12 mA (11) = 16 mA | 0:3d00003F3E,bit7 1:3d00003F3F,bit8 | 2'b0 | reg[003F3E]#5 | 0 | reg[003F3E]#4 |  | Input: 60MHz@1.8V Output: 60MHz@1.8V@15pF 96MHz@1.8V@5pF | Level/Edge
75 | PAD_PM_SDIO_CMD | PAD_PM_SDIO_CMD | default is GPIO | 103E | 75 | reg_gpio_en;reg[103E96]#3= 1b |  | reg[103E96]#2 | reg[103E96]#0 | reg[103E96]#1 | paddv_pdas16p2dg_hsram_lpc_ss_1p8 | input, pull-up | input, pull-up | input, pull-up | No | No | PE=1, PS=1 PU=97kΩ (77~117kΩ) | PE=1, PS=0 PD=96kΩ (76~116kkΩ) | PAD= 0V PE=0, PS=0 (HIZ): I < +/- 1uA PE=1, PS=1: PU=97kΩ (77~117kΩ), I= 18.56uA (15.38~23.38uA) | PAD= 1.8V PE=0, PS=0 (HIZ): I < +/- 1uA PE=1, PS=0: PD=96kΩ (76~116kkΩ), I= 18.75uA(15.52~23.68uA) | Yes | (00) = 4 mA (01) = 8 mA (10) = 12 mA (11) = 16 mA | 0:3d00003F40,bit7 1:3d00003F41,bit8 | 2'b0 | reg[003F40]#5 | 1 | reg[003F40]#4 |  | Input: 60MHz@1.8V Output: 60MHz@1.8V@15pF 96MHz@1.8V@5pF | Level/Edge
76 | PAD_PM_SDIO_D3 | PAD_PM_SDIO_D3 | default is GPIO | 103E | 76 | reg_gpio_en;reg[103E98]#3= 1b |  | reg[103E98]#2 | reg[103E98]#0 | reg[103E98]#1 | paddv_pdas16p2dg_hsram_lpc_ss_1p8 | input, pull-up | input, pull-up | input, pull-up | No | No | PE=1, PS=1 PU=97kΩ (77~117kΩ) | PE=1, PS=0 PD=96kΩ (76~116kkΩ) | PAD= 0V PE=0, PS=0 (HIZ): I < +/- 1uA PE=1, PS=1: PU=97kΩ (77~117kΩ), I= 18.56uA (15.38~23.38uA) | PAD= 1.8V PE=0, PS=0 (HIZ): I < +/- 1uA PE=1, PS=0: PD=96kΩ (76~116kkΩ), I= 18.75uA(15.52~23.68uA) | Yes | (00) = 4 mA (01) = 8 mA (10) = 12 mA (11) = 16 mA | 0:3d00003F42,bit7 1:3d00003F43,bit8 | 2'b0 | reg[003F42]#5 | 1 | reg[003F42]#4 |  | Input: 60MHz@1.8V Output: 60MHz@1.8V@15pF 96MHz@1.8V@5pF | Level/Edge
77 | PAD_PM_SDIO_D2 | PAD_PM_SDIO_D2 | default is GPIO | 103E | 77 | reg_gpio_en;reg[103E9A]#3= 1b |  | reg[103E9A]#2 | reg[103E9A]#0 | reg[103E9A]#1 | paddv_pdas16p2dg_hsram_lpc_ss_1p8 | input, pull-up | input, pull-up | input, pull-up | No | No | PE=1, PS=1 PU=97kΩ (77~117kΩ) | PE=1, PS=0 PD=96kΩ (76~116kkΩ) | PAD= 0V PE=0, PS=0 (HIZ): I < +/- 1uA PE=1, PS=1: PU=97kΩ (77~117kΩ), I= 18.56uA (15.38~23.38uA) | PAD= 1.8V PE=0, PS=0 (HIZ): I < +/- 1uA PE=1, PS=0: PD=96kΩ (76~116kkΩ), I= 18.75uA(15.52~23.68uA) | Yes | (00) = 4 mA (01) = 8 mA (10) = 12 mA (11) = 16 mA | 0:3d00003F44,bit7 1:3d00003F45,bit8 | 2'b0 | reg[003F44]#5 | 1 | reg[003F44]#4 |  | Input: 60MHz@1.8V Output: 60MHz@1.8V@15pF 96MHz@1.8V@5pF | Level/Edge
80 | PAD_PM_FUART_RX | PAD_PM_FUART_RX | default is GPIO | 103E | 80 | reg_gpio_en;reg[103EA0]#3= 1b |  | reg[103EA0]#2 | reg[103EA0]#0 | reg[103EA0]#1 | paddv_pdas16p2dg_hsram_lpc_ss_1p8 | input, pull-up | input, pull-up | input, pull-up | No | No | PE=1, PS=1 PU=97kΩ (77~117kΩ) | PE=1, PS=0 PD=96kΩ (76~116kkΩ) | PAD= 0V PE=0, PS=0 (HIZ): I < +/- 1uA PE=1, PS=1: PU=97kΩ (77~117kΩ), I= 18.56uA (15.38~23.38uA) | PAD= 1.8V PE=0, PS=0 (HIZ): I < +/- 1uA PE=1, PS=0: PD=96kΩ (76~116kkΩ), I= 18.75uA(15.52~23.68uA) | Yes | (00) = 4 mA (01) = 8 mA (10) = 12 mA (11) = 16 mA | 0:3d00003F4A,bit7 1:3d00003F4B,bit8 | 2'b0 | reg[003F4A]#5 | 1 | reg[003F4A]#4 |  | Input: 60MHz@1.8V Output: 60MHz@1.8V@15pF 96MHz@1.8V@5pF | Level/Edge
81 | PAD_PM_FUART_TX | PAD_PM_FUART_TX | default is GPIO | 103E | 81 | reg_gpio_en;reg[103EA2]#3= 1b |  | reg[103EA2]#2 | reg[103EA2]#0 | reg[103EA2]#1 | paddv_pdas16p2dg_hsram_lpc_ss_1p8 | input, pull-up | input, pull-up | input, pull-up | No | No | PE=1, PS=1 PU=97kΩ (77~117kΩ) | PE=1, PS=0 PD=96kΩ (76~116kkΩ) | PAD= 0V PE=0, PS=0 (HIZ): I < +/- 1uA PE=1, PS=1: PU=97kΩ (77~117kΩ), I= 18.56uA (15.38~23.38uA) | PAD= 1.8V PE=0, PS=0 (HIZ): I < +/- 1uA PE=1, PS=0: PD=96kΩ (76~116kkΩ), I= 18.75uA(15.52~23.68uA) | Yes | (00) = 4 mA (01) = 8 mA (10) = 12 mA (11) = 16 mA | 0:3d00003F4C,bit7 1:3d00003F4D,bit8 | 2'b0 | reg[003F4C]#5 | 1 | reg[003F4C]#4 |  | Input: 60MHz@1.8V Output: 60MHz@1.8V@15pF 96MHz@1.8V@5pF | Level/Edge
95 | PAD_OUTN_RX0_CH[5] | PAD_OUTN_RX0_CH[5] | default is GPIO | 103E | 95 | reg_gpio_en;reg[103EBE]#3= 1b |  | reg[103EBE]#2 | reg[103EBE]#0 | reg[103EBE]#1 | paddsh_pdas16p2dg_1p8 | input, pull-down | input, pull-down | input, pull-down | No | No | PE=1, PS=1 PU=97kΩ (77~117kΩ) | PE=1, PS=0 PD=96kΩ (76~116kkΩ) | PAD= 0V PE=0, PS=0 (HIZ): I < +/- 1uA PE=1, PS=1: PU=97kΩ (77~117kΩ), I= 18.56uA (15.38~23.38uA) | PAD= 1.8V PE=0, PS=0 (HIZ): I < +/- 1uA PE=1, PS=0: PD=96kΩ (76~116kkΩ), I= 18.75uA(15.52~23.68uA) | Yes | (00) = 4 mA (01) = 8 mA (10) = 12 mA (11) = 16 mA | 0:4d00153FE6,bit11 | 2'b0 | reg[153FE4]#11 | 0 | reg[153FE2]#11 |  | 1. not support fail-safe (不支援防倒灌) 2. not support PAD to C control | Level/Edge
96 | PAD_OUTP_RX0_CH[5] | PAD_OUTP_RX0_CH[5] | default is GPIO | 103E | 96 | reg_gpio_en;reg[103EC0]#3= 1b |  | reg[103EC0]#2 | reg[103EC0]#0 | reg[103EC0]#1 | paddsh_pdas16p2dg_1p8 | input, pull-down | input, pull-down | input, pull-down | No | No | PE=1, PS=1 PU=97kΩ (77~117kΩ) | PE=1, PS=0 PD=96kΩ (76~116kkΩ) | PAD= 0V PE=0, PS=0 (HIZ): I < +/- 1uA PE=1, PS=1: PU=97kΩ (77~117kΩ), I= 18.56uA (15.38~23.38uA) | PAD= 1.8V PE=0, PS=0 (HIZ): I < +/- 1uA PE=1, PS=0: PD=96kΩ (76~116kkΩ), I= 18.75uA(15.52~23.68uA) | Yes | (00) = 4 mA (01) = 8 mA (10) = 12 mA (11) = 16 mA | 0:4d00153FE6,bit10 | 2'b0 | reg[153FE4]#10 | 0 | reg[153FE2]#10 |  | 1. not support fail-safe (不支援防倒灌) 2. not support PAD to C control | Level/Edge
97 | PAD_OUTN_RX0_CH[4] | PAD_OUTN_RX0_CH[4] | default is GPIO | 103E | 97 | reg_gpio_en;reg[103EC2]#3= 1b |  | reg[103EC2]#2 | reg[103EC2]#0 | reg[103EC2]#1 | paddsh_pdas16p2dg_1p8 | input, pull-down | input, pull-down | input, pull-down | No | No | PE=1, PS=1 PU=97kΩ (77~117kΩ) | PE=1, PS=0 PD=96kΩ (76~116kkΩ) | PAD= 0V PE=0, PS=0 (HIZ): I < +/- 1uA PE=1, PS=1: PU=97kΩ (77~117kΩ), I= 18.56uA (15.38~23.38uA) | PAD= 1.8V PE=0, PS=0 (HIZ): I < +/- 1uA PE=1, PS=0: PD=96kΩ (76~116kkΩ), I= 18.75uA(15.52~23.68uA) | Yes | (00) = 4 mA (01) = 8 mA (10) = 12 mA (11) = 16 mA | 0:4d00153FE6,bit9 | 2'b0 | reg[153FE4]#9 | 0 | reg[153FE2]#9 |  | 1. not support fail-safe (不支援防倒灌) 2. not support PAD to C control | Level/Edge
98 | PAD_OUTP_RX0_CH[4] | PAD_OUTP_RX0_CH[4] | default is GPIO | 103E | 98 | reg_gpio_en;reg[103EC4]#3= 1b |  | reg[103EC4]#2 | reg[103EC4]#0 | reg[103EC4]#1 | paddsh_pdas16p2dg_1p8 | input, pull-down | input, pull-down | input, pull-down | No | No | PE=1, PS=1 PU=97kΩ (77~117kΩ) | PE=1, PS=0 PD=96kΩ (76~116kkΩ) | PAD= 0V PE=0, PS=0 (HIZ): I < +/- 1uA PE=1, PS=1: PU=97kΩ (77~117kΩ), I= 18.56uA (15.38~23.38uA) | PAD= 1.8V PE=0, PS=0 (HIZ): I < +/- 1uA PE=1, PS=0: PD=96kΩ (76~116kkΩ), I= 18.75uA(15.52~23.68uA) | Yes | (00) = 4 mA (01) = 8 mA (10) = 12 mA (11) = 16 mA | 0:4d00153FE6,bit8 | 2'b0 | reg[153FE4]#8 | 0 | reg[153FE2]#8 |  | 1. not support fail-safe (不支援防倒灌) 2. not support PAD to C control | Level/Edge
99 | PAD_OUTN_RX0_CH[3] | PAD_OUTN_RX0_CH[3] | default is GPIO | 103E | 99 | reg_gpio_en;reg[103EC6]#3= 1b |  | reg[103EC6]#2 | reg[103EC6]#0 | reg[103EC6]#1 | paddsh_pdas16p2dg_1p8 | input, pull-down | input, pull-down | input, pull-down | No | No | PE=1, PS=1 PU=97kΩ (77~117kΩ) | PE=1, PS=0 PD=96kΩ (76~116kkΩ) | PAD= 0V PE=0, PS=0 (HIZ): I < +/- 1uA PE=1, PS=1: PU=97kΩ (77~117kΩ), I= 18.56uA (15.38~23.38uA) | PAD= 1.8V PE=0, PS=0 (HIZ): I < +/- 1uA PE=1, PS=0: PD=96kΩ (76~116kkΩ), I= 18.75uA(15.52~23.68uA) | Yes | (00) = 4 mA (01) = 8 mA (10) = 12 mA (11) = 16 mA | 0:4d00153FE6,bit7 | 2'b0 | reg[153FE4]#7 | 0 | reg[153FE2]#7 |  | 1. not support fail-safe (不支援防倒灌) 2. not support PAD to C control | Level/Edge
100 | PAD_OUTP_RX0_CH[3] | PAD_OUTP_RX0_CH[3] | default is GPIO | 103E | 100 | reg_gpio_en;reg[103EC8]#3= 1b |  | reg[103EC8]#2 | reg[103EC8]#0 | reg[103EC8]#1 | paddsh_pdas16p2dg_1p8 | input, pull-down | input, pull-down | input, pull-down | No | No | PE=1, PS=1 PU=97kΩ (77~117kΩ) | PE=1, PS=0 PD=96kΩ (76~116kkΩ) | PAD= 0V PE=0, PS=0 (HIZ): I < +/- 1uA PE=1, PS=1: PU=97kΩ (77~117kΩ), I= 18.56uA (15.38~23.38uA) | PAD= 1.8V PE=0, PS=0 (HIZ): I < +/- 1uA PE=1, PS=0: PD=96kΩ (76~116kkΩ), I= 18.75uA(15.52~23.68uA) | Yes | (00) = 4 mA (01) = 8 mA (10) = 12 mA (11) = 16 mA | 0:4d00153FE6,bit6 | 2'b0 | reg[153FE4]#6 | 0 | reg[153FE2]#6 |  | 1. not support fail-safe (不支援防倒灌) 2. not support PAD to C control | Level/Edge
101 | PAD_OUTN_RX0_CH[2] | PAD_OUTN_RX0_CH[2] | default is GPIO | 103E | 101 | reg_gpio_en;reg[103ECA]#3= 1b |  | reg[103ECA]#2 | reg[103ECA]#0 | reg[103ECA]#1 | paddsh_pdas16p2dg_1p8 | input, pull-down | input, pull-down | input, pull-down | No | No | PE=1, PS=1 PU=97kΩ (77~117kΩ) | PE=1, PS=0 PD=96kΩ (76~116kkΩ) | PAD= 0V PE=0, PS=0 (HIZ): I < +/- 1uA PE=1, PS=1: PU=97kΩ (77~117kΩ), I= 18.56uA (15.38~23.38uA) | PAD= 1.8V PE=0, PS=0 (HIZ): I < +/- 1uA PE=1, PS=0: PD=96kΩ (76~116kkΩ), I= 18.75uA(15.52~23.68uA) | Yes | (00) = 4 mA (01) = 8 mA (10) = 12 mA (11) = 16 mA | 0:4d00153FE6,bit5 | 2'b0 | reg[153FE4]#5 | 0 | reg[153FE2]#5 |  | 1. not support fail-safe (不支援防倒灌) 2. not support PAD to C control | Level/Edge
102 | PAD_OUTP_RX0_CH[2] | PAD_OUTP_RX0_CH[2] | default is GPIO | 103E | 102 | reg_gpio_en;reg[103ECC]#3= 1b |  | reg[103ECC]#2 | reg[103ECC]#0 | reg[103ECC]#1 | paddsh_pdas16p2dg_1p8 | input, pull-down | input, pull-down | input, pull-down | No | No | PE=1, PS=1 PU=97kΩ (77~117kΩ) | PE=1, PS=0 PD=96kΩ (76~116kkΩ) | PAD= 0V PE=0, PS=0 (HIZ): I < +/- 1uA PE=1, PS=1: PU=97kΩ (77~117kΩ), I= 18.56uA (15.38~23.38uA) | PAD= 1.8V PE=0, PS=0 (HIZ): I < +/- 1uA PE=1, PS=0: PD=96kΩ (76~116kkΩ), I= 18.75uA(15.52~23.68uA) | Yes | (00) = 4 mA (01) = 8 mA (10) = 12 mA (11) = 16 mA | 0:4d00153FE6,bit4 | 2'b0 | reg[153FE4]#4 | 0 | reg[153FE2]#4 |  | 1. not support fail-safe (不支援防倒灌) 2. not support PAD to C control | Level/Edge
103 | PAD_OUTN_RX0_CH[1] | PAD_OUTN_RX0_CH[1] | default is GPIO | 103E | 103 | reg_gpio_en;reg[103ECE]#3= 1b |  | reg[103ECE]#2 | reg[103ECE]#0 | reg[103ECE]#1 | paddsh_pdas16p2dg_1p8 | input, pull-down | input, pull-down | input, pull-down | No | No | PE=1, PS=1 PU=97kΩ (77~117kΩ) | PE=1, PS=0 PD=96kΩ (76~116kkΩ) | PAD= 0V PE=0, PS=0 (HIZ): I < +/- 1uA PE=1, PS=1: PU=97kΩ (77~117kΩ), I= 18.56uA (15.38~23.38uA) | PAD= 1.8V PE=0, PS=0 (HIZ): I < +/- 1uA PE=1, PS=0: PD=96kΩ (76~116kkΩ), I= 18.75uA(15.52~23.68uA) | Yes | (00) = 4 mA (01) = 8 mA (10) = 12 mA (11) = 16 mA | 0:4d00153FE6,bit3 | 2'b0 | reg[153FE4]#3 | 0 | reg[153FE2]#3 |  | 1. not support fail-safe (不支援防倒灌) 2. not support PAD to C control | Level/Edge
104 | PAD_OUTP_RX0_CH[1] | PAD_OUTP_RX0_CH[1] | default is GPIO | 103E | 104 | reg_gpio_en;reg[103ED0]#3= 1b |  | reg[103ED0]#2 | reg[103ED0]#0 | reg[103ED0]#1 | paddsh_pdas16p2dg_1p8 | input, pull-down | input, pull-down | input, pull-down | No | No | PE=1, PS=1 PU=97kΩ (77~117kΩ) | PE=1, PS=0 PD=96kΩ (76~116kkΩ) | PAD= 0V PE=0, PS=0 (HIZ): I < +/- 1uA PE=1, PS=1: PU=97kΩ (77~117kΩ), I= 18.56uA (15.38~23.38uA) | PAD= 1.8V PE=0, PS=0 (HIZ): I < +/- 1uA PE=1, PS=0: PD=96kΩ (76~116kkΩ), I= 18.75uA(15.52~23.68uA) | Yes | (00) = 4 mA (01) = 8 mA (10) = 12 mA (11) = 16 mA | 0:4d00153FE6,bit2 | 2'b0 | reg[153FE4]#2 | 0 | reg[153FE2]#2 |  | 1. not support fail-safe (不支援防倒灌) 2. not support PAD to C control | Level/Edge
105 | PAD_OUTN_RX0_CH[0] | PAD_OUTN_RX0_CH[0] | default is GPIO | 103E | 105 | reg_gpio_en;reg[103ED2]#3= 1b |  | reg[103ED2]#2 | reg[103ED2]#0 | reg[103ED2]#1 | paddsh_pdas16p2dg_1p8 | input, pull-down | input, pull-down | input, pull-down | No | No | PE=1, PS=1 PU=97kΩ (77~117kΩ) | PE=1, PS=0 PD=96kΩ (76~116kkΩ) | PAD= 0V PE=0, PS=0 (HIZ): I < +/- 1uA PE=1, PS=1: PU=97kΩ (77~117kΩ), I= 18.56uA (15.38~23.38uA) | PAD= 1.8V PE=0, PS=0 (HIZ): I < +/- 1uA PE=1, PS=0: PD=96kΩ (76~116kkΩ), I= 18.75uA(15.52~23.68uA) | Yes | (00) = 4 mA (01) = 8 mA (10) = 12 mA (11) = 16 mA | 0:4d00153FE6,bit1 | 2'b0 | reg[153FE4]#1 | 0 | reg[153FE2]#1 |  | 1. not support fail-safe (不支援防倒灌) 2. not support PAD to C control | Level/Edge
106 | PAD_OUTP_RX0_CH[0] | PAD_OUTP_RX0_CH[0] | default is GPIO | 103E | 106 | reg_gpio_en;reg[103ED4]#3= 1b |  | reg[103ED4]#2 | reg[103ED4]#0 | reg[103ED4]#1 | paddsh_pdas16p2dg_1p8 | input, pull-down | input, pull-down | input, pull-down | No | No | PE=1, PS=1 PU=97kΩ (77~117kΩ) | PE=1, PS=0 PD=96kΩ (76~116kkΩ) | PAD= 0V PE=0, PS=0 (HIZ): I < +/- 1uA PE=1, PS=1: PU=97kΩ (77~117kΩ), I= 18.56uA (15.38~23.38uA) | PAD= 1.8V PE=0, PS=0 (HIZ): I < +/- 1uA PE=1, PS=0: PD=96kΩ (76~116kkΩ), I= 18.75uA(15.52~23.68uA) | Yes | (00) = 4 mA (01) = 8 mA (10) = 12 mA (11) = 16 mA | 0:4d00153FE6,bit0 | 2'b0 | reg[153FE4]#0 | 0 | reg[153FE2]#0 |  | 1. not support fail-safe (不支援防倒灌) 2. not support PAD to C control | Level/Edge
PM PAD GPIO also can config/read from PM domain
1 | PAD_PM_GPIO11 | PAD_PM_GPIO11 | default is GPIO | 003F | 1 | reg_gpio_en;reg[003F02]#3= 1b |  | reg[003F02]#2 | reg[003F02]#0 | reg[003F02]#1 | paddsh_pdas16p2dg_ie_lpc_ss | input, pull-up | input, pull-up | input, pull-up | No | No | 1.8V mode PE=1, PS=1: PU=42kΩ (34~50kΩ) 3.3V mode PE=1, PS=1: PU=43kΩ (35~51kΩ) | 1.8V mode PE=1, PS=0: PD=42kΩ (34~50kΩ) 3.3V mode PE=1, PS=0: PD=43kΩ (35~51kΩ) | 1.8V mode: PAD= 0V PE=0, PS=0 (HIZ): I < +/- 1uA PE=1, PS=1 (PU)=42kΩ (34~50kΩ), I= 42.85uA (36.00~52.94uA) 3.3V mode: PAD= 0V PE=0, PS=0 (HIZ): I < +/- 1uA PE=1, PS=1 (PU)=43kΩ (35~51kΩ), I= 76.74uA (64.70~94.59uA) | 1.8V mode: PAD= 1.8V PE=0, PS=0 (HIZ): I < +/- 1uA PE=1, PS=0 (PD)=42kΩ (34~50kΩ), I= 42.85A (36.00~52.94uA) 3.3V mode: PAD= 3.3V PE=0, PS=0 (HIZ): I < +/- 1uA PE=1, PS=0 (PD)=43kΩ (35~51kΩ), I= 76.70uA (64.70~94.59uA) | Yes | (00) = 4 mA (01) = 8 mA (10) = 12 mA (11) = 16 mA | 0:3d00003F02,bit7 1:3d00003F03,bit8 | 2'b0 | reg[003F02]#5 | 1 | reg[003F02]#4 | reg[003F02]#6 | 1. not support fail-safe (不支援防倒灌) 2. support PAD to C control | Level/Edge
2 | PAD_PM_UART_TX | PAD_PM_UART_TX | default is NOT GPIO DBUS | 003F | 2 | reg_gpio_en;reg[003F04]#3= 1b | reg_uart_en disable;reg[003FCA]#4=1b, | reg[003F04]#2 | reg[003F04]#0 | reg[003F04]#1 | paddsh_pdas16p2dg_ie_lpc_ss | input, pull-up | input, pull-up | input, pull-up | No | No | 1.8V mode PE=1, PS=1: PU=42kΩ (34~50kΩ) 3.3V mode PE=1, PS=1: PU=43kΩ (35~51kΩ) | 1.8V mode PE=1, PS=0: PD=42kΩ (34~50kΩ) 3.3V mode PE=1, PS=0: PD=43kΩ (35~51kΩ) | 1.8V mode: PAD= 0V PE=0, PS=0 (HIZ): I < +/- 1uA PE=1, PS=1 (PU)=42kΩ (34~50kΩ), I= 42.85uA (36.00~52.94uA) 3.3V mode: PAD= 0V PE=0, PS=0 (HIZ): I < +/- 1uA PE=1, PS=1 (PU)=43kΩ (35~51kΩ), I= 76.74uA (64.70~94.59uA) | 1.8V mode: PAD= 1.8V PE=0, PS=0 (HIZ): I < +/- 1uA PE=1, PS=0 (PD)=42kΩ (34~50kΩ), I= 42.85A (36.00~52.94uA) 3.3V mode: PAD= 3.3V PE=0, PS=0 (HIZ): I < +/- 1uA PE=1, PS=0 (PD)=43kΩ (35~51kΩ), I= 76.70uA (64.70~94.59uA) | Yes | (00) = 4 mA (01) = 8 mA (10) = 12 mA (11) = 16 mA | 0:3d00003F04,bit7 1:3d00003F05,bit8 | 2'b0 | reg[003F04]#5 | 1 | reg[003F04]#4 | reg[003F04]#6 | 1. not support fail-safe (不支援防倒灌) 2. support PAD to C control | Level/Edge
3 | PAD_PM_UART_RX | PAD_PM_UART_RX | default is NOT GPIO DBUS | 003F | 3 | reg_gpio_en;reg[003F06]#3= 1b | reg_uart_en disable;reg[003FCA]#4=1b, | reg[003F06]#2 | reg[003F06]#0 | reg[003F06]#1 | paddsh_pdas16p2dg_ie_lpc_ss | input, pull-up | input, pull-up | input, pull-up | No | No | 1.8V mode PE=1, PS=1: PU=42kΩ (34~50kΩ) 3.3V mode PE=1, PS=1: PU=43kΩ (35~51kΩ) | 1.8V mode PE=1, PS=0: PD=42kΩ (34~50kΩ) 3.3V mode PE=1, PS=0: PD=43kΩ (35~51kΩ) | 1.8V mode: PAD= 0V PE=0, PS=0 (HIZ): I < +/- 1uA PE=1, PS=1 (PU)=42kΩ (34~50kΩ), I= 42.85uA (36.00~52.94uA) 3.3V mode: PAD= 0V PE=0, PS=0 (HIZ): I < +/- 1uA PE=1, PS=1 (PU)=43kΩ (35~51kΩ), I= 76.74uA (64.70~94.59uA) | 1.8V mode: PAD= 1.8V PE=0, PS=0 (HIZ): I < +/- 1uA PE=1, PS=0 (PD)=42kΩ (34~50kΩ), I= 42.85A (36.00~52.94uA) 3.3V mode: PAD= 3.3V PE=0, PS=0 (HIZ): I < +/- 1uA PE=1, PS=0 (PD)=43kΩ (35~51kΩ), I= 76.70uA (64.70~94.59uA) | Yes | (00) = 4 mA (01) = 8 mA (10) = 12 mA (11) = 16 mA | 0:3d00003F06,bit7 1:3d00003F07,bit8 | 2'b0 | reg[003F06]#5 | 1 | reg[003F06]#4 | reg[003F06]#6 | 1. not support fail-safe (不支援防倒灌) 2. support PAD to C control | Level/Edge

Sheet: MIPI_RX_VIF
Pin Num | PAD_Name | reg_sr0_mipi_mode | reg_sr0_mipi_mode | reg_sr0_mipi_mode | reg_sr0_mipi_mode | reg_sr0_mipi_mode
 |  | 1 | 2 | 3 | 4 | 5
A3 | PAD_OUTP_RX0_CH[0] | MIPI_D2P | MIPI00_D1P |  |  | MIPI00_D1P
C4 | PAD_OUTN_RX0_CH[0] | MIPI_D2N | MIPI00_D1N |  |  | MIPI00_D1N
A2 | PAD_OUTP_RX0_CH[1] | MIPI_D0P | MIPI00_D0P |  | MIPI_D0P | MIPI00_D0P
B3 | PAD_OUTN_RX0_CH[1] | MIPI_D0N | MIPI00_D0N |  | MIPI_D0N | MIPI00_D0N
B2 | PAD_OUTP_RX0_CH[2] | MIPI_CKP | MIPI00_CKP |  | MIPI_CKP | MIPI00_CKP
C3 | PAD_OUTN_RX0_CH[2] | MIPI_CKN | MIPI00_CKN |  | MIPI_CKN | MIPI00_CKN
C2 | PAD_OUTP_RX0_CH[3] | MIPI_D1P |  | MIPI01_D1P | MIPI_D1P | MIPI01_D1P
B1 | PAD_OUTN_RX0_CH[3] | MIPI_D1N |  | MIPI01_D1N | MIPI_D1N | MIPI01_D1N
D2 | PAD_OUTP_RX0_CH[4] | MIPI_D3P |  | MIPI01_D0P |  | MIPI01_D0P
C1 | PAD_OUTN_RX0_CH[4] | MIPI_D3N |  | MIPI01_D0N |  | MIPI01_D0N
D3 | PAD_OUTP_RX0_CH[5] |  |  | MIPI01_CKP |  | MIPI01_CKP
D1 | PAD_OUTN_RX0_CH[5] |  |  | MIPI01_CKN |  | MIPI01_CKN
1 | PAD_SR_MCLK0 | MIPI00_MCLK
2 | PAD_SR_RST0 | MIPI00_RST
6 | PAD_SR_MCLK1 | MIPI01_MCLK
7 | PAD_SR_RST1 | MIPI01_RST

Sheet: Chip_Config
Boot Information (ROM - Boot Mode Selection)
otp_boot_source_enable = 0 (HW boot strapping mode) (@140) |  |  |  |  | ROM Boot Storage Selection | 1st Upgrade Path | 2nd Upgrade Path
ROM boot up Path | PAD_SPI0_DI | PAD_SPI0_HLD | PAD_SPI0_DO | PAD_SPI0_CLK
 | M[3] | M[2] | M[1] | M[0]
(default) | 1 | 1 | 1 | 0
Storage Mode (SD Boot first) (or Skip SD) | 1 | 1 | 0 | 0 | SPI NAND Flash (w/ embedded ECC) | SD Card (SD0) | PC/USB
 |  |  | 0 | 1 | Skip SD Card, run SPI NAND Flash | (none) | PC/USB
 |  |  | 1 | 0 | SPI NOR Flash | SD Card (SD0) | PC/USB
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
