HuaqiuOpenHardware/Comake-Pi-D2/hardware/pcb/Comake-Pi-D2-V2.0_BGA8_9.5_Demo_20260409/extracted/SSC309-S01D-AI-Mainboard_20260228.pdf

5

4

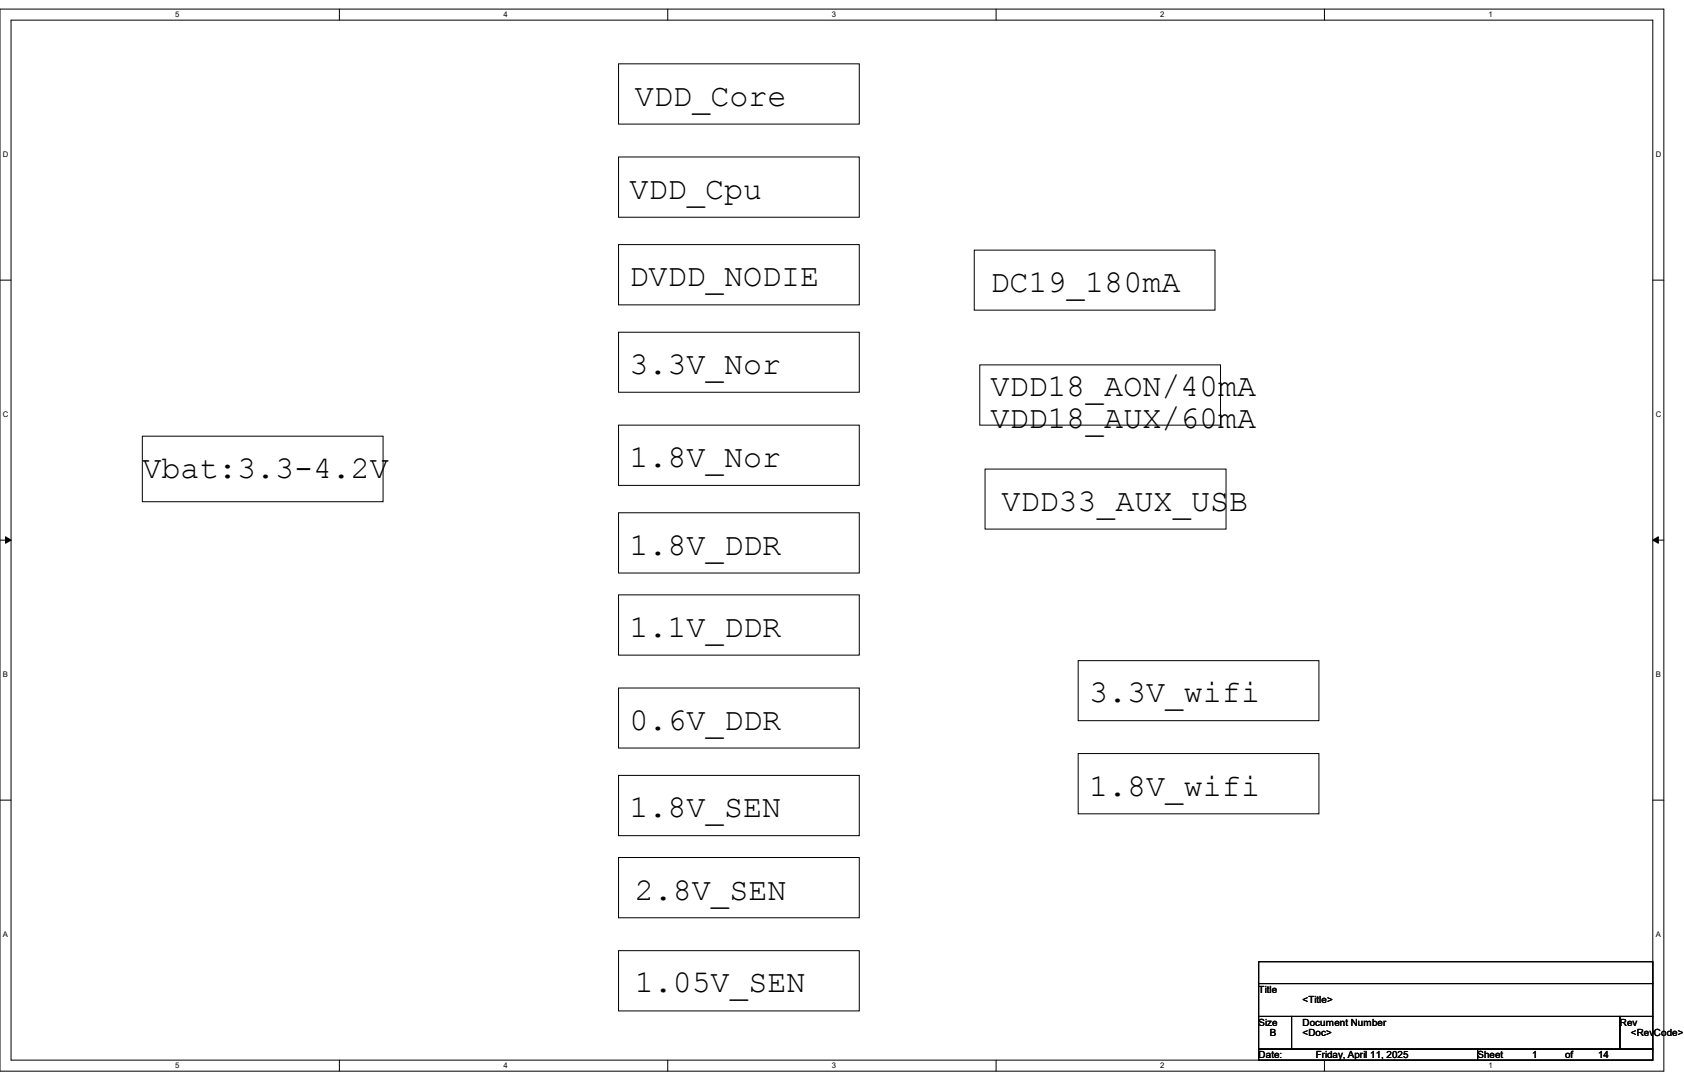
[picture p52: page 1]
VDD_Core; VDD_Cpu; DVDD_NODIE; 3.3V_Nor; 1.8V_Nor; 1.8V_DDR; 1.1V_DDR; 0.6V_DDR; 1.8V_SEN; 2.8V_SEN; 1.05V_SEN; VDD18_AON/40mA VDD18_AUX/60mA; VDD33_AUX_USB; Vbat:3.3-4.2V; 3.3V_wifi; 1.8V_wifiTitle Size; Document Number; Rev Date:; Sheet; of <Doc>; <RevCode>; <Title> B; Friday, April 11, 2025; 14 Title Size

D D

REV | DESCRIPTION | DATE | APPROVED

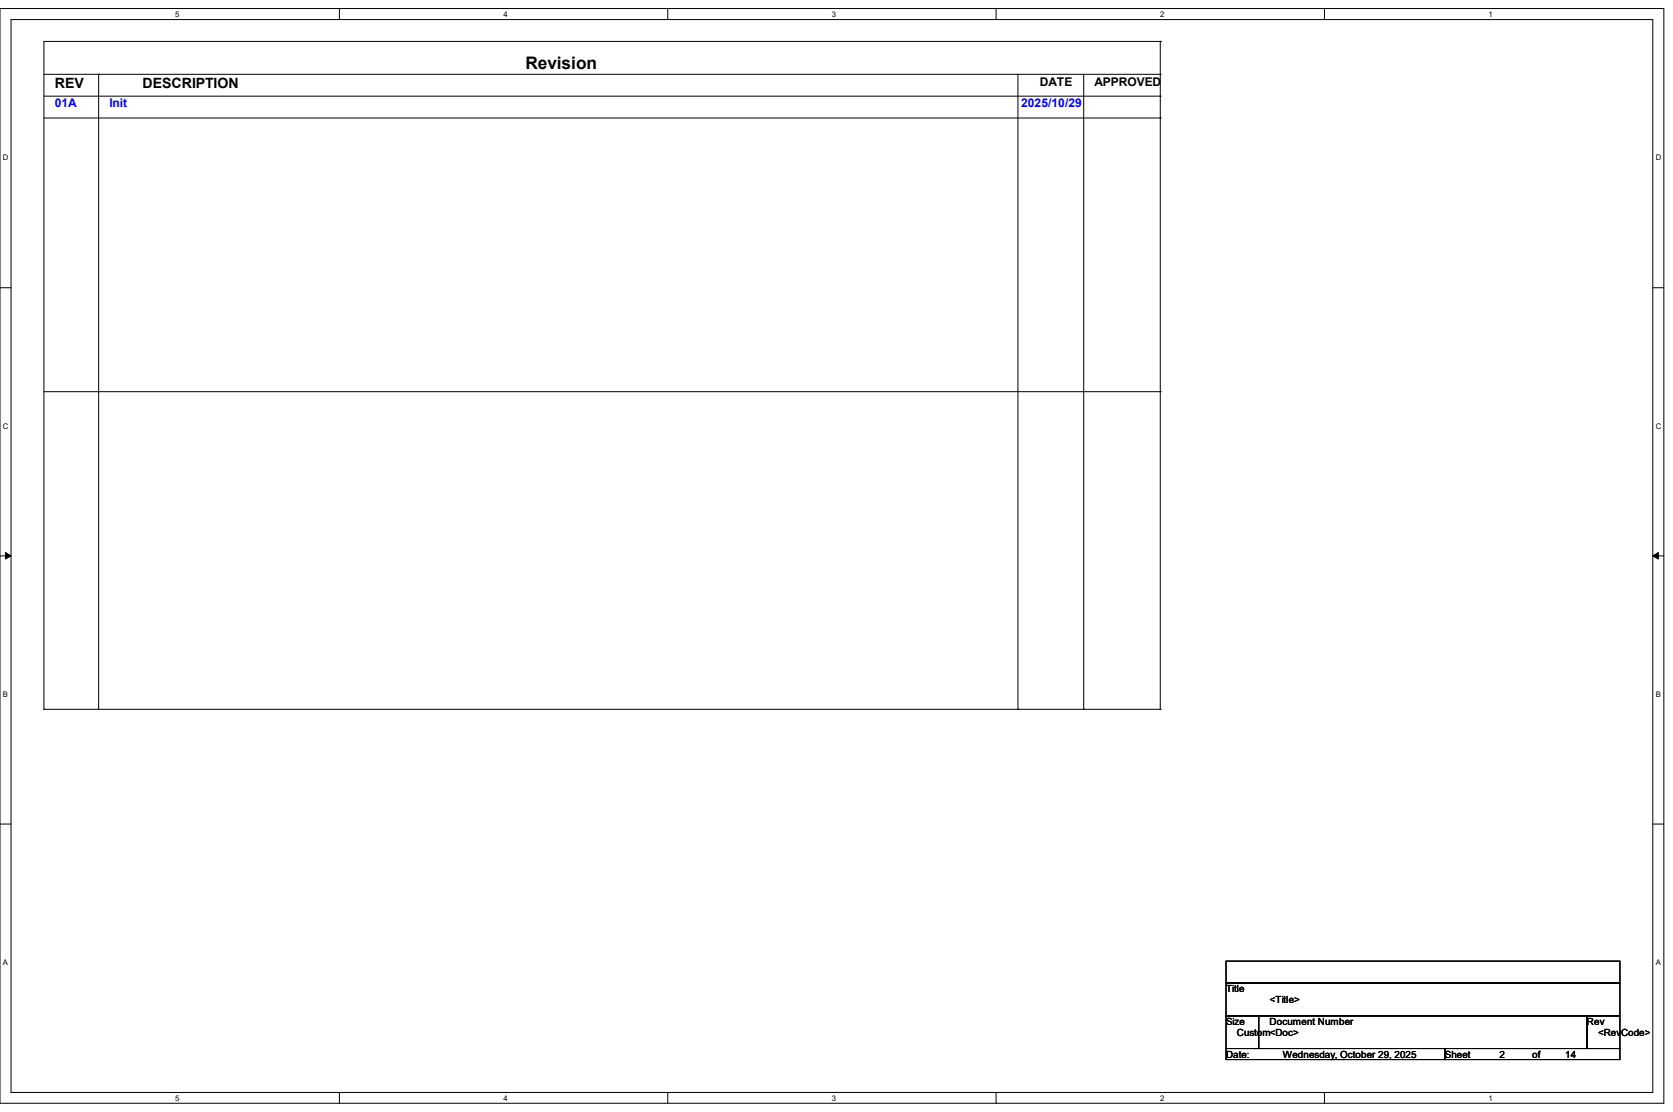
[picture p53: page 2]
Revision; Title Size; Document Number; Rev Date:; Sheet; of <Doc>; <RevCode>; <Title> Custom Wednesday, October 29, 2025; 14 Title Size

01A | Init | 2025/10/29

# MIPI PAD0

# MIPI PAD0

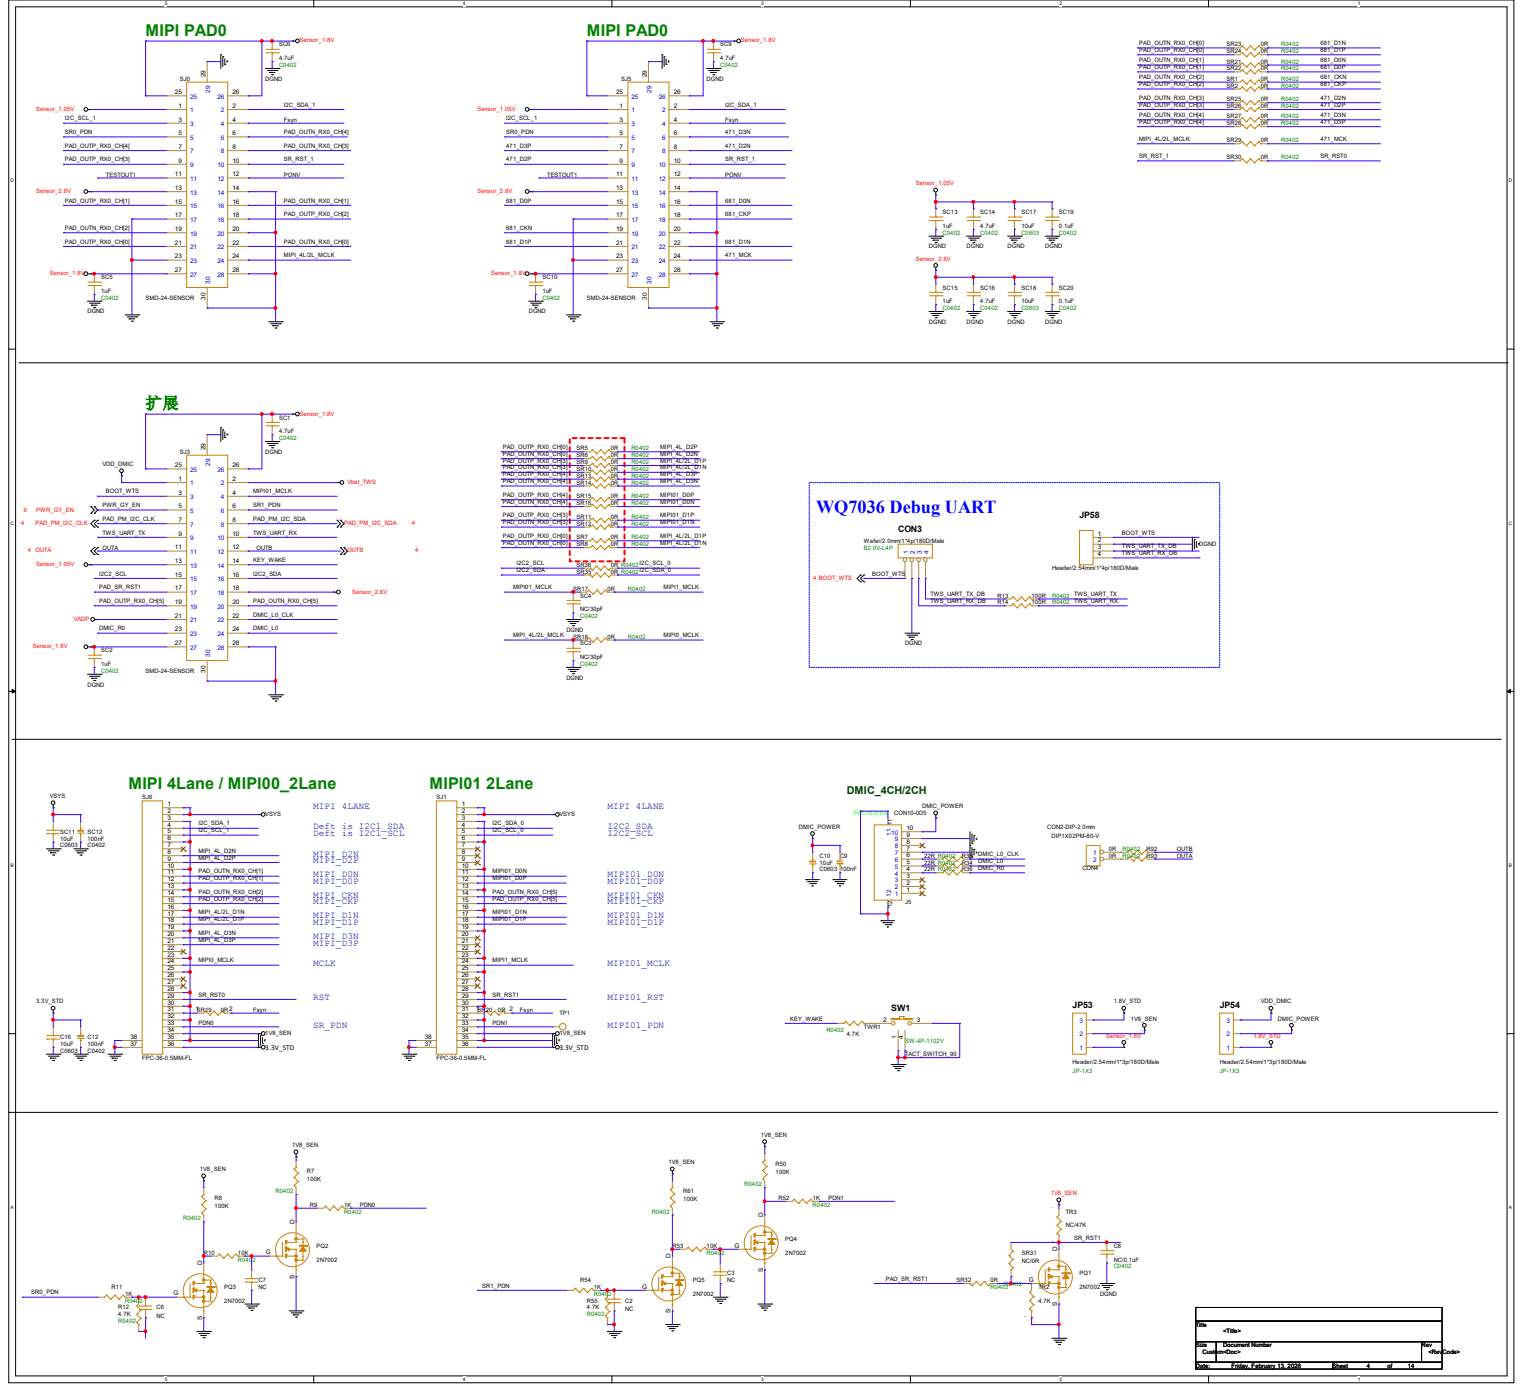
[picture p54: page 3]

# TYPE-C

扩展

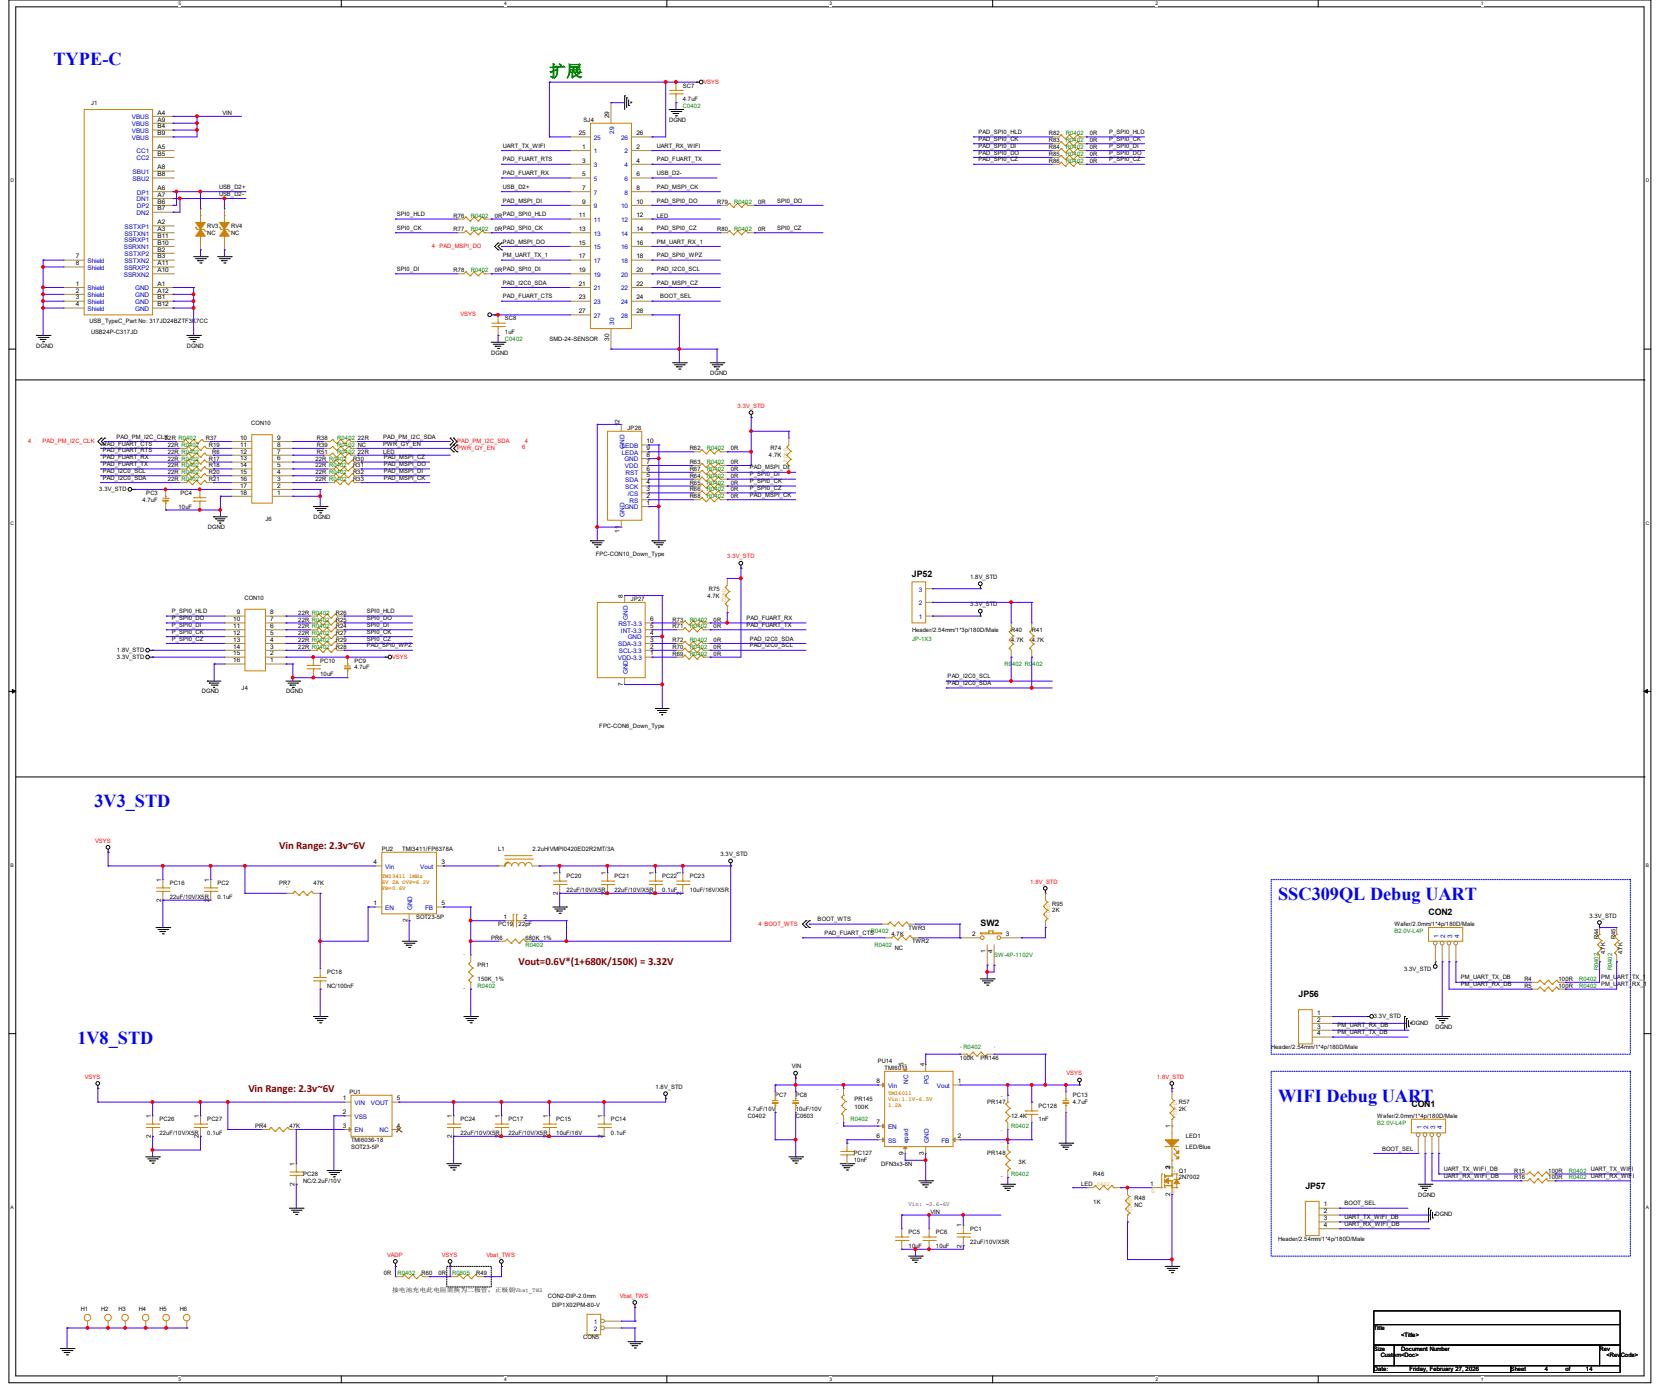
[picture p55: page 4]

/CS 3 SCK 4 SDA RST 5

JP27 FPC-CON6_Down_Type VDD-3.3 1 SCL-3.3 2 SDA-3.3 GND 3

# Gyro sensor

# I2C mode

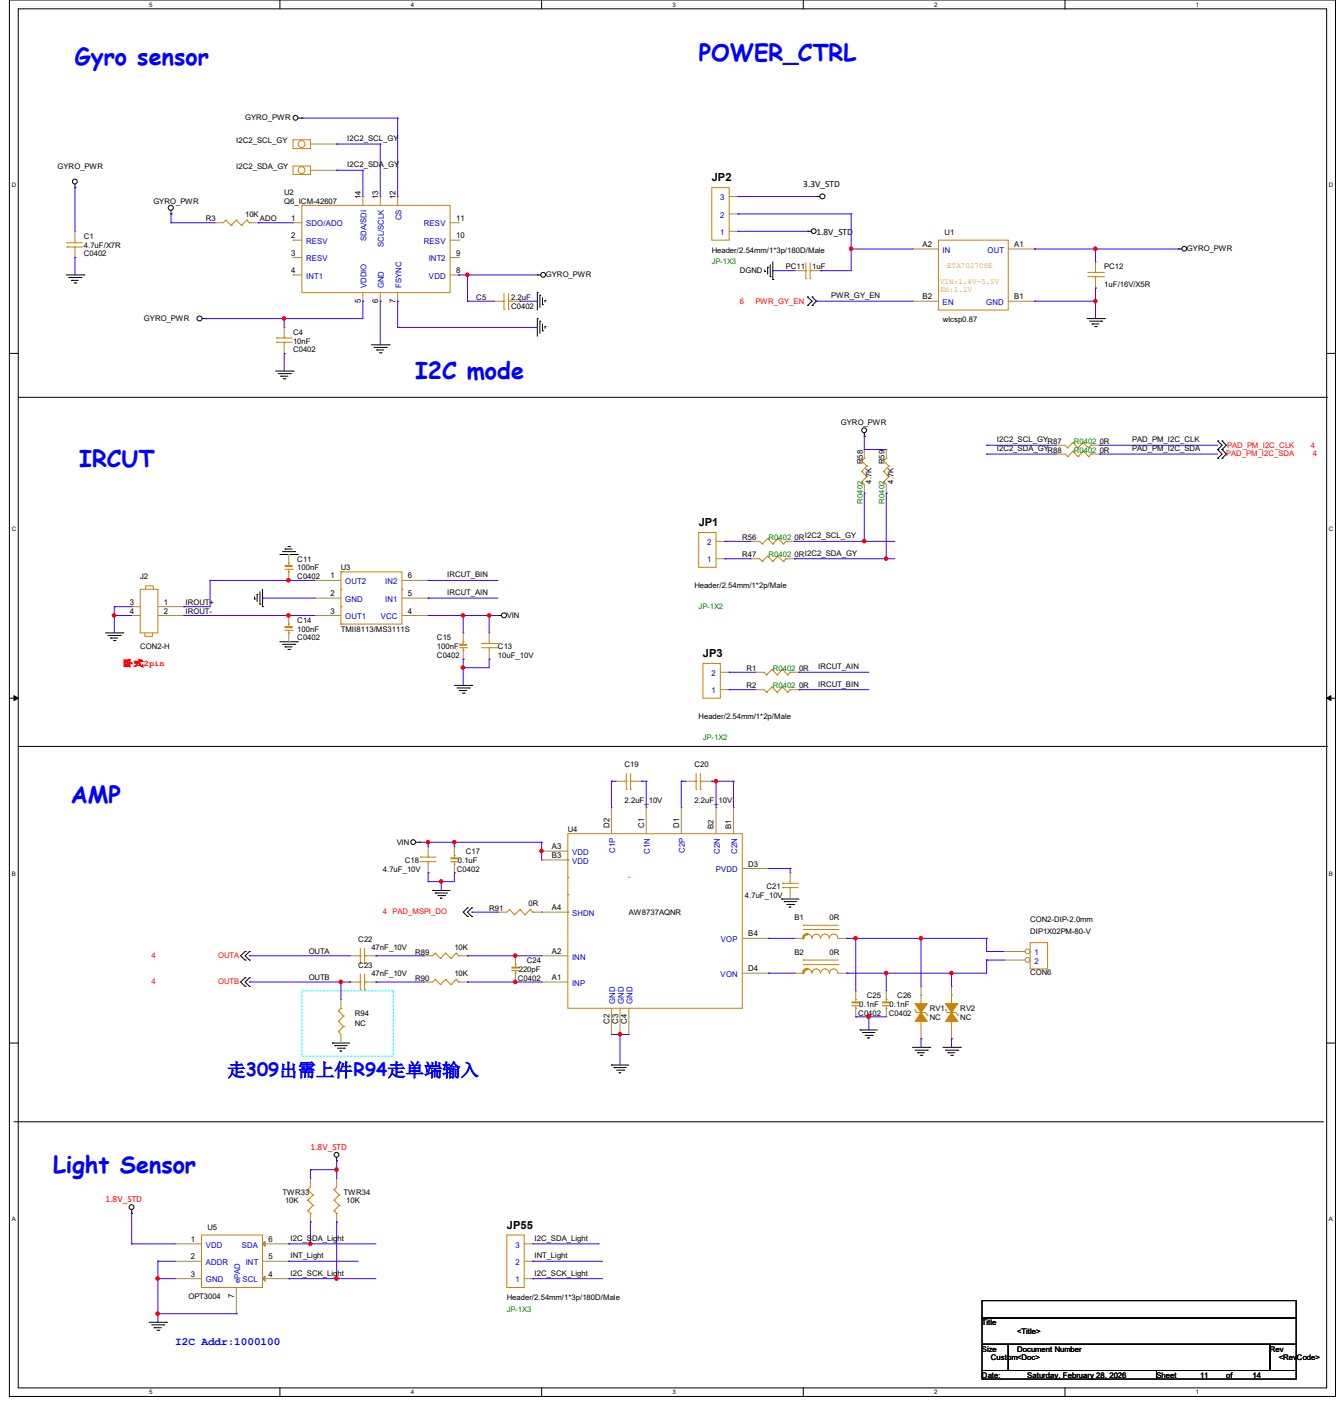
[picture p56: page 5]

U2Q6_ICM-42607 SDO/ADO 1 RESV 2 RESV 3
