HuaqiuOpenHardware/Comake-Pi-D2/hardware/pcb/Comake-Pi-D2-V2.0_BGA8_9.5_Demo_20260409/extracted/SSC309QL-S01D-AI-SCH_20260206.pdf

# Sensor MIPI PAD0

## Sensor_1.8V

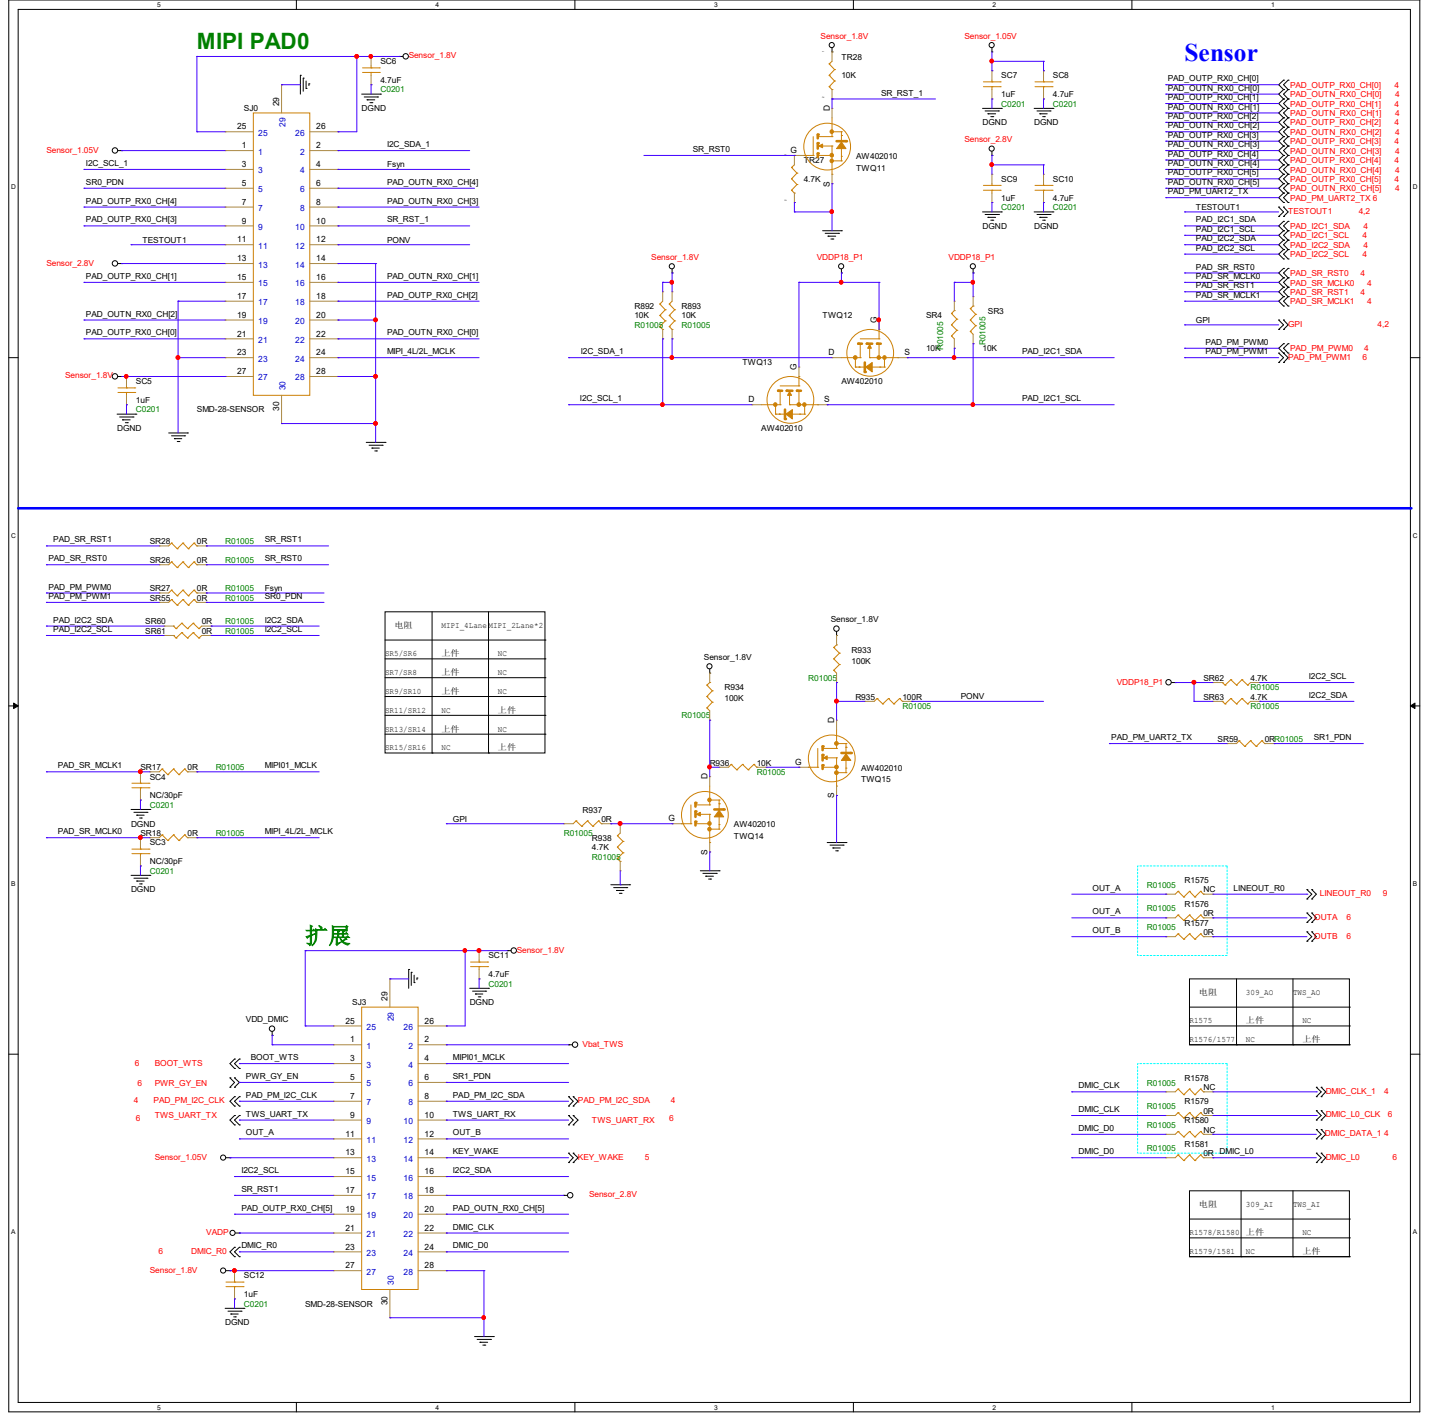
[picture p57: page 1]

D D

# VDD_Core

VDD_Cpu; DVDD_NODIE; 3.3V_Nor; 1.8V_Nor; 1.8V_DDR; 1.1V_DDR; 0.6V_DDR; 1.8V_SEN; 2.8V_SEN; 1.05V_SEN; VDD18_AON/40mA VDD18_AUX/60mA; VDD33_AUX_USB; Vbat:3.3-4.2V; 3.3V_wifi; 1.8V_wifiTitle Size; Document Number; Rev Date:; Sheet; of <Doc>; <RevCode>; <Title> B; Friday, April 11, 2025; 14 Title Size

D D

REV | DESCRIPTION | DATE | APPROVED

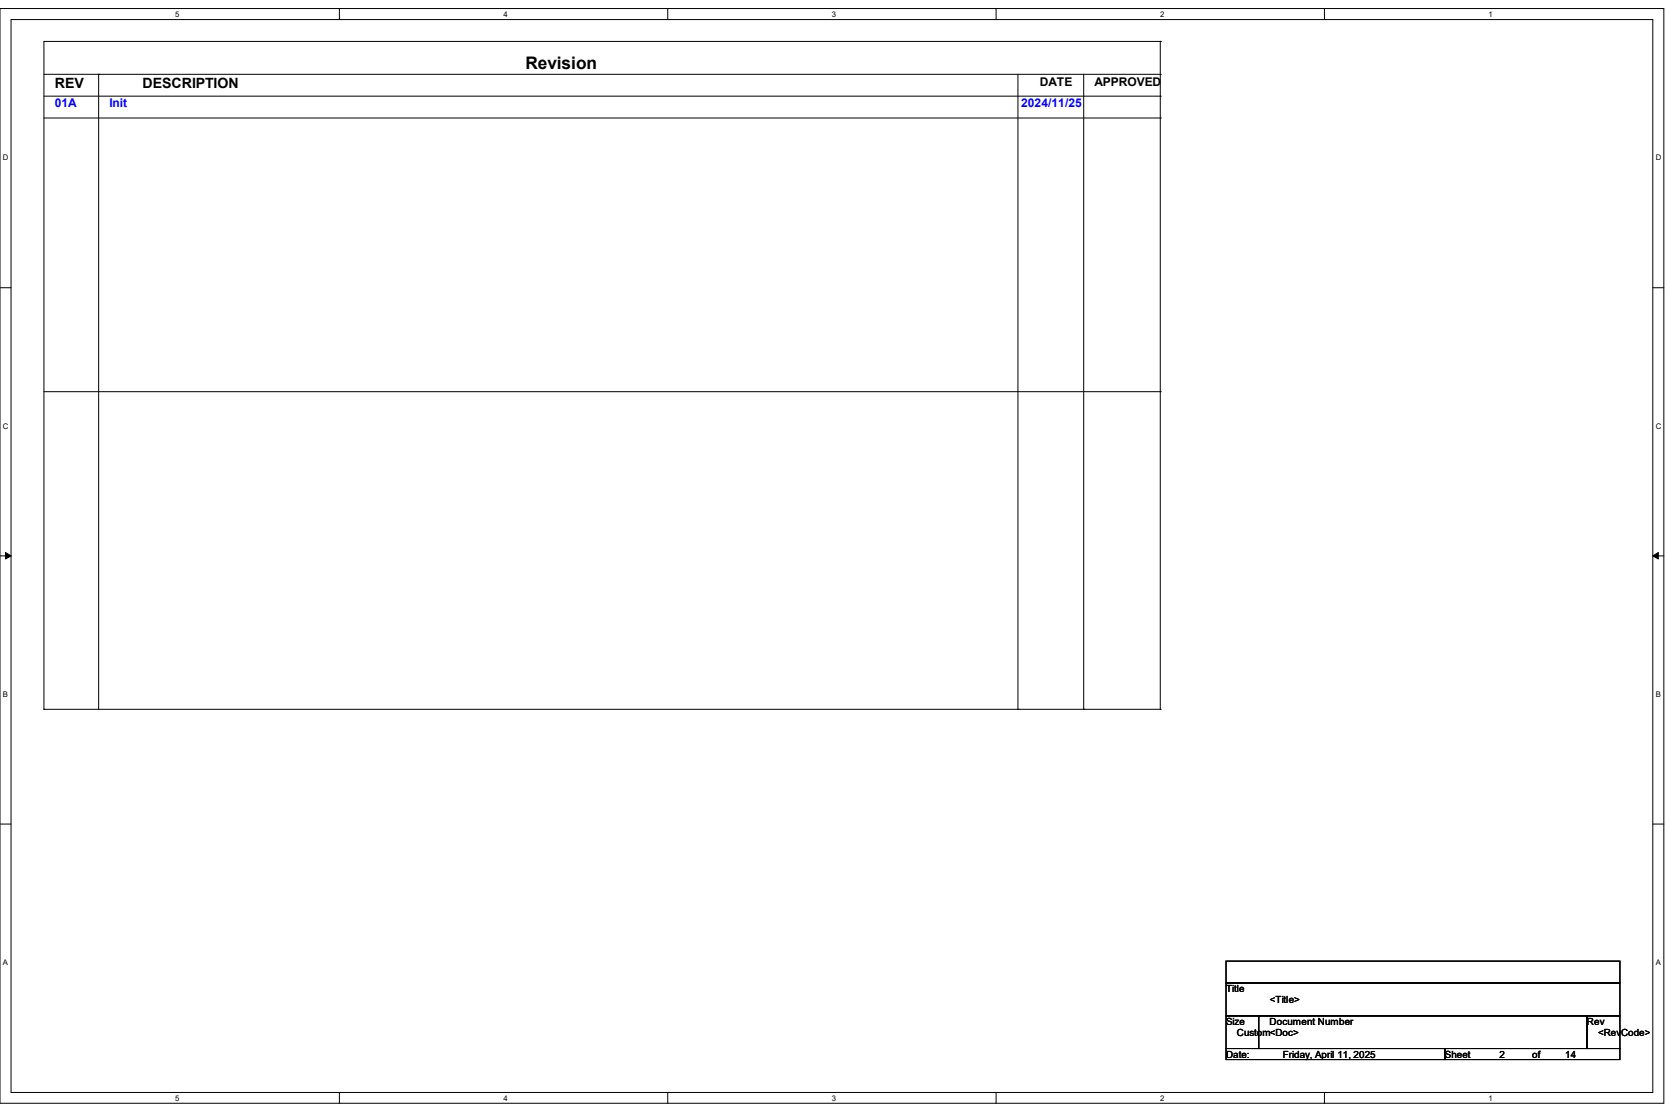
[picture p58: page 3]
Revision; Title Size; Document Number; Rev Date:; Sheet; of <Doc>; <RevCode>; <Title> Custom; Friday, April 11, 2025; 14 Title Size

01A | Init | 2024/11/25

# Vout=0.6V*(1+20/40) = 0.9V

VDD_CORE | Vin Range: 2.5v~6.5V

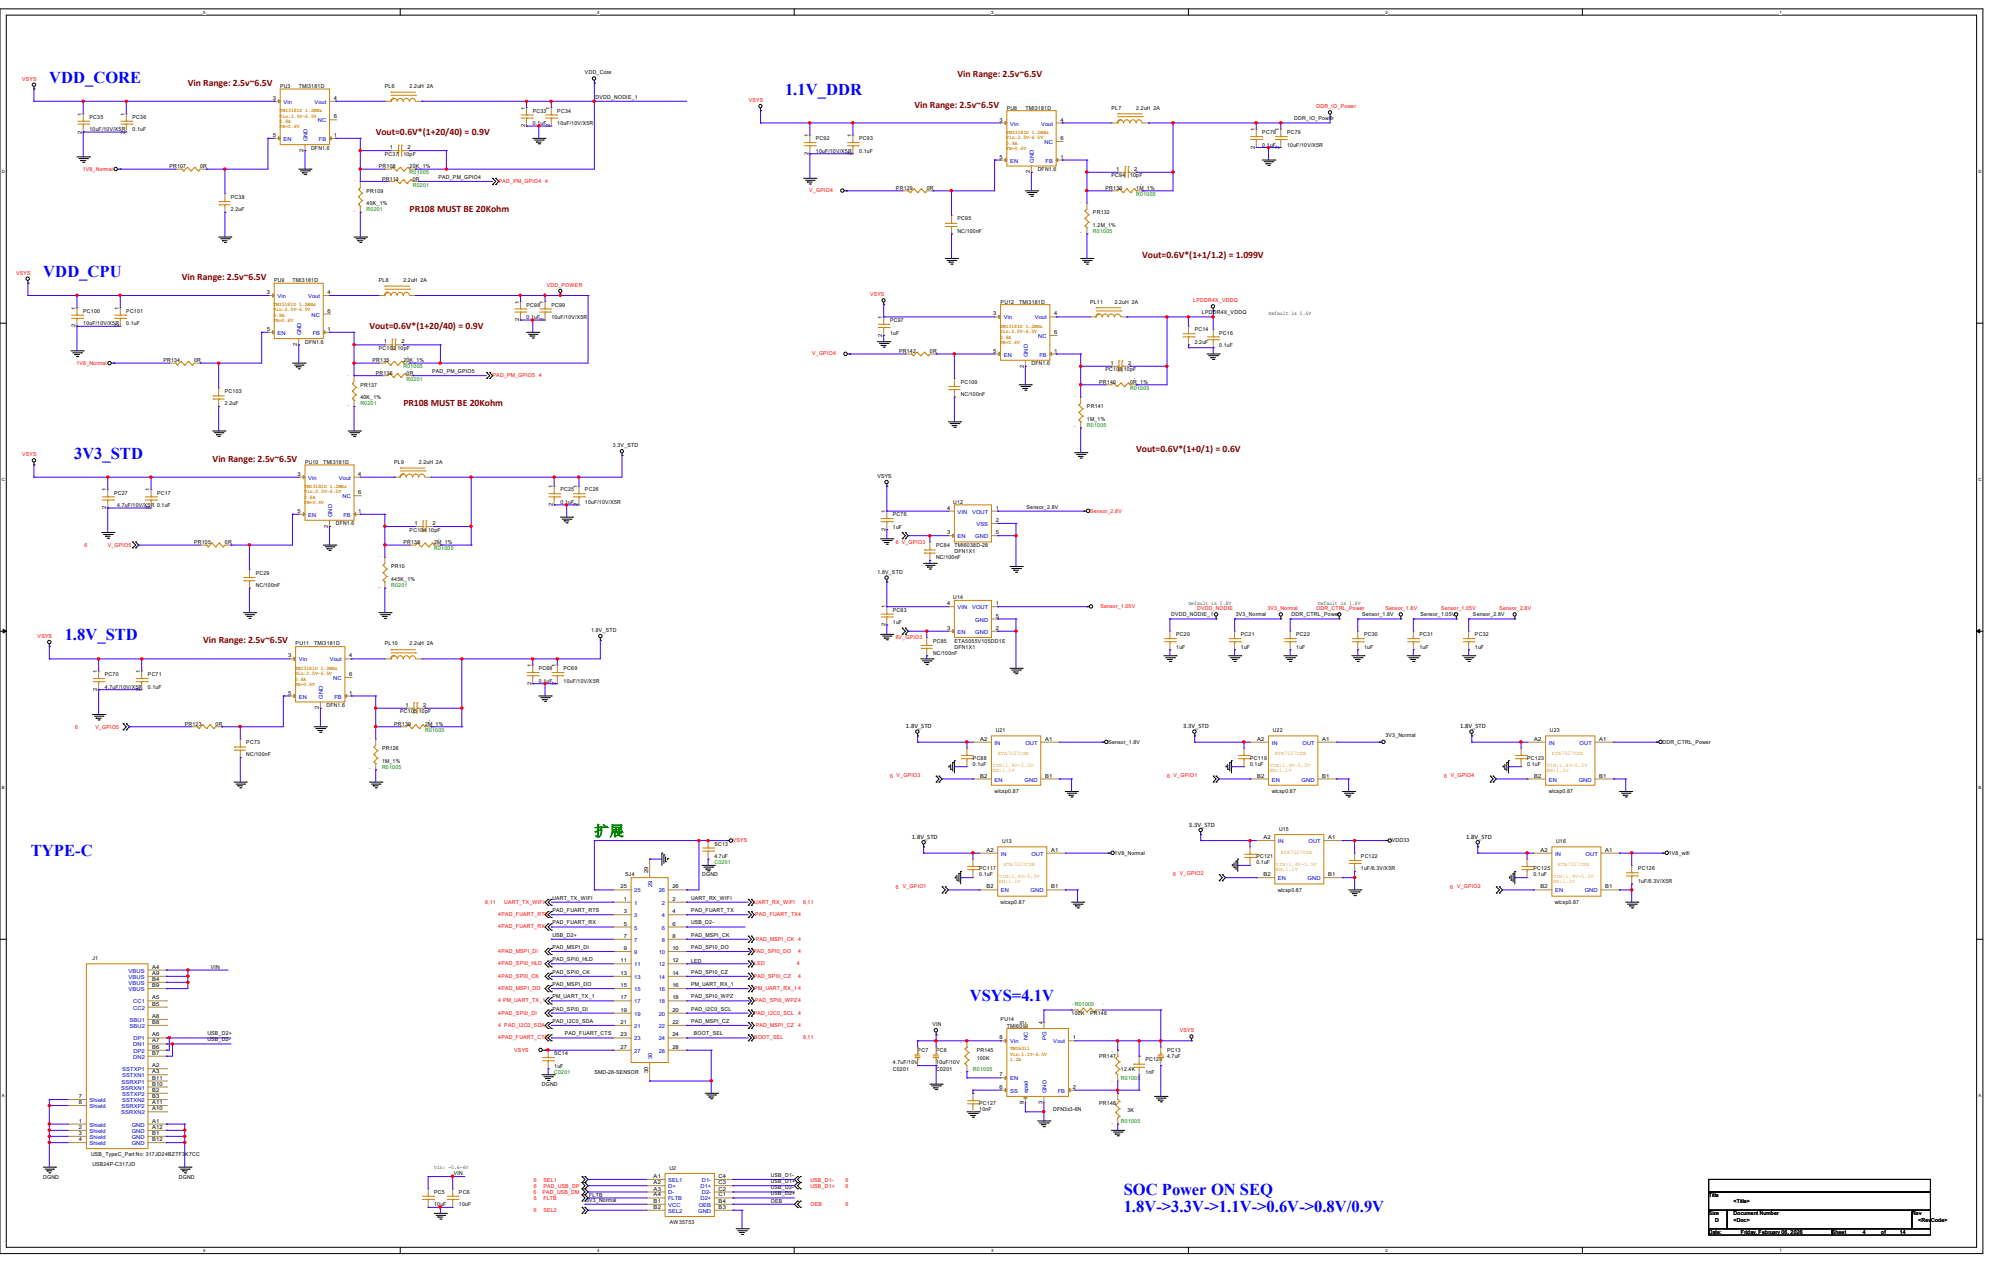
[picture p59: page 4]

SOC Power ON SEQ

## (u/IC)

# Core Max: 2/0.9=2.2A

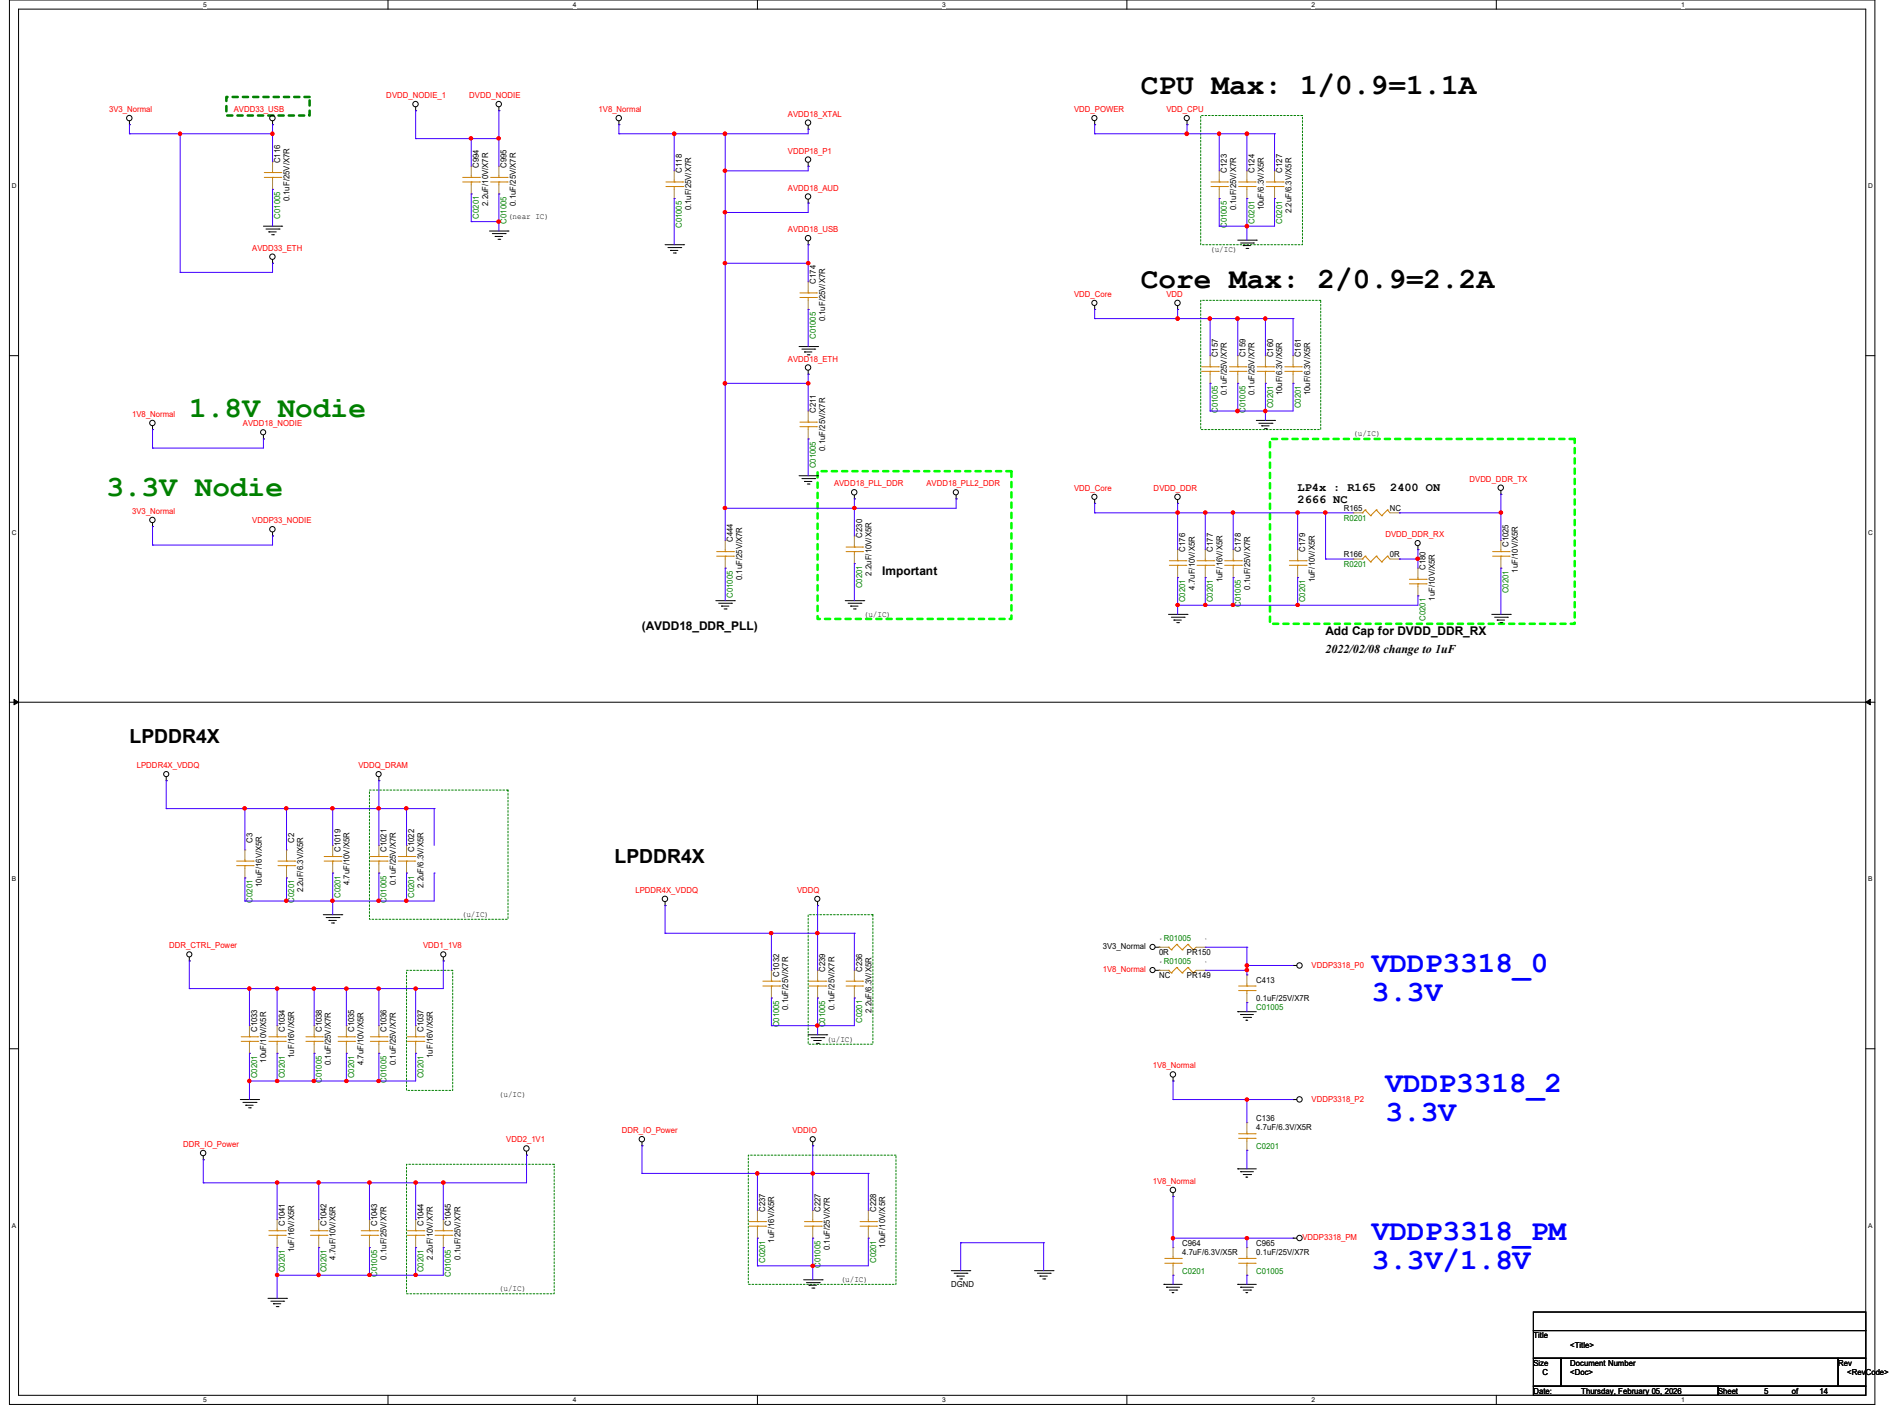
[picture p60: page 5]

Add Cap for DVDD_DDR_RX ⁽u/IC)

# MIPI RX

# PM_PSPI

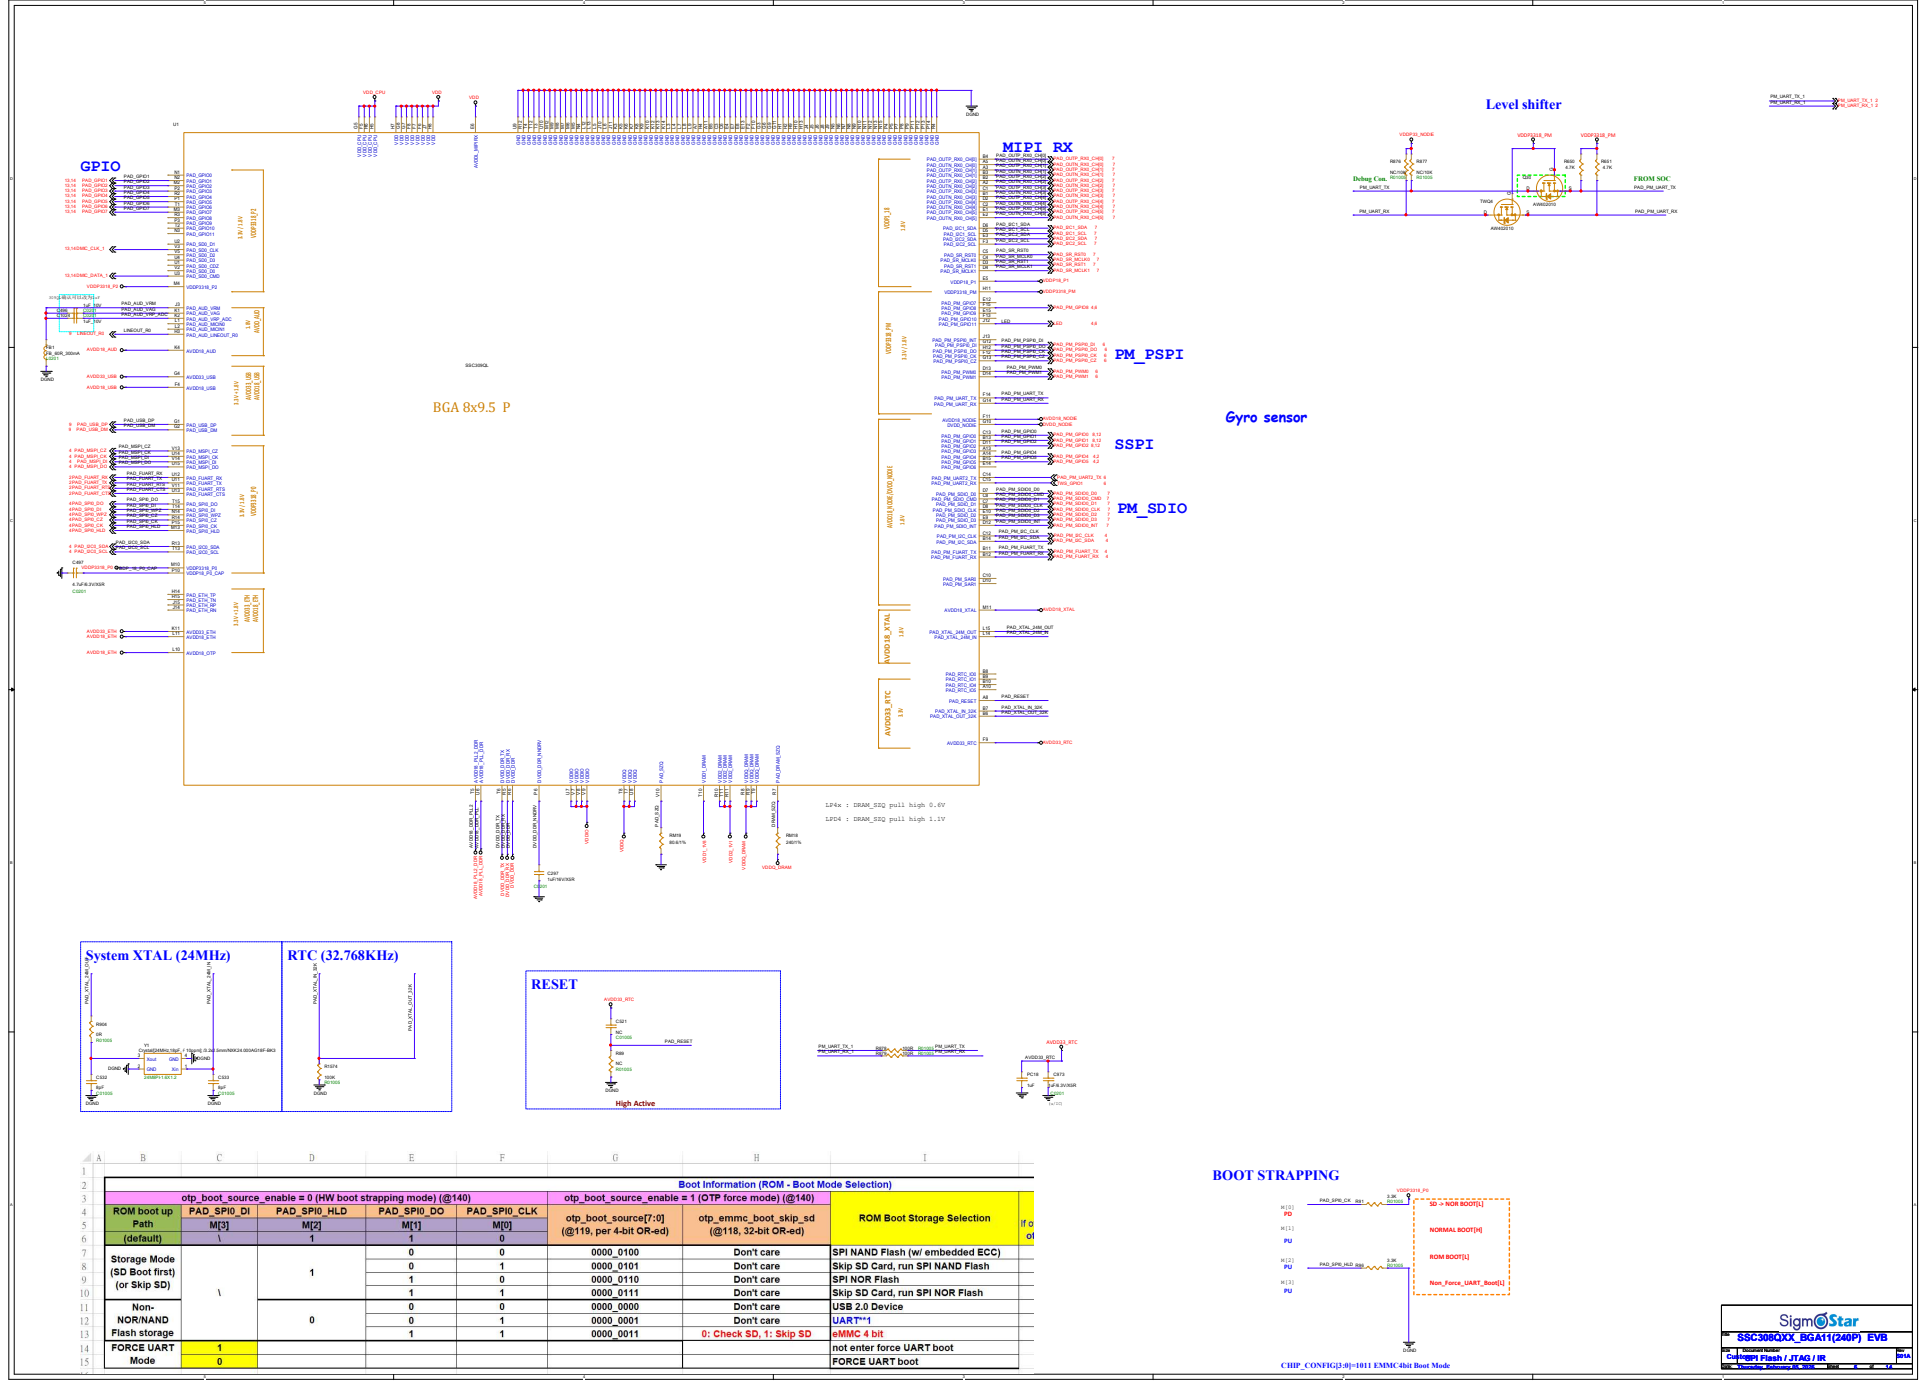
[picture p61: page 6]

# TWS WQ7036AX

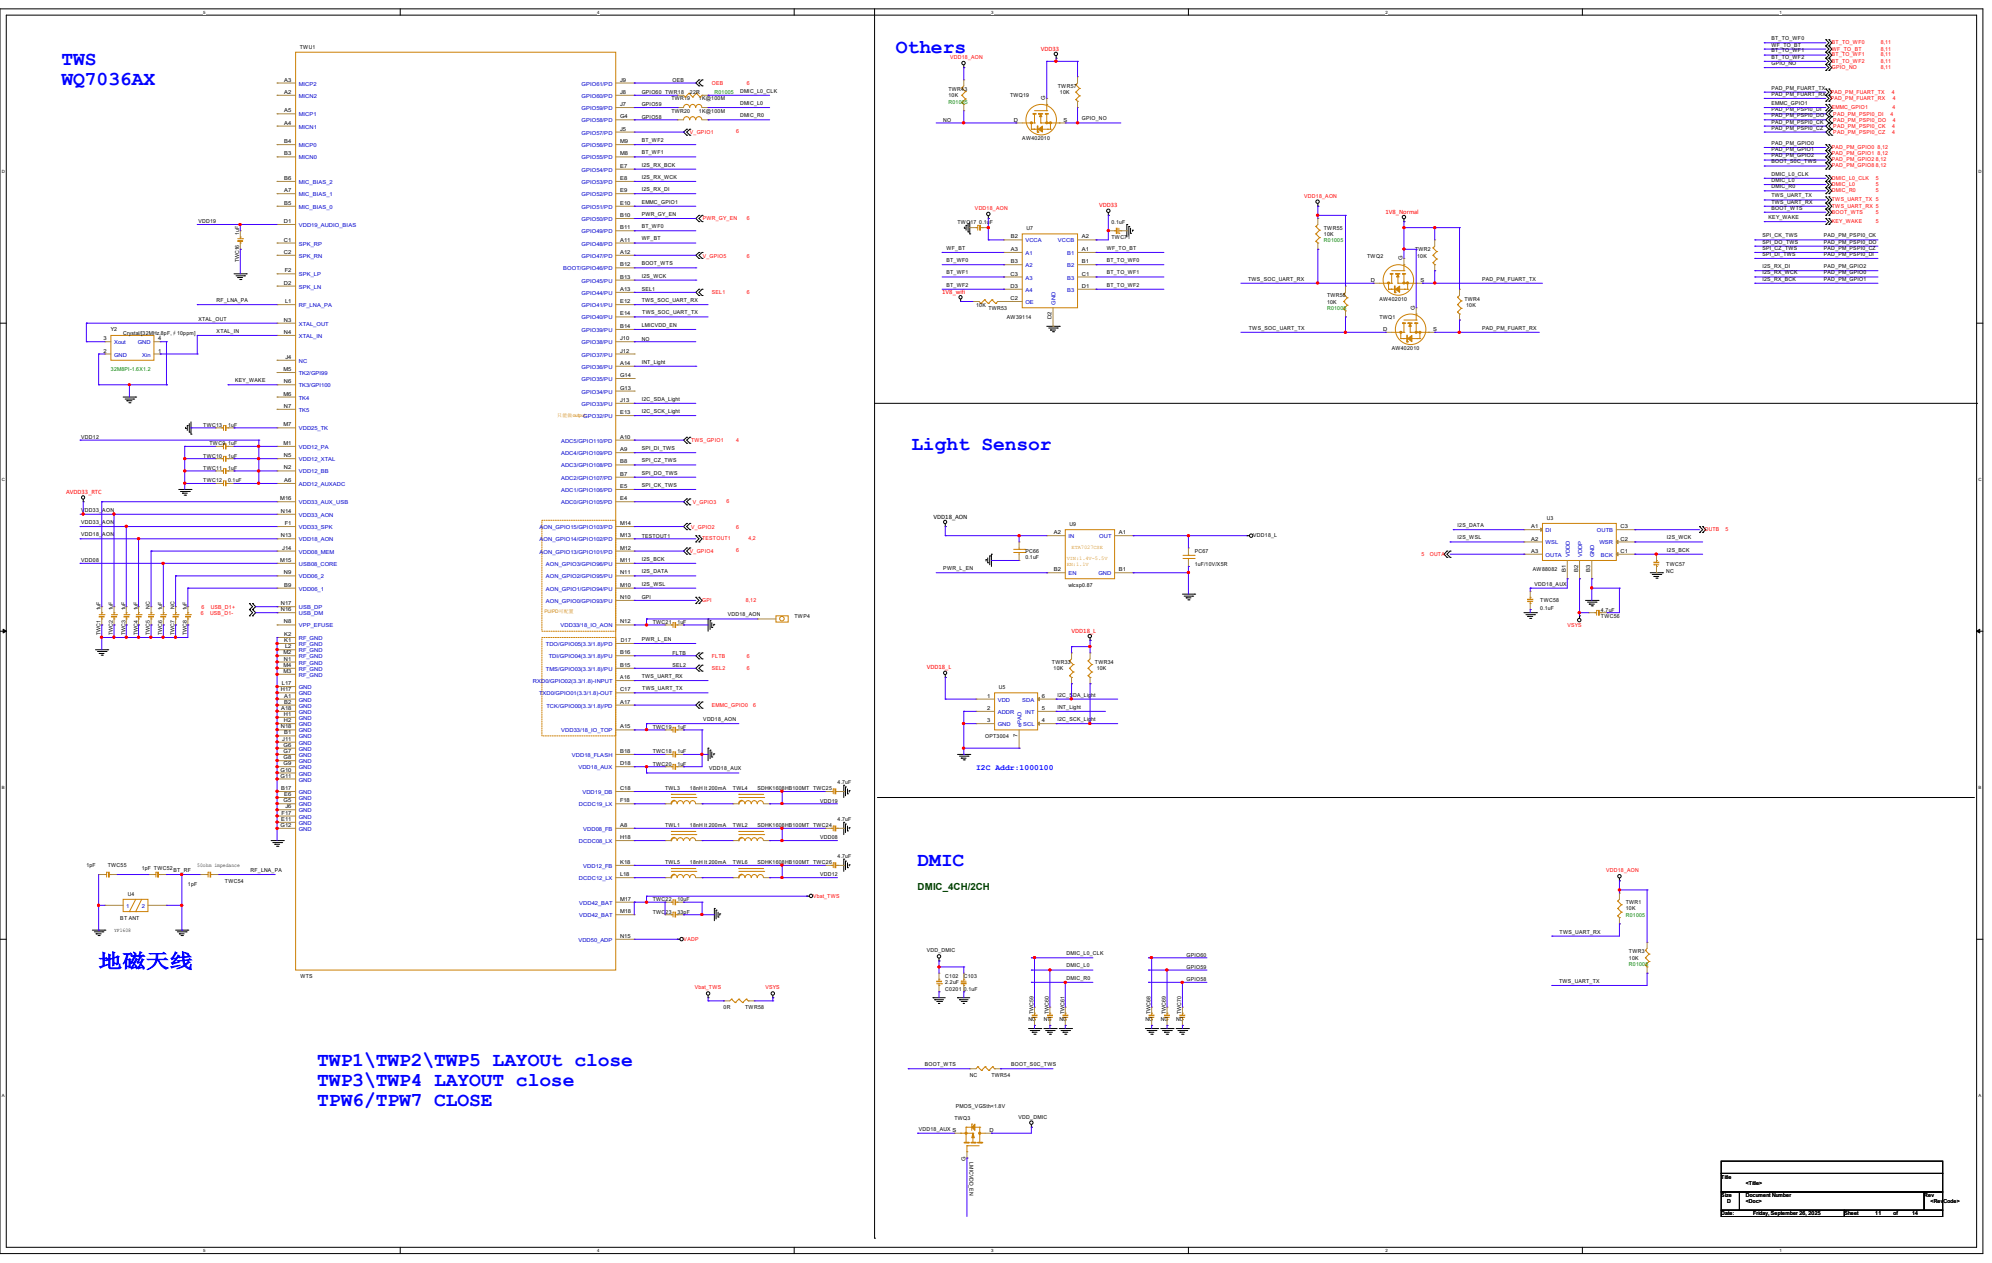
[picture p62: page 7]

0.1uF TWC¹⁶ ¹uF TWC³ ¹uF

# EMMC4b_boot

# EMMC32G-KC30

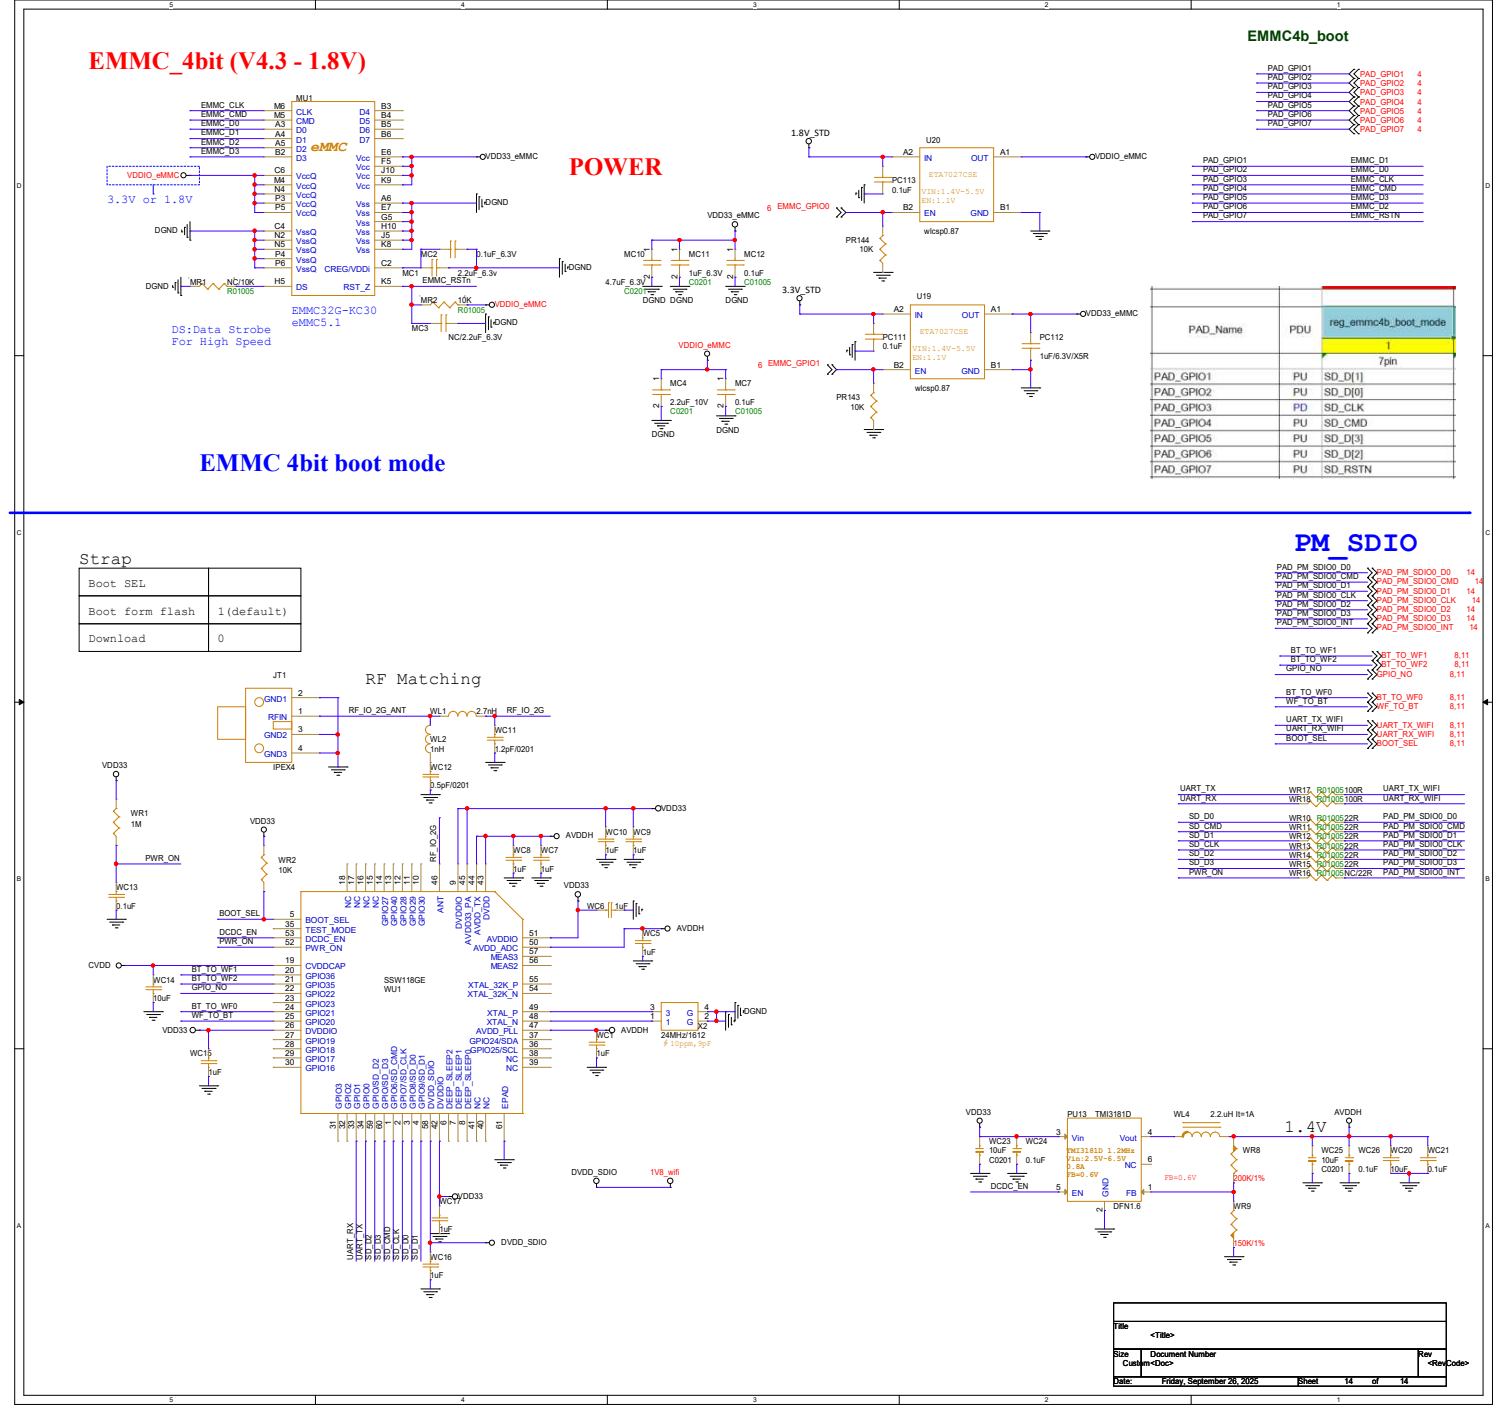
[picture p63: page 8]

9 GPIO30 10 GPIO29 11 GPIO28 12 GPIO40 13 GPIO27 14 NC 15 NC 16 NC 17 NC 18 CVDDCAP 19 GPIO36 20 GPIO35 21 GPIO22 22 GPIO23 23 GPIO21 24 GPIO20 25 DVDDIO 26 GPIO19 27 GPIO18 28 GPIO17 29 GPIO16 30 GPIO3 31 GPIO2 32 GPIO1 33 GPIO0 34 TEST_MODE 35 GPIO25/SCL GPIO24/SDA 36
