HuaqiuOpenHardware/Comake-Pi-D2/hardware/pcb/Comake-Pi-D2-V1.0_BGA8_9.5_Demo_20251215/extracted/Comake-Pi-D2-V1.0_BGA8_9.5_Demo_20251215/Comake-Pi-D2-V1.0_BGA8_9.5_Demo_20250926.pdf

5

4

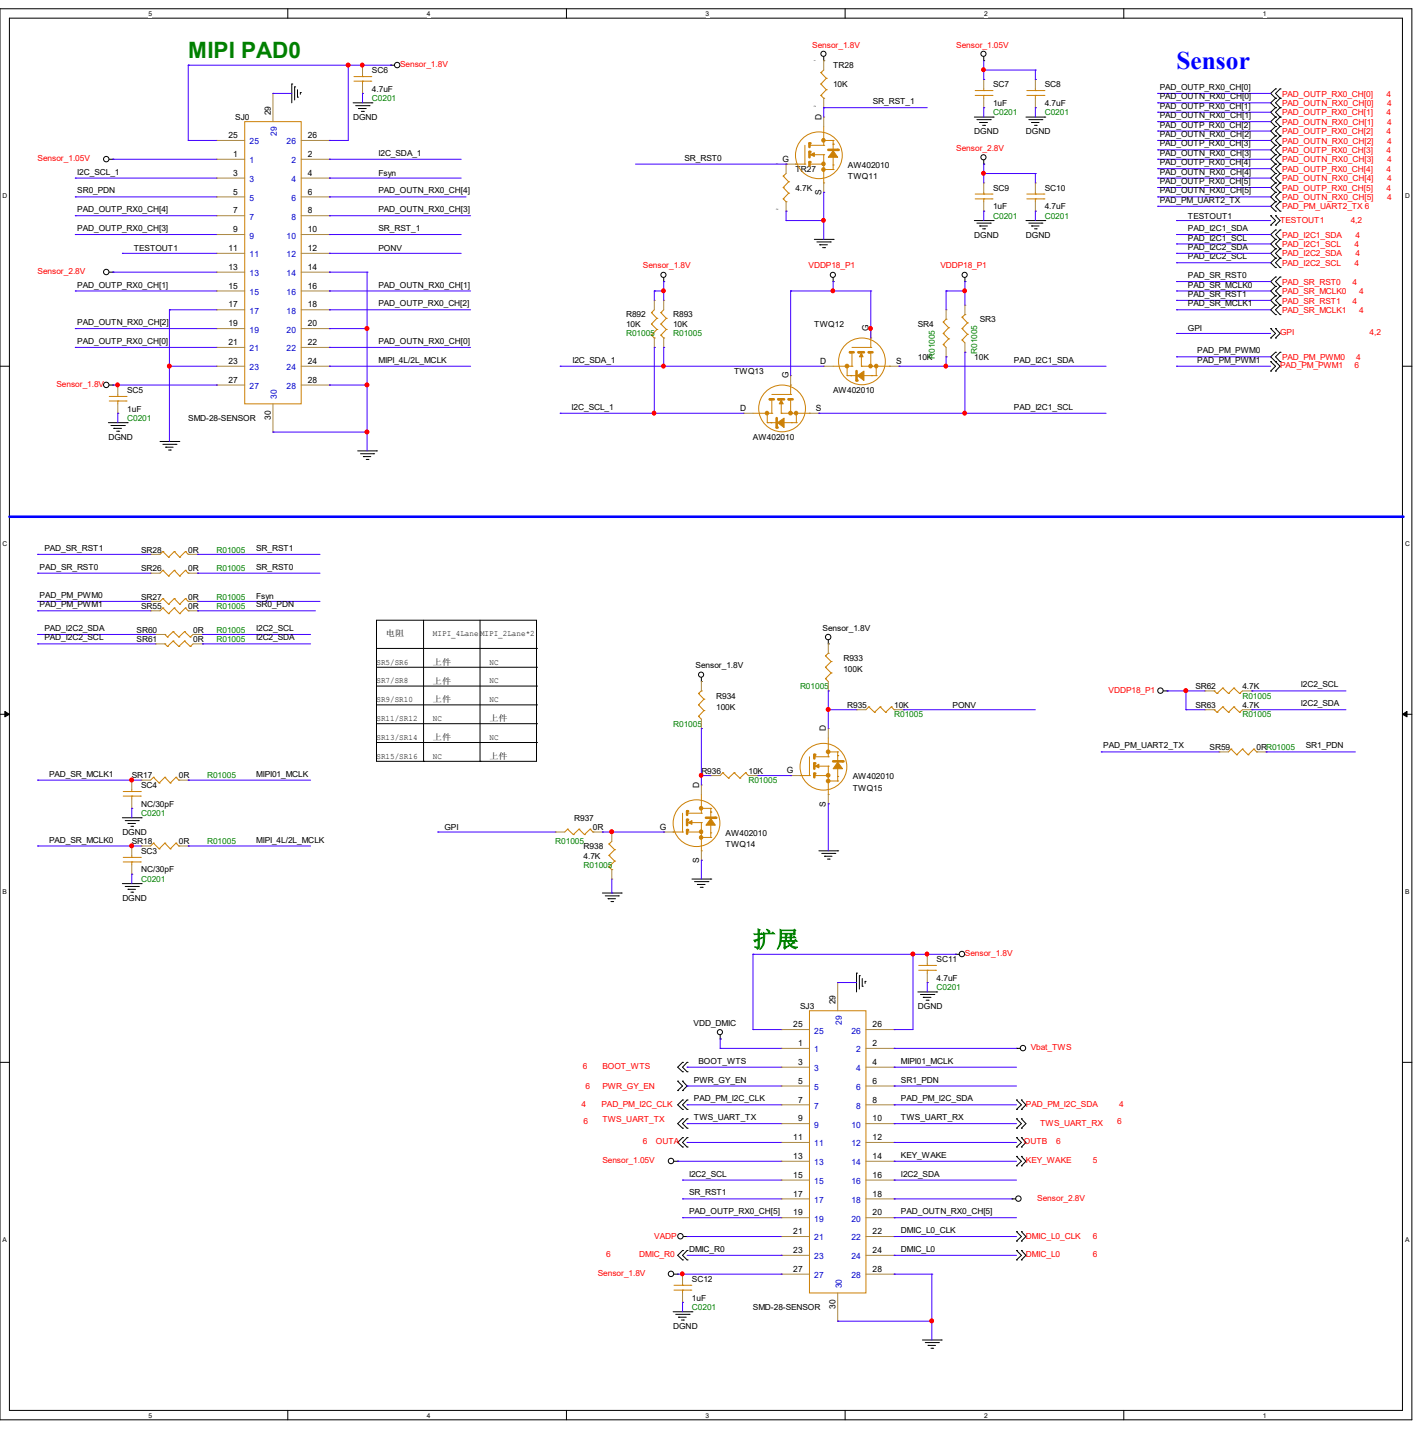
[picture p64: page 1]

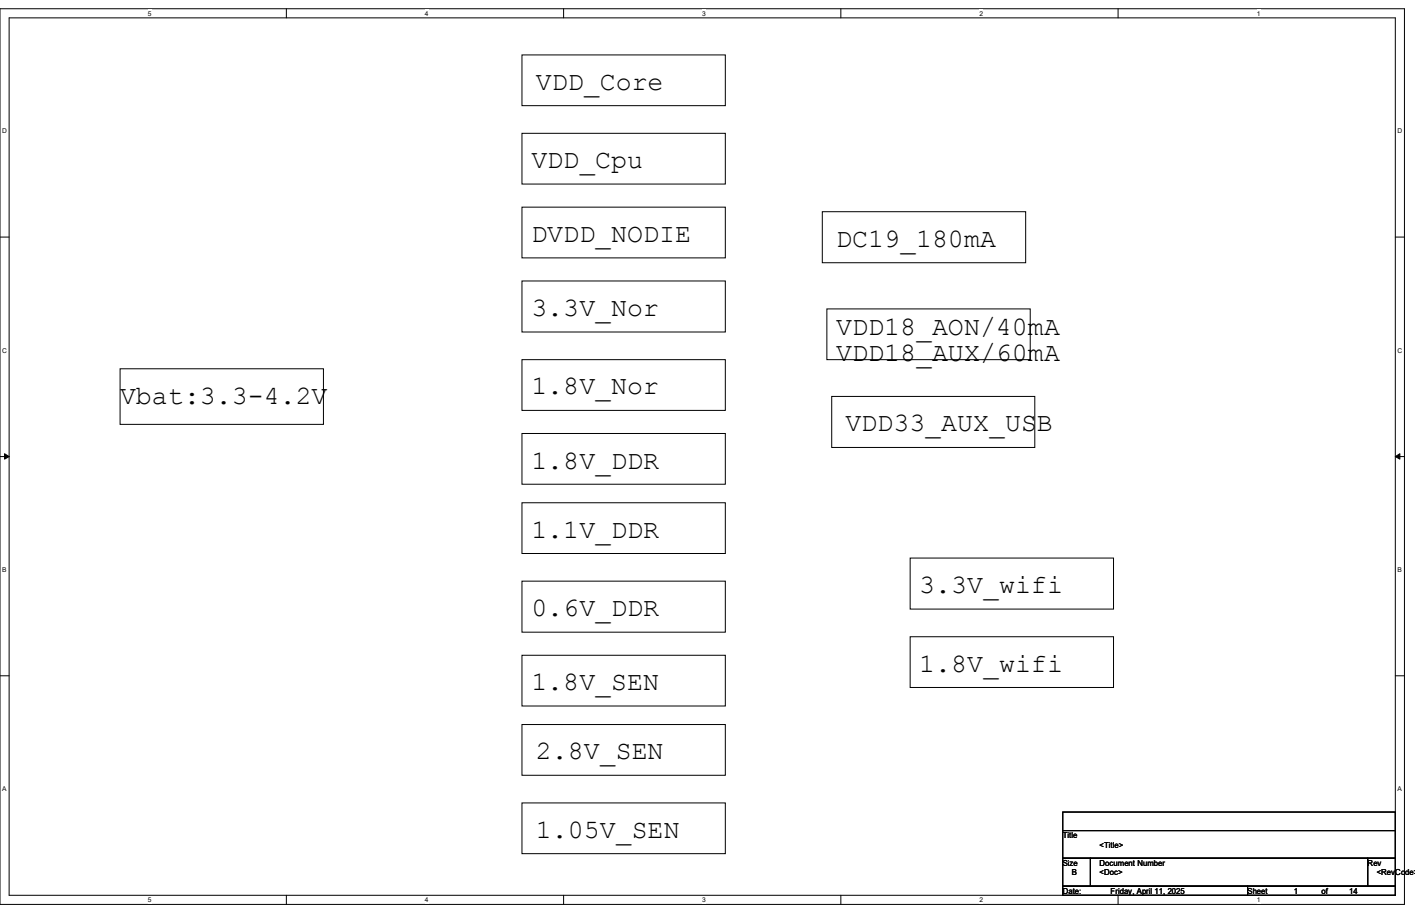
[picture p65: page 2]
VDD_Core; VDD_Cpu; DVDD_NODIE; 3.3V_Nor; 1.8V_Nor; 1.8V_DDR; 1.1V_DDR; 0.6V_DDR; 1.8V_SEN; 2.8V_SEN; 1.05V_SEN; VDD18_AON/40mA VDD18_AUX/60mA; VDD33_AUX_USB; Vbat:3.3-4.2V; 3.3V_wifi; 1.8V_wifiTitle Size; Document Number; Rev Date:; Sheet; of <Doc>; <RevCode>; <Title> B; Friday, April 11, 2025; 14 Title Size

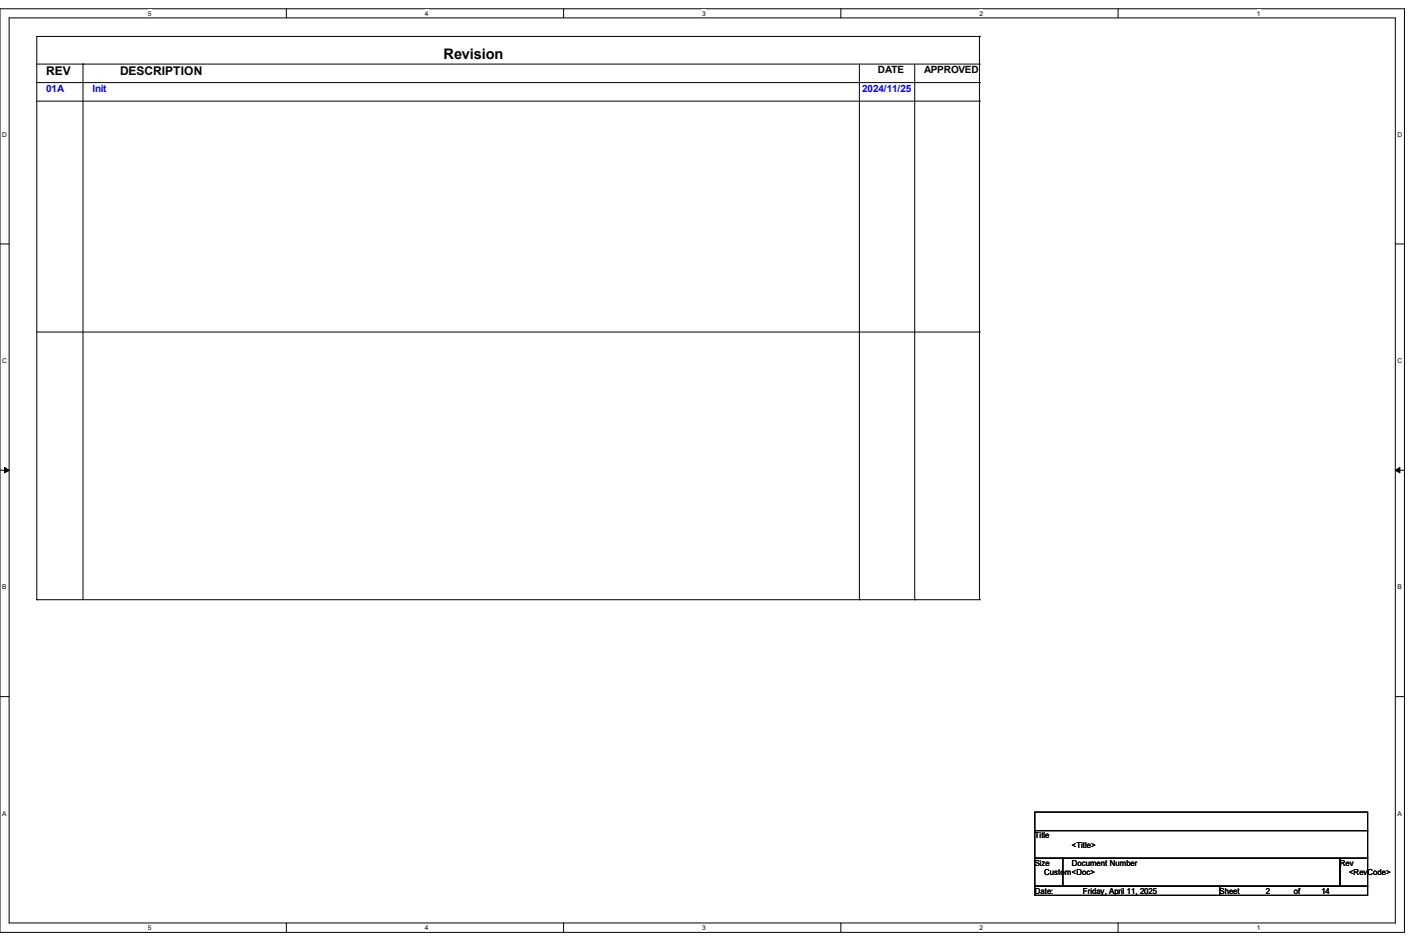
[picture p66: page 3]
Revision; Title Size; Document Number; Rev Date:; Sheet; of <Doc>; <RevCode>; <Title> Custom; Friday, April 11, 2025; 14 Title Size

REV | DESCRIPTION | DATE | APPROVED
01A | Init | 2024/11/25

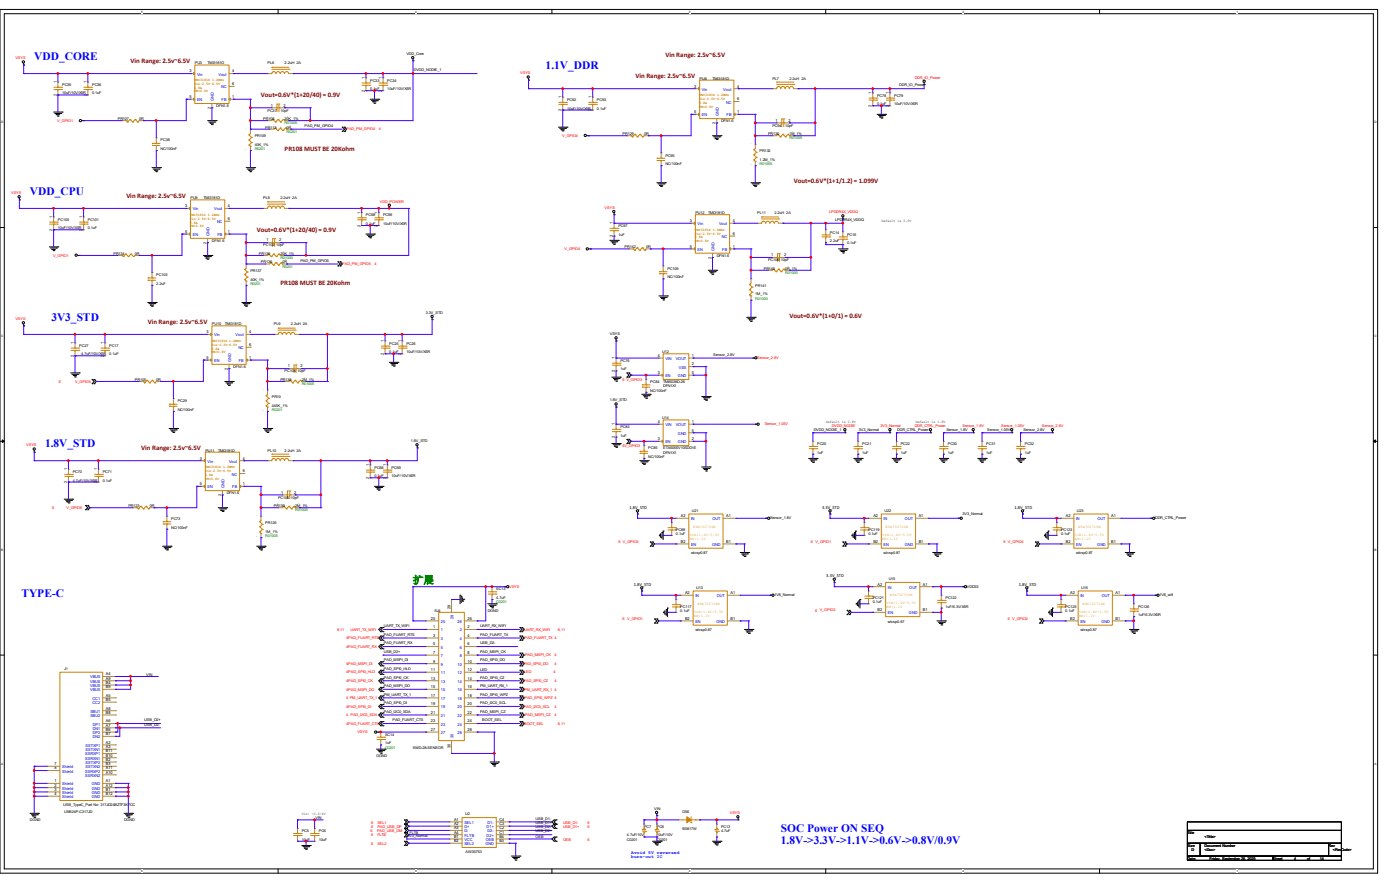
[picture p67: page 4]

SOC Power ON SEQ

5

4

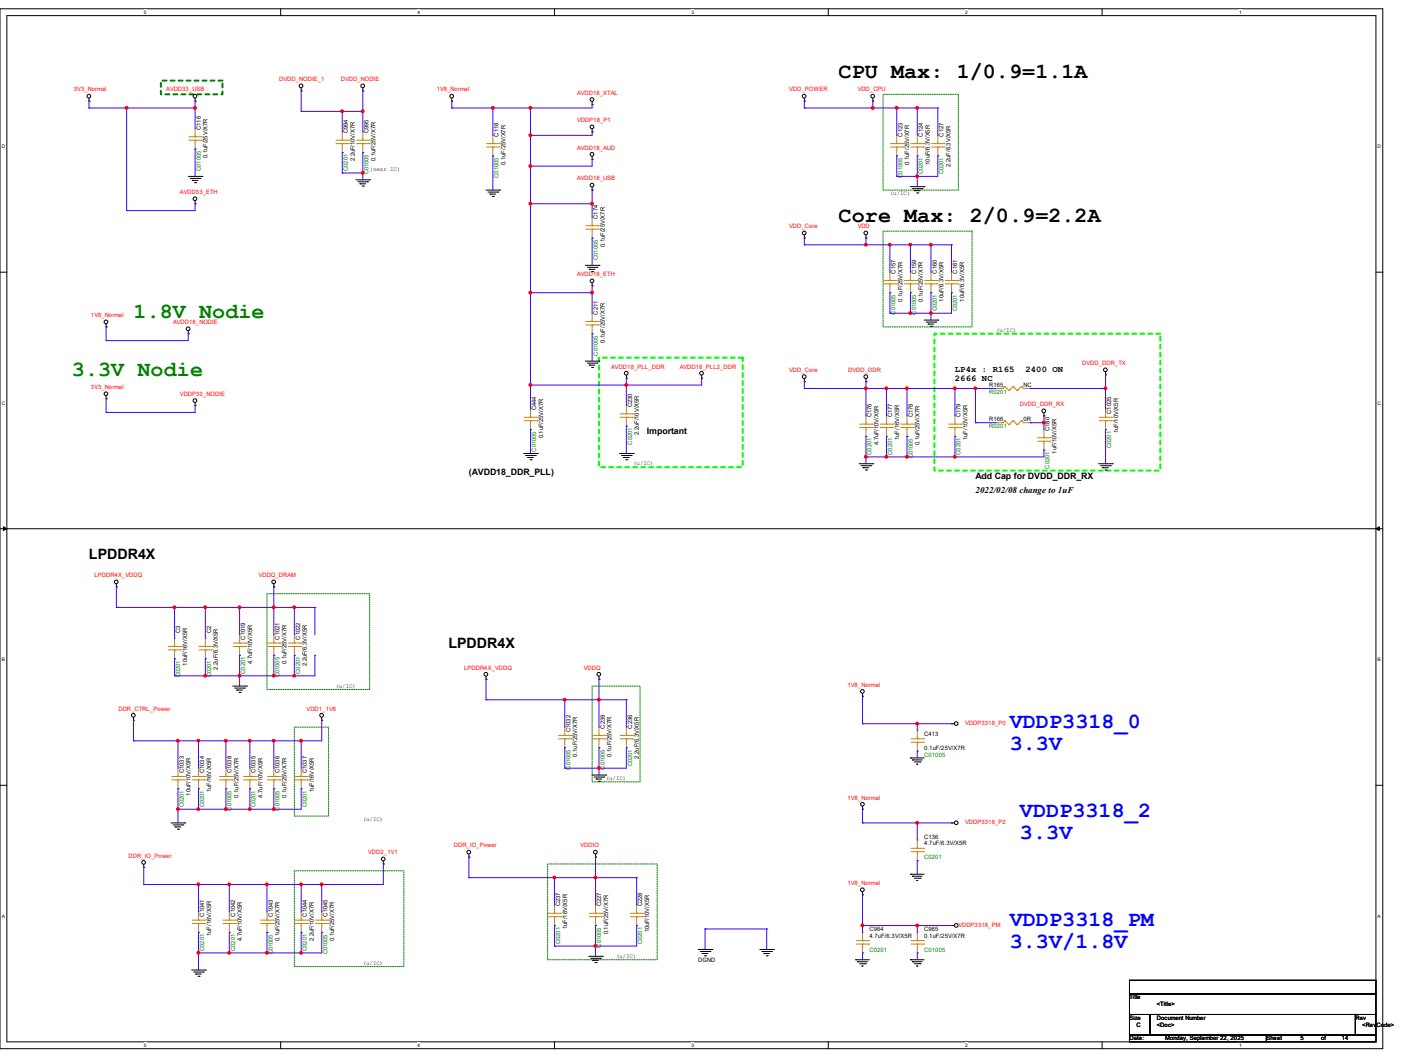
[picture p68: page 5]

Add Cap for DVDD_DDR_RX ⁽u/IC)

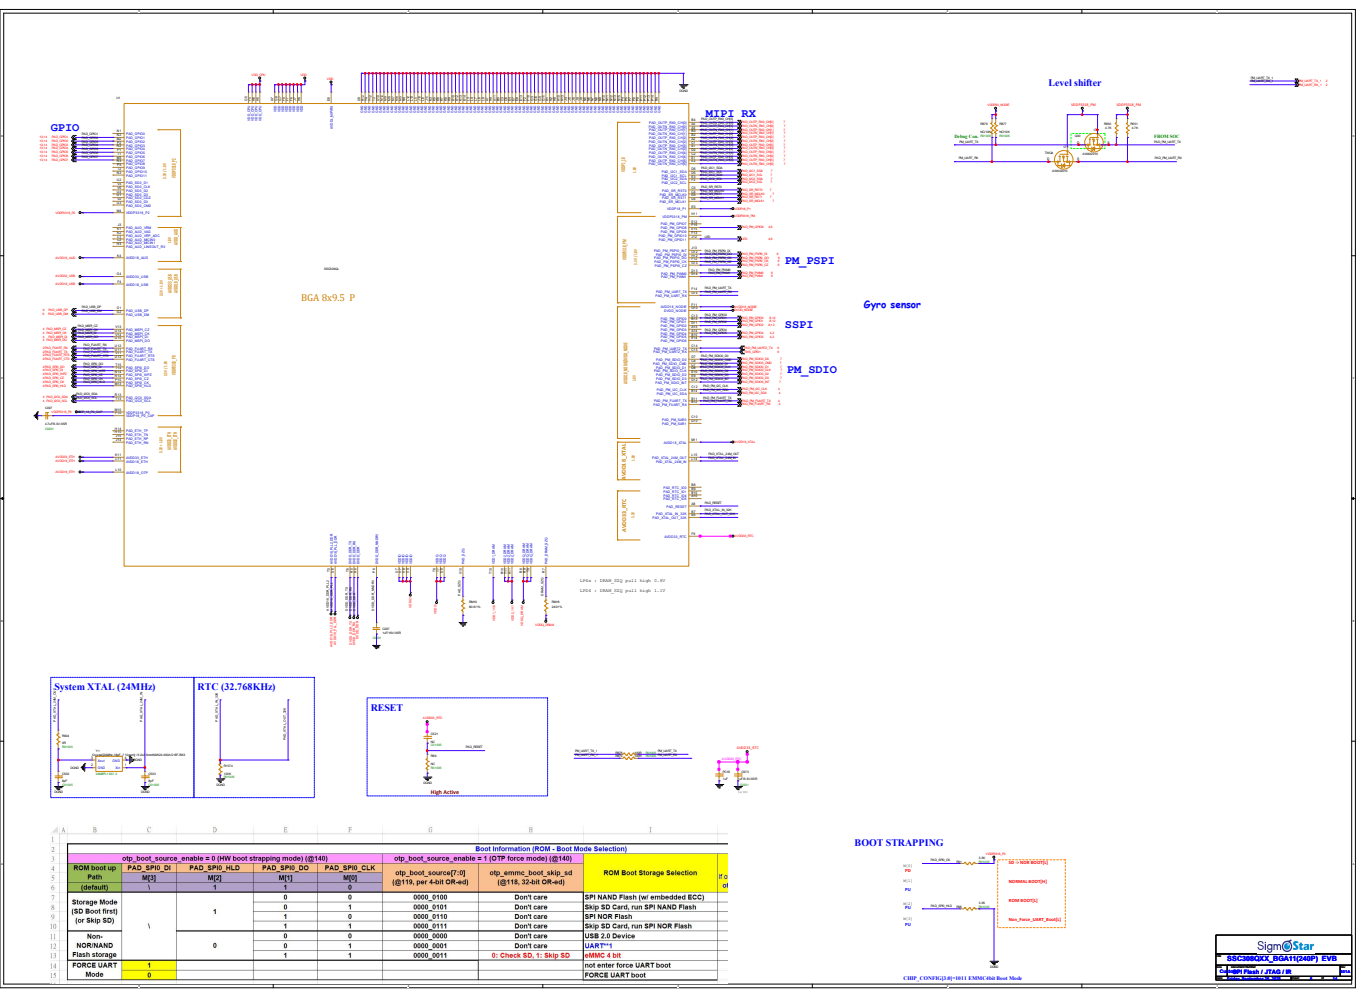
[picture p69: page 6]

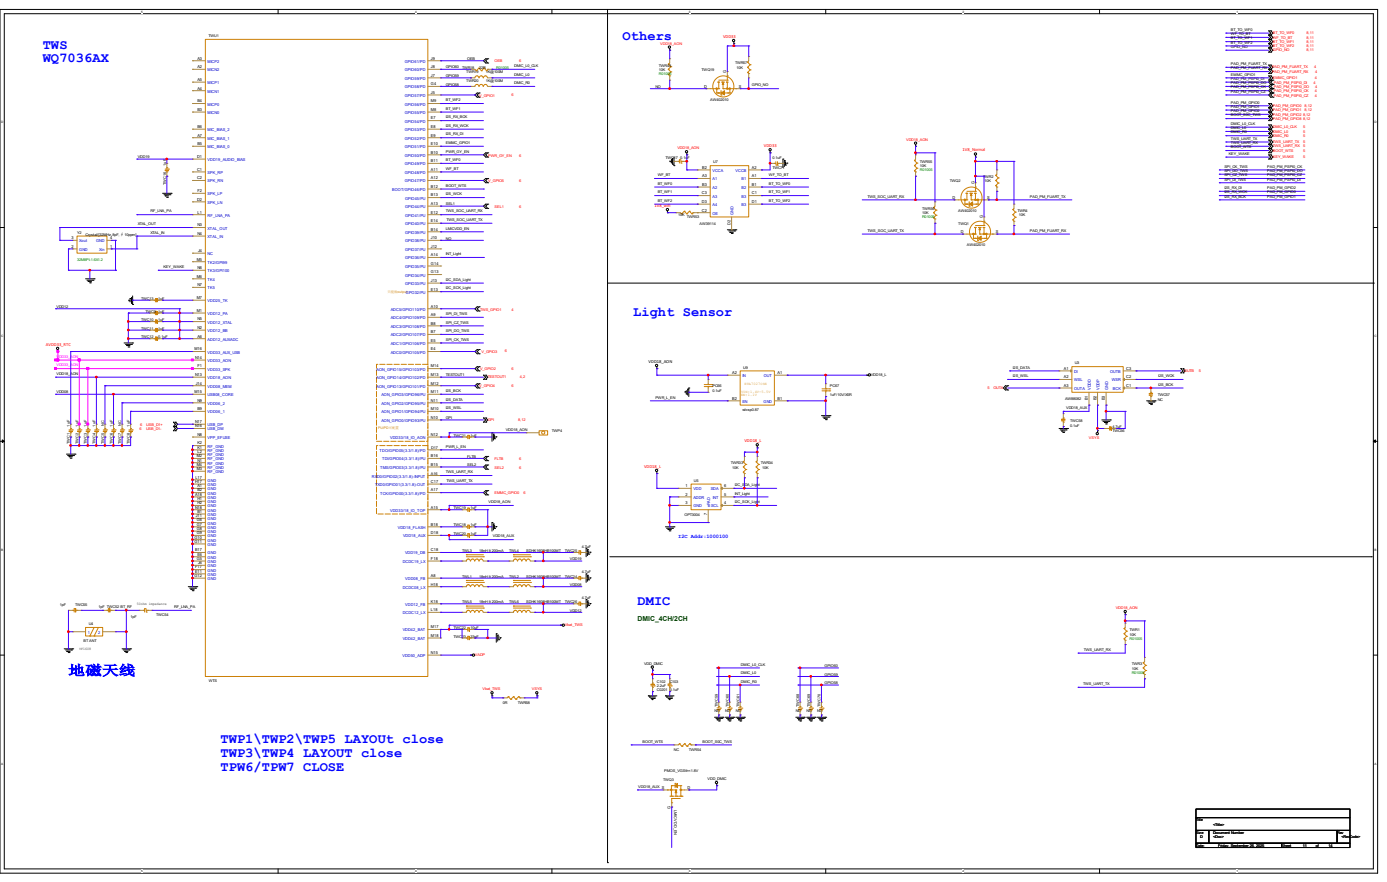
[picture p70: page 7]

0.1uF TWC¹⁶ ¹uF TWC³ ¹uF

5

4

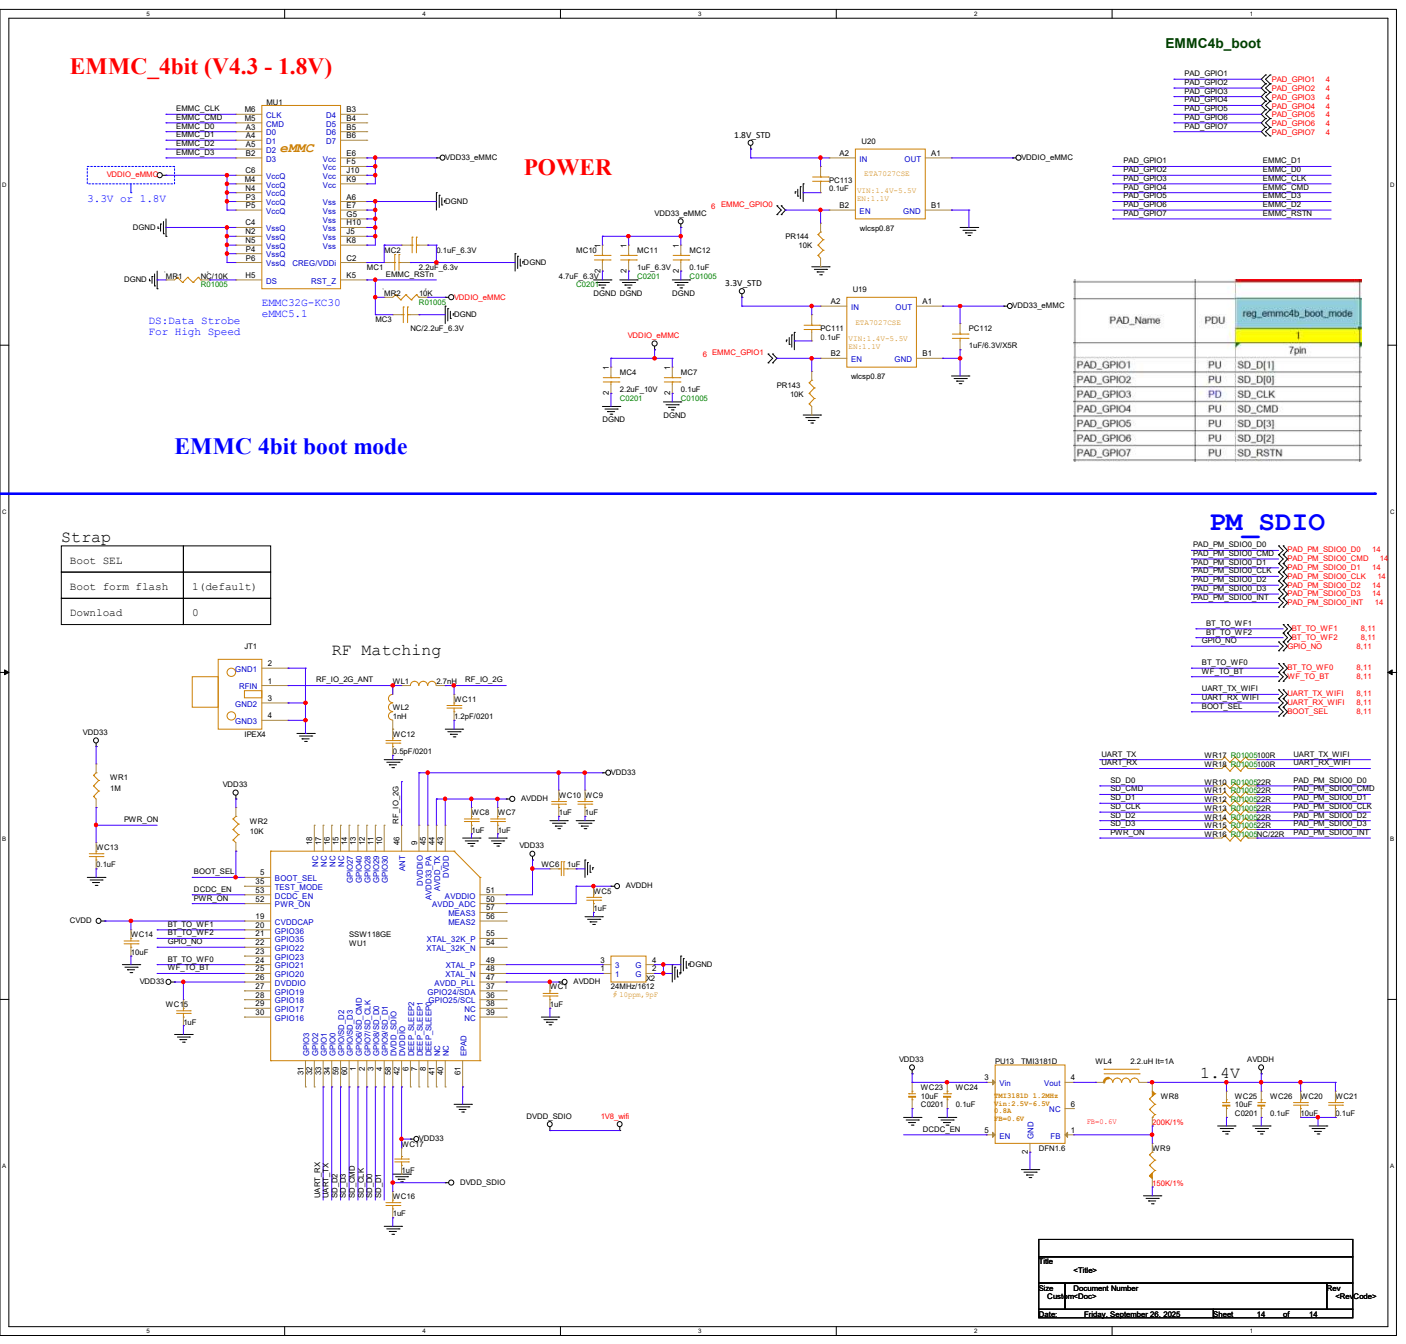
[picture p71: page 8]

9 GPIO30 10 GPIO29 11 GPIO28 12 GPIO40 13 GPIO27 14 NC 15 NC 16 NC 17 NC 18 CVDDCAP 19 GPIO36 20 GPIO35 21 GPIO22 22 GPIO23 23 GPIO21 24 GPIO20 25 DVDDIO 26 GPIO19 27 GPIO18 28 GPIO17 29 GPIO16 30 GPIO3 31 GPIO2 32 GPIO1 33 GPIO0 34 TEST_MODE 35 GPIO25/SCL 36 GPIO24/SDA 37 NC 38 NC 39 NC 40 NC 41 DVDDIO 42 DVDD 43 AVDD_TX 44 AVDD33_PA 45 ANT 46 AVDD_PLL 47 XTAL_N 48 XTAL_P 49 AVDD_ADC 50 AVDDIO 51 PWR_ON 52 DCDC_EN 53 XTAL_32K_N 54 XTAL_32K_P 55 MEAS2 MEAS3 56
