HuaqiuOpenHardware/Comake-Pi-D2/hardware/pcb/Comake-Pi-D2-V1.0_BGA8_9.5_Demo_20251215/extracted/Comake-Pi-D2-V1.0_BGA8_9.5_Demo_20251215/SSC309-S01C-AI-Mainboard_20251104.pdf

5

4

VDD_Core; VDD_Cpu; DVDD_NODIE; 3.3V_Nor; 1.8V_Nor; 1.8V_DDR; 1.1V_DDR; 0.6V_DDR; 1.8V_SEN; 2.8V_SEN; 1.05V_SEN; VDD18_AON/40mA VDD18_AUX/60mA; VDD33_AUX_USB; Vbat:3.3-4.2V; 3.3V_wifi; 1.8V_wifiTitle Size; Document Number; Rev Date:; Sheet; of <Doc>; <RevCode>; <Title> B; Friday, April 11, 2025; 14 Title Size

D D

REV | DESCRIPTION | DATE | APPROVED

Revision; Title Size; Document Number; Rev Date:; Sheet; of <Doc>; <RevCode>; <Title> Custom Wednesday, October 29, 2025; 14 Title Size

01A | Init | 2025/10/29

# MIPI PAD0

# MIPI PAD0

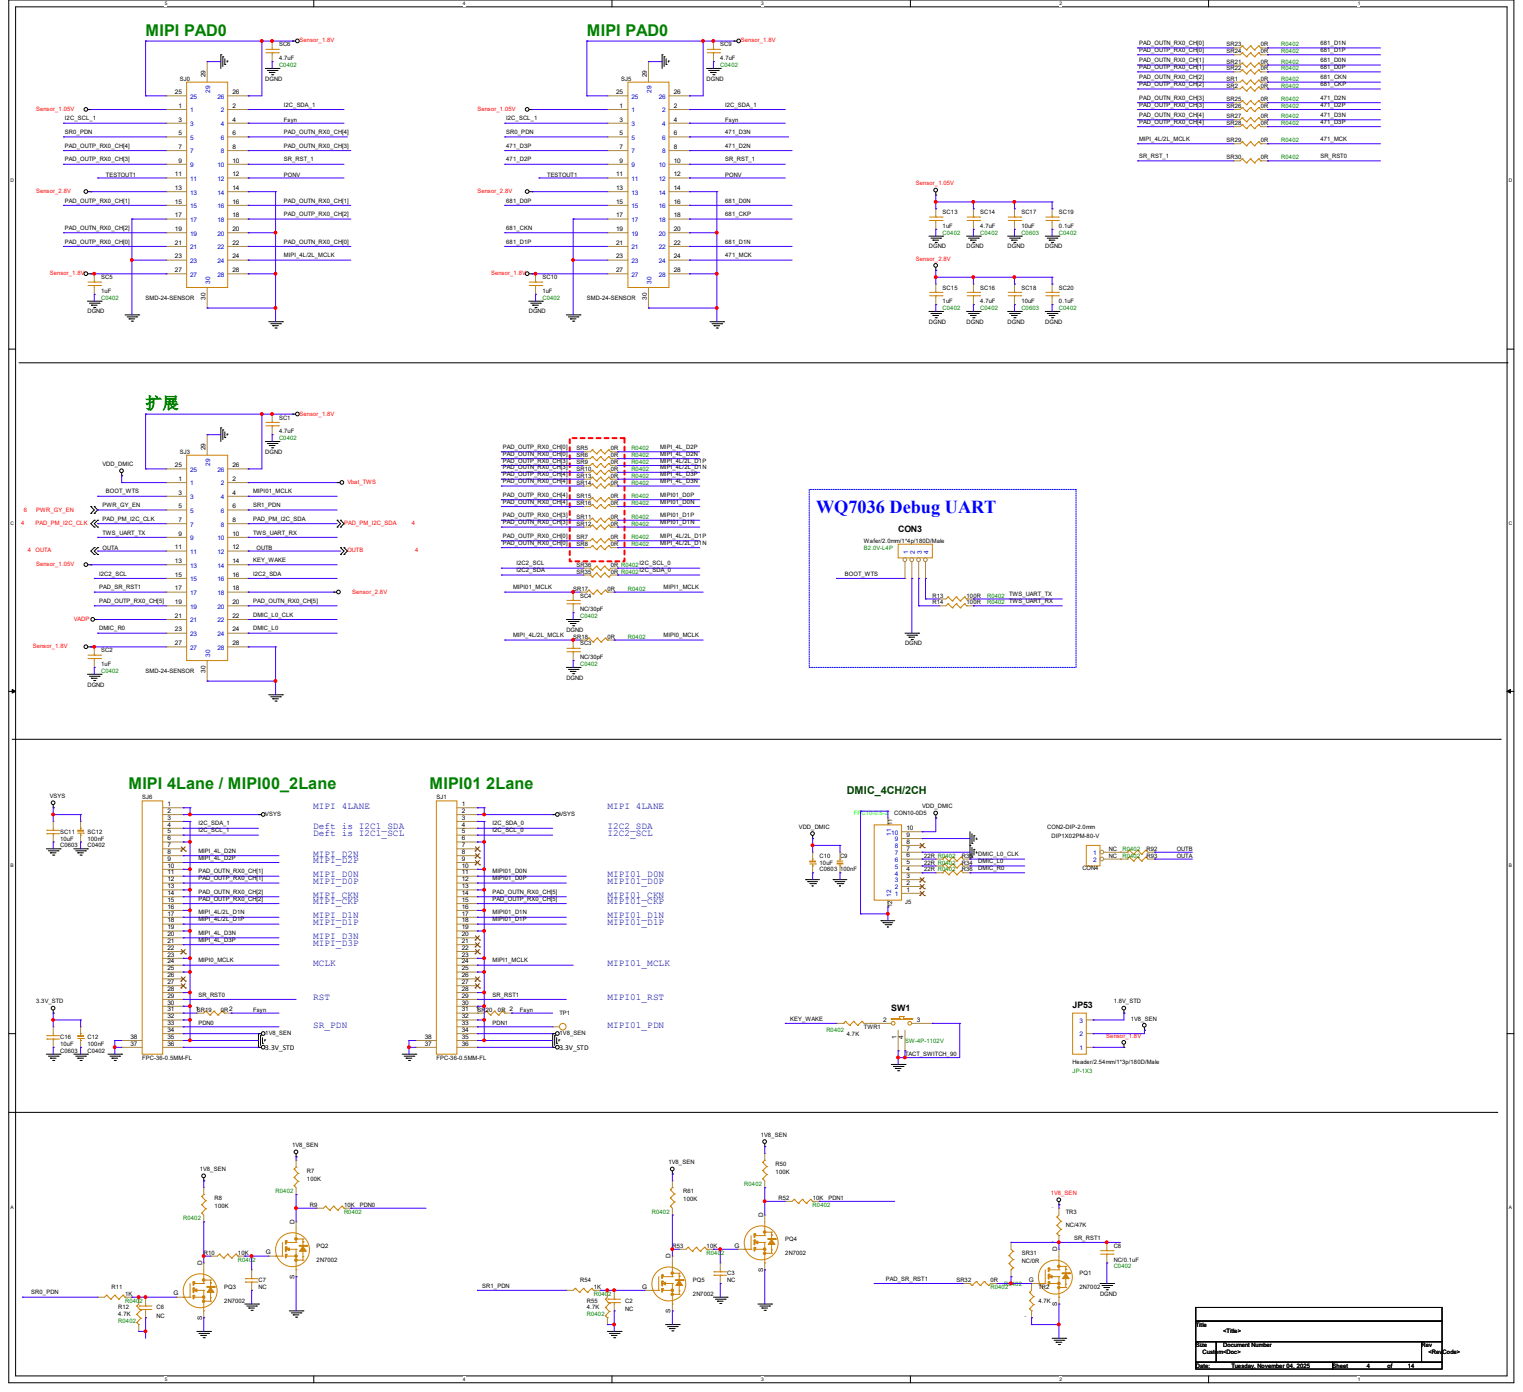
[picture p72: page 3]

# TYPE-C

扩展

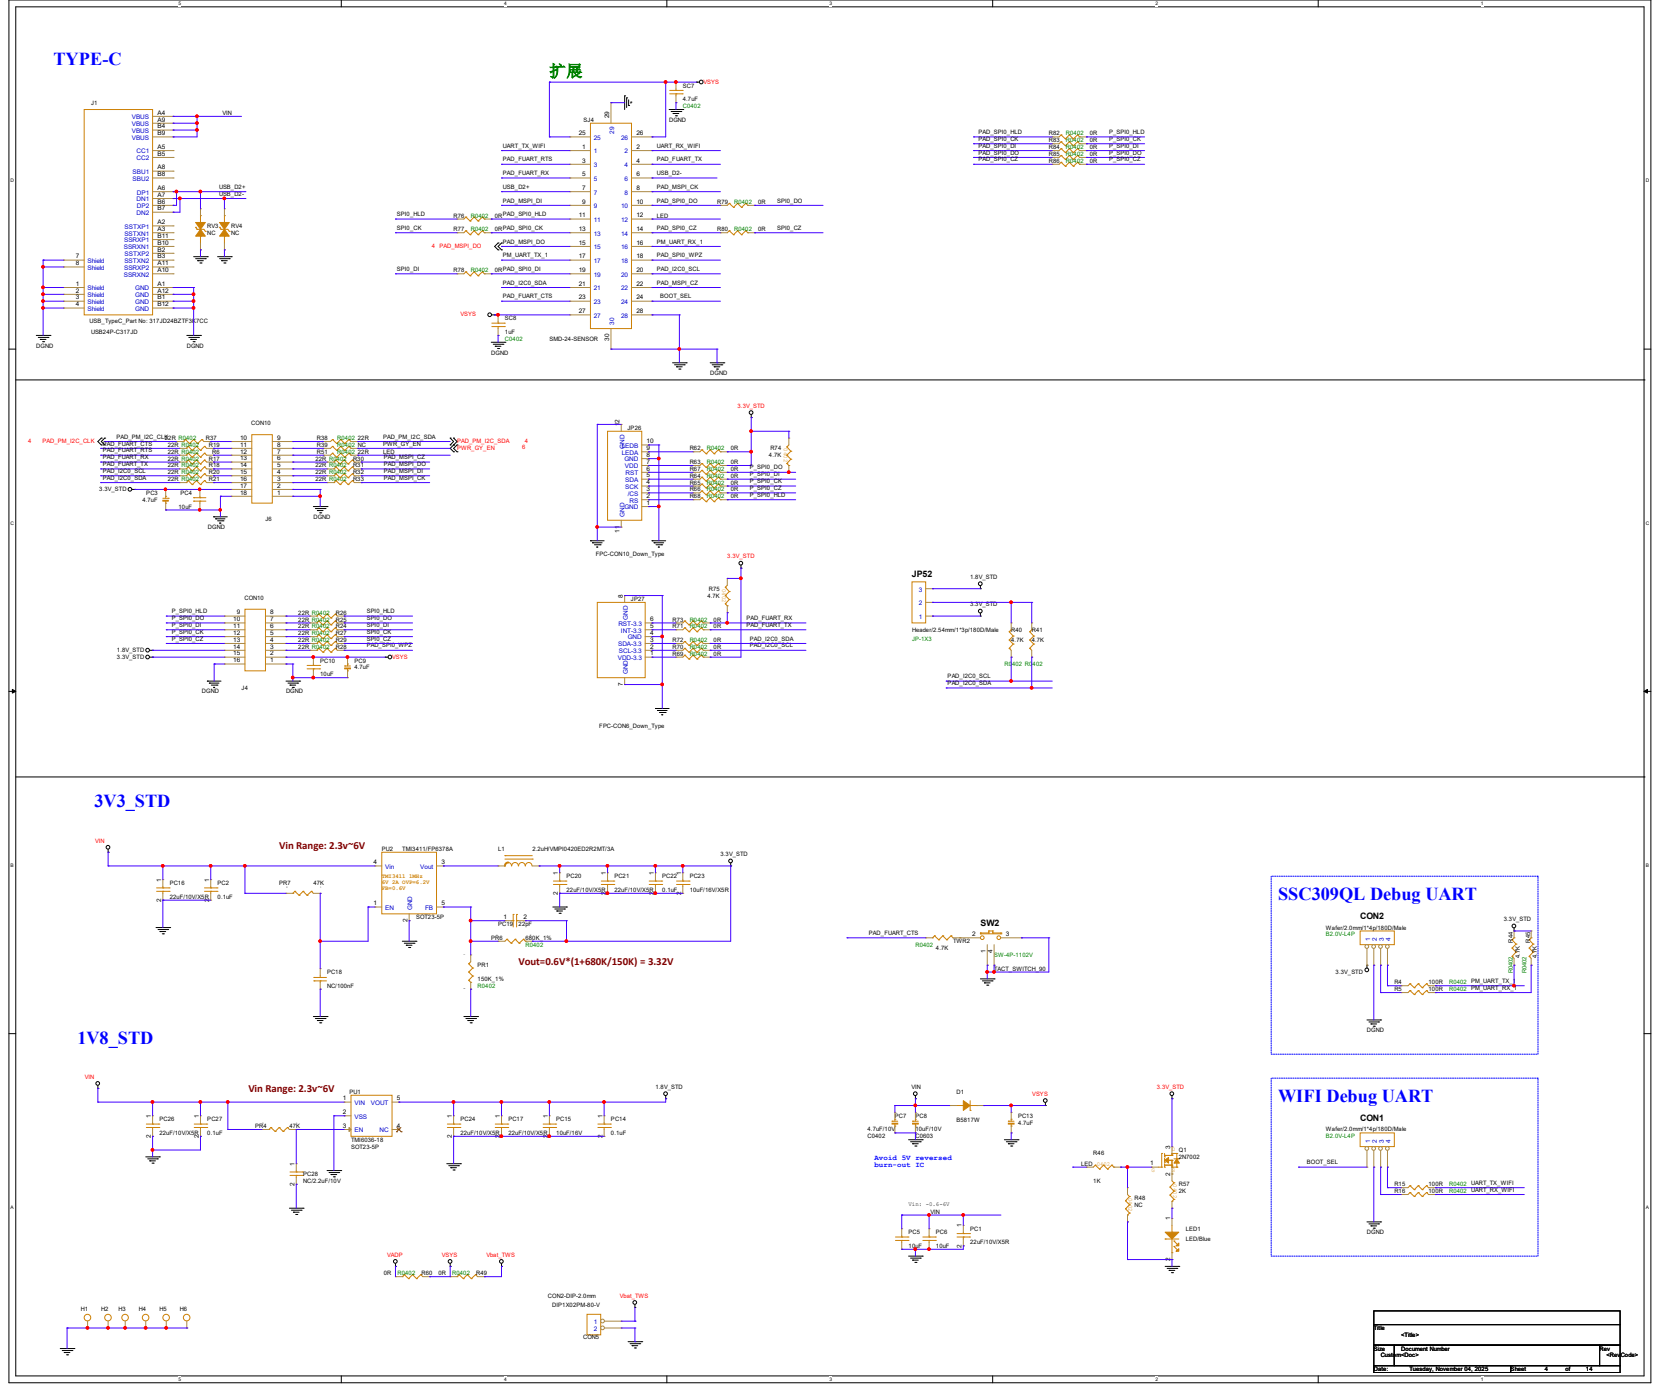
[picture p73: page 4]

/CS 3 SCK 4 SDA RST 5

P_SPI0_CZ P_SPI0_HLD
JP27 FPC-CON6_Down_Type VDD-3.3 1 SCL-3.3 2 SDA-3.3 GND 3

# Gyro sensor

# POWER_CTRL

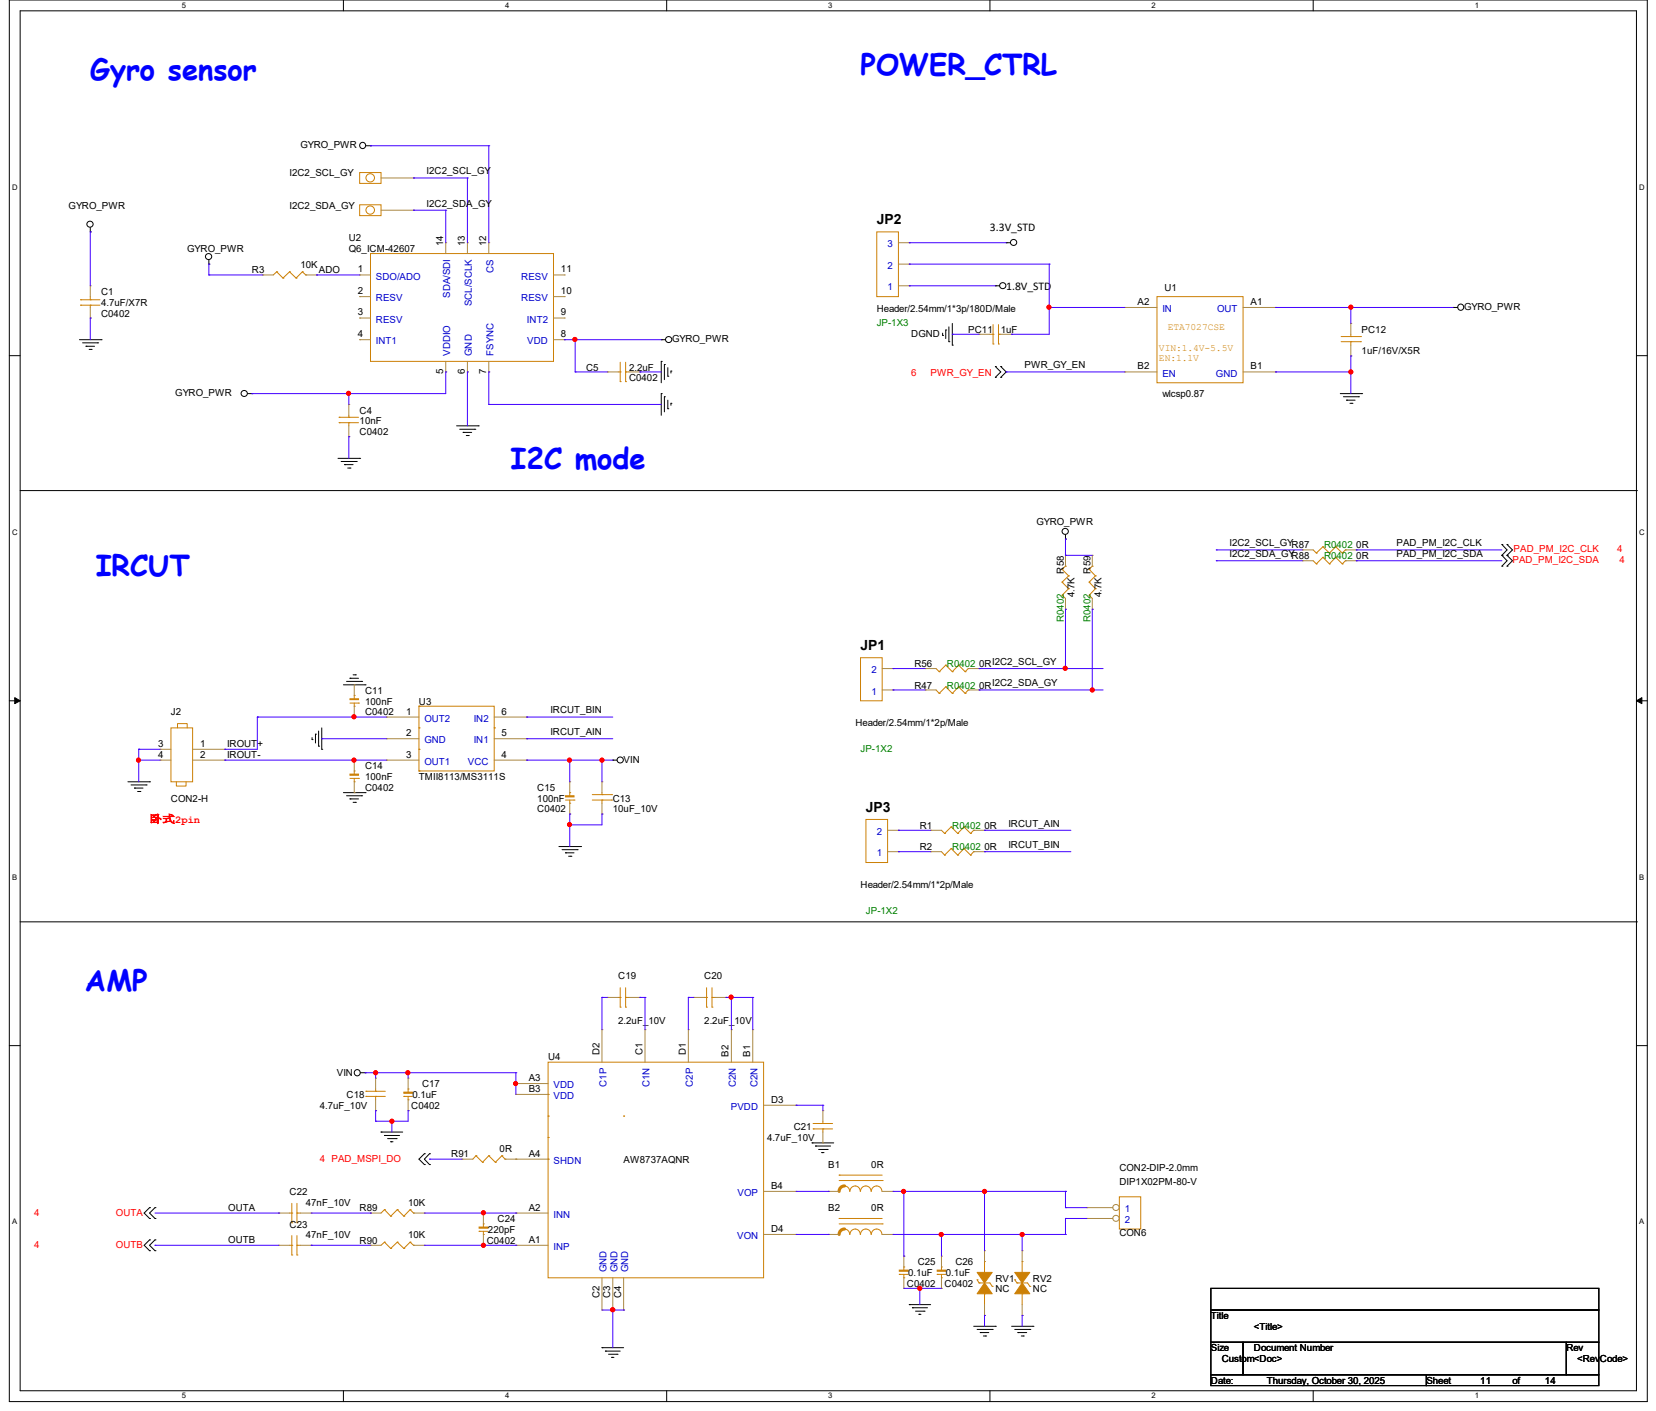
[picture p74: page 5]

U2 Q6_ICM-42607 SDO/ADO 1 RESV 2 RESV 3

11 ¹² SCL/SCLK ¹³ SDA/SDI 14
