HuaqiuOpenHardware/Comake-Pi-D2/hardware/pcb/Comake-Pi-D2-V2.0_BGA8_9.5_Demo_20260409/extracted/SSC309-S01D-AI-Demo_20260228 -位号.pdf

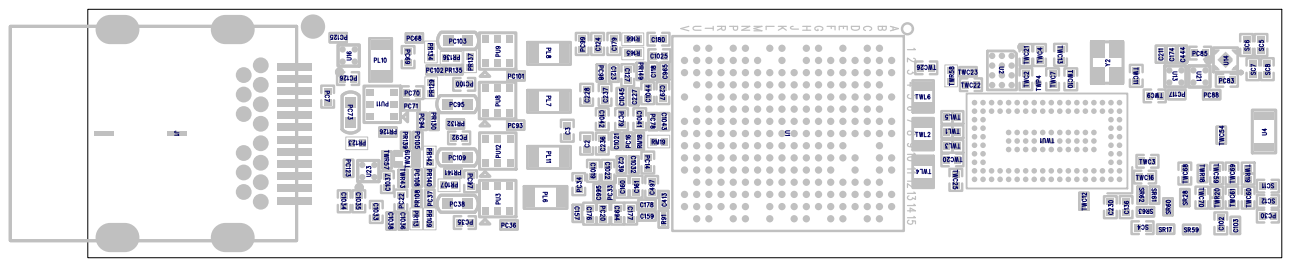
[picture p75: page 1]

U2U²xA¹ U²xA² U²xA³ U²xA⁴ U²xB¹ U²xB² U²xB³ U²xB⁴ U²xC¹ U²xC² U²xC³ U²xC⁴

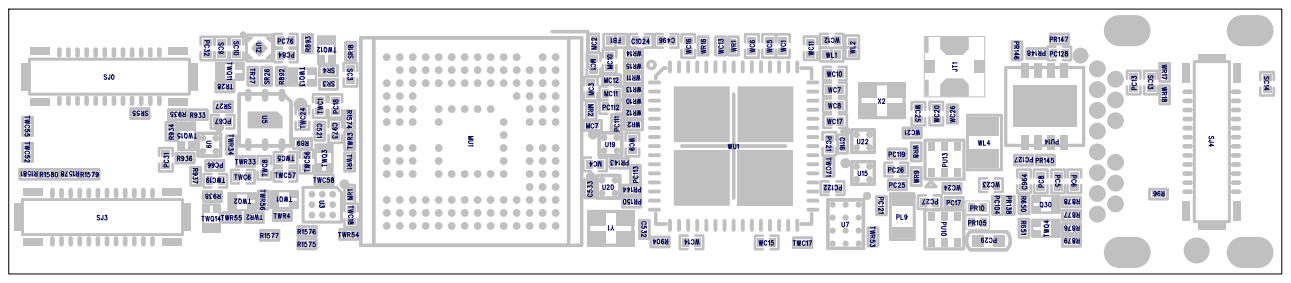
[picture p76: page 2]
