HuaqiuOpenHardware/Comake-Pi-D2/hardware/pcb/Comake-Pi-D2-V1.0_BGA8_9.5_Demo_20251215/extracted/Comake-Pi-D2-V1.0_BGA8_9.5_Demo_20251215/Comake-Pi-D2-V1.0_BGA8_9.5_Demo_20250926位号.pdf

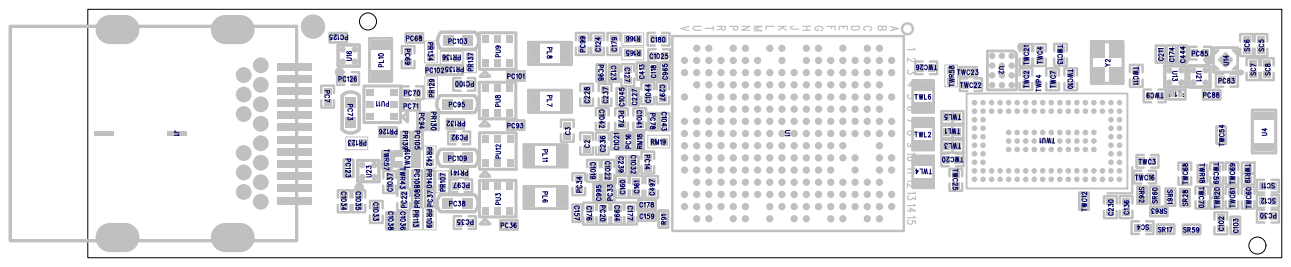
[picture p77: page 1]

U2U²xA¹ U²xA² U²xA³ U²xA⁴ U²xB¹ U²xB² U²xB³ U²xB⁴ U²xC¹ U²xC² U²xC³ U²xC⁴

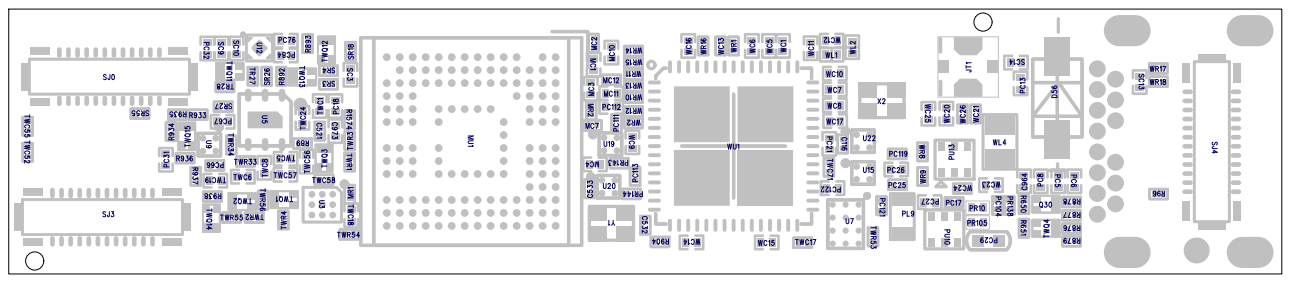
[picture p78: page 2]
