HuaqiuOpenHardware/Comake-Pi-D2/(list of files, drawings)

Other design files:
hardware/pcb/Comake-Pi-D2-V1.0_BGA8_9.5_Demo_20251215/extracted/Comake-Pi-D2-V1.0_BGA8_9.5_Demo_20251215/Comake-Pi-D2-V1.0_BGA8_9.5_Demo_20250926.DSN
hardware/pcb/Comake-Pi-D2-V1.0_BGA8_9.5_Demo_20251215/extracted/Comake-Pi-D2-V1.0_BGA8_9.5_Demo_20251215/Comake-Pi-D2-V1.0_BGA8_9.5_Demo_20250926.pcb
hardware/pcb/Comake-Pi-D2-V1.0_BGA8_9.5_Demo_20251215/extracted/Comake-Pi-D2-V1.0_BGA8_9.5_Demo_20251215/SSC309-S01C-AI-Mainboard_20251104.DSN
hardware/pcb/Comake-Pi-D2-V1.0_BGA8_9.5_Demo_20251215/extracted/Comake-Pi-D2-V1.0_BGA8_9.5_Demo_20251215/SSC309-S01C-AI-MAINBOARD_20251104.pcb
hardware/pcb/Comake-Pi-D2-V2.0_BGA8_9.5_Demo_20260409/extracted/Comake-Pi-D2-V2.0_BGA8_9.5_Demo_20260409/SSC309-S01D-AI-Demo_20260228 - 制板PCB.pcb
hardware/pcb/Comake-Pi-D2-V2.0_BGA8_9.5_Demo_20260409/extracted/Comake-Pi-D2-V2.0_BGA8_9.5_Demo_20260409/SSC309-S01D-AI-Mainboard_20260228.DSN
hardware/pcb/Comake-Pi-D2-V2.0_BGA8_9.5_Demo_20260409/extracted/Comake-Pi-D2-V2.0_BGA8_9.5_Demo_20260409/SSC309-S01D-AI-MAINBOARD_20260228.pcb
hardware/pcb/Comake-Pi-D2-V2.0_BGA8_9.5_Demo_20260409/extracted/Comake-Pi-D2-V2.0_BGA8_9.5_Demo_20260409/SSC309-S01D-AI-SCH_20260206.DSN
hardware/pcb/Comake-Pi-D2-V2.0_BGA8_9.5_Demo_20260409/extracted/SSC309-S01D-AI-Demo_20260228 - 制板PCB.pcb
hardware/pcb/Comake-Pi-D2-V2.0_BGA8_9.5_Demo_20260409/extracted/SSC309-S01D-AI-Mainboard_20260228.DSN
hardware/pcb/Comake-Pi-D2-V2.0_BGA8_9.5_Demo_20260409/extracted/SSC309-S01D-AI-MAINBOARD_20260228.pcb
hardware/pcb/Comake-Pi-D2-V2.0_BGA8_9.5_Demo_20260409/extracted/SSC309-S01D-AI-SCH_20260206.DSN
hardware/pcb/Comake-Pi-D2-V2.0_核心板/extracted/Comake-Pi-D2-V2.0_核心板/SSC309-S01D-AI-Demo_20260228 - 制板PCB.pcb
hardware/pcb/Comake-Pi-D2-V2.0_核心板/extracted/Comake-Pi-D2-V2.0_核心板/SSC309-S01D-AI-SCH_20260206.DSN
hardware/pcb/Comake-Pi-D2-V2.0_载板/extracted/Comake-Pi-D2-V2.0_载板/SSC309-S01D-AI-Mainboard_20260228.DSN
hardware/pcb/Comake-Pi-D2-V2.0_载板/extracted/Comake-Pi-D2-V2.0_载板/SSC309-S01D-AI-MAINBOARD_20260228.pcb
